dylanastrup/erh2/TeamsFiles_5_1_2023/Test Readiness/image-20230420-182038-73f4511a.jpeg

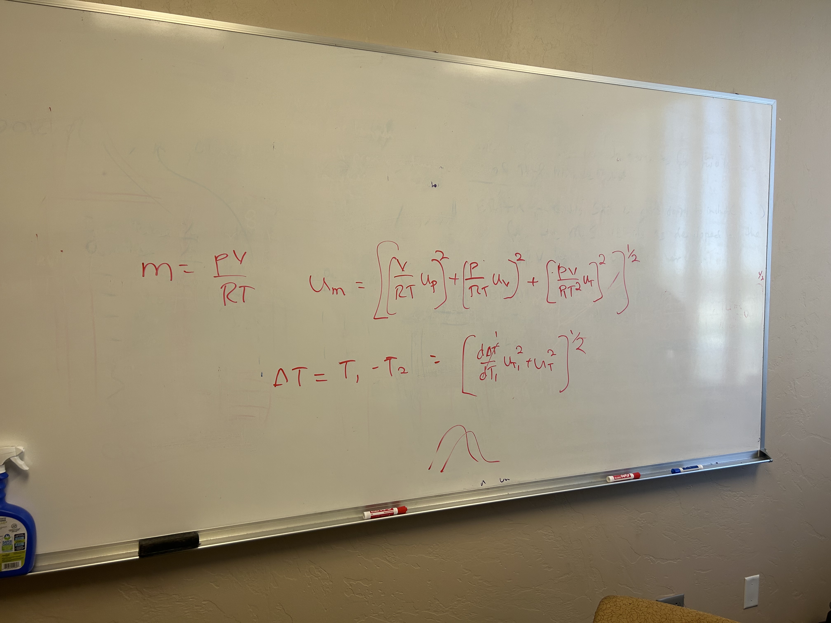
TeamsFiles_5_1_2023/Test Readiness/image-20230420-182038-73f4511a.jpeg
