dylanastrup/erh2/assets/images/grant.png

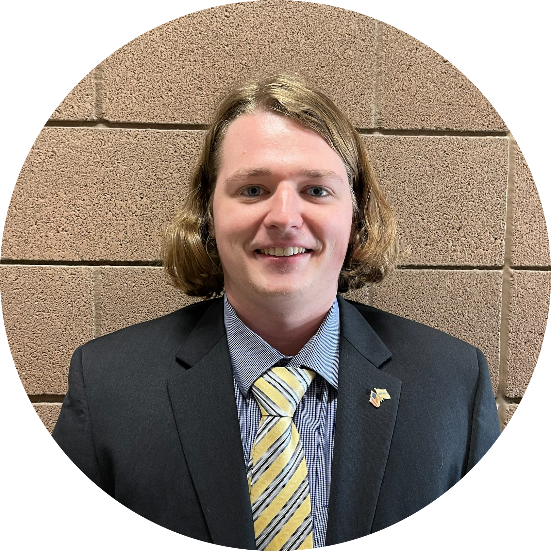
assets/images/grant.png
