dylanastrup/erh2/assets/files/PDR.pdf

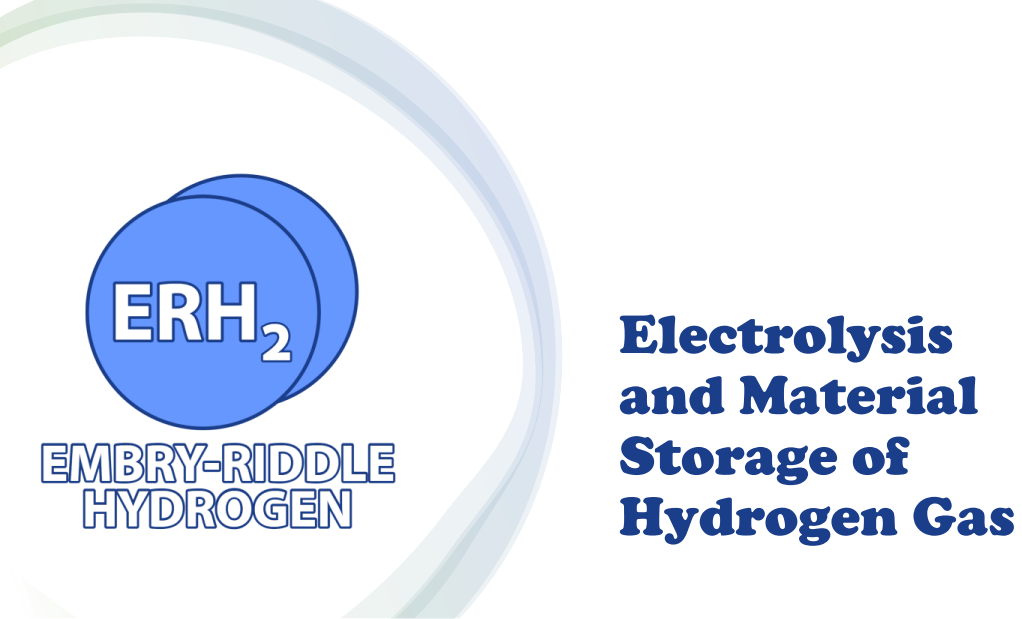
[picture p23: page 1]
Electrolysis and Material Storage of Hydrogen Gas

# Team Members

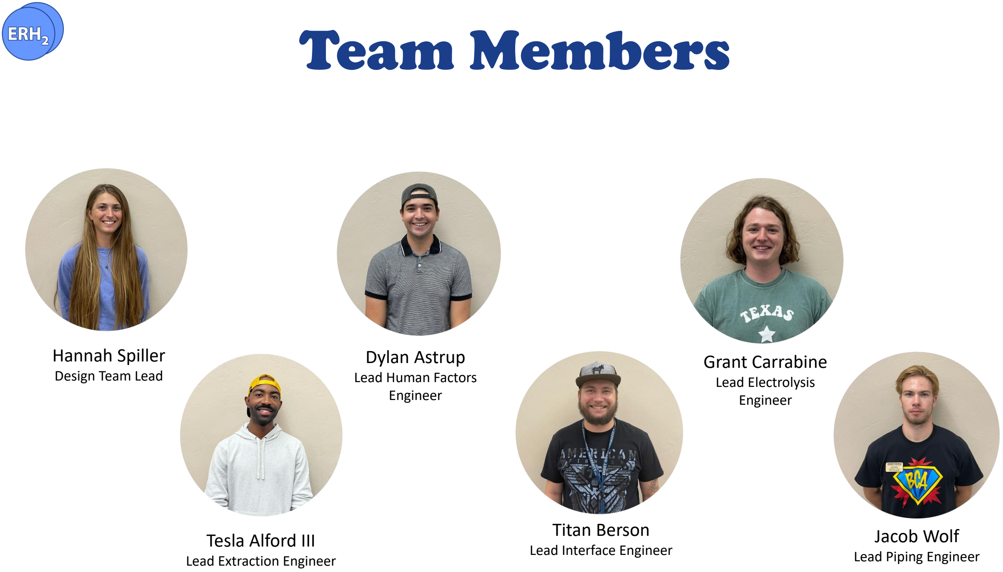
[picture p24: page 2]

Hannah Spiller
Design Team Lead

Tesla Alford III
Lead Extraction Engineer

Dylan Astrup
Lead Human Factors
Engineer

Grant Carrabine
Lead Electrolysis
Engineer

Jacob Wolf
Lead Piping Engineer

Titan Berson
Lead Interface Engineer

# Agenda

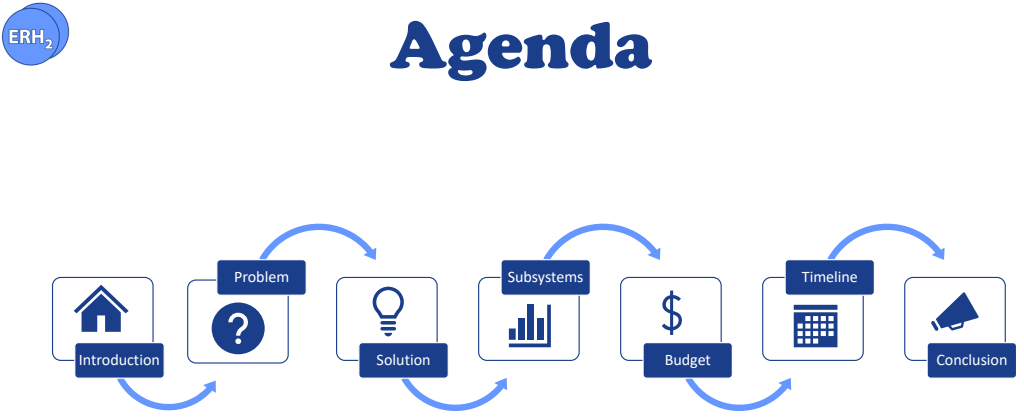
[picture p25: page 3]
Introduction; Problem; Solution; Subsystems; Budget; Timeline; Conclusion

# What Embry-Riddle Has

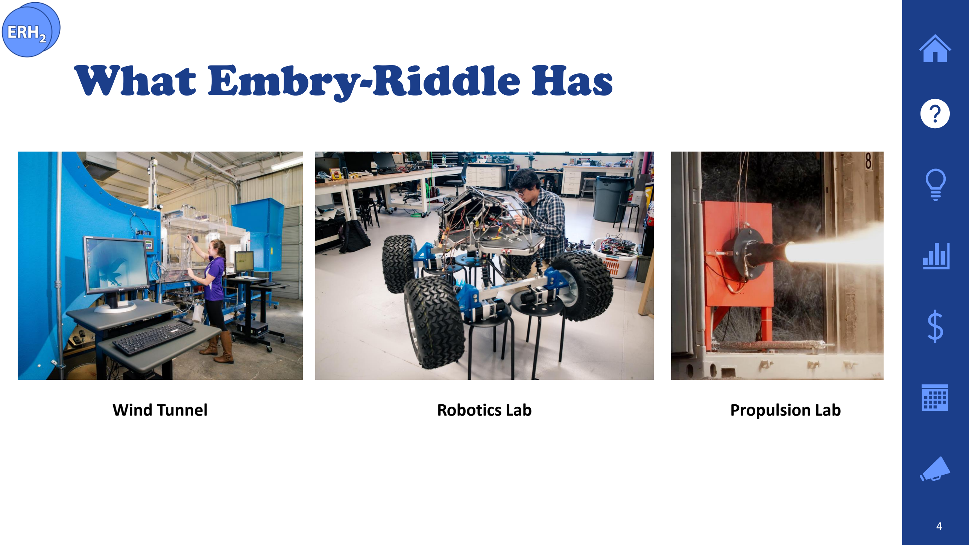
[picture p26: page 4]

Wind Tunnel | Robotics Lab | Propulsion Lab

# Embry-Riddle does not have

# Energy Labs

# Energy Classrooms

# Viewable Demonstrations

# DOE Research into Hydrogen

The DOE is researching multiple uses for hydrogen gas,

## producing the need for more hydrogen. This creates interest within Embry-Riddle to create an alternative energy demonstrator that teaches the general public

about hydrogen fuel and storage.

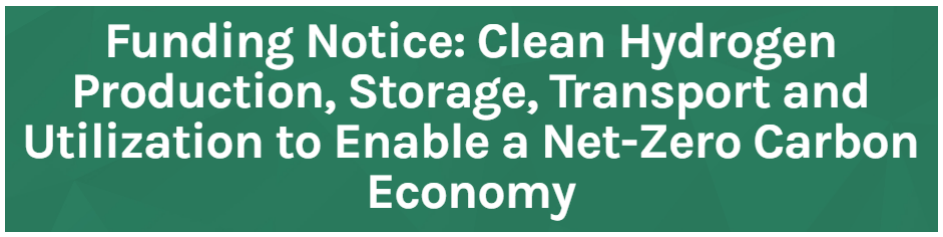
[picture p27: figure]

# Amount: $32 million

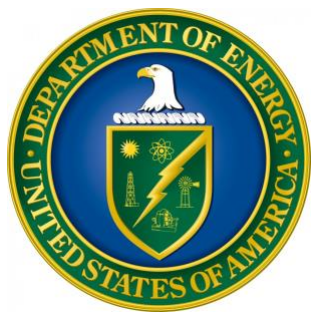
[picture p28: figure]

# Generate and Store Hydrogen

# ERH2’s purpose is to create a demonstrator to generate and

store hydrogen.

# Benefits of ERH2 System

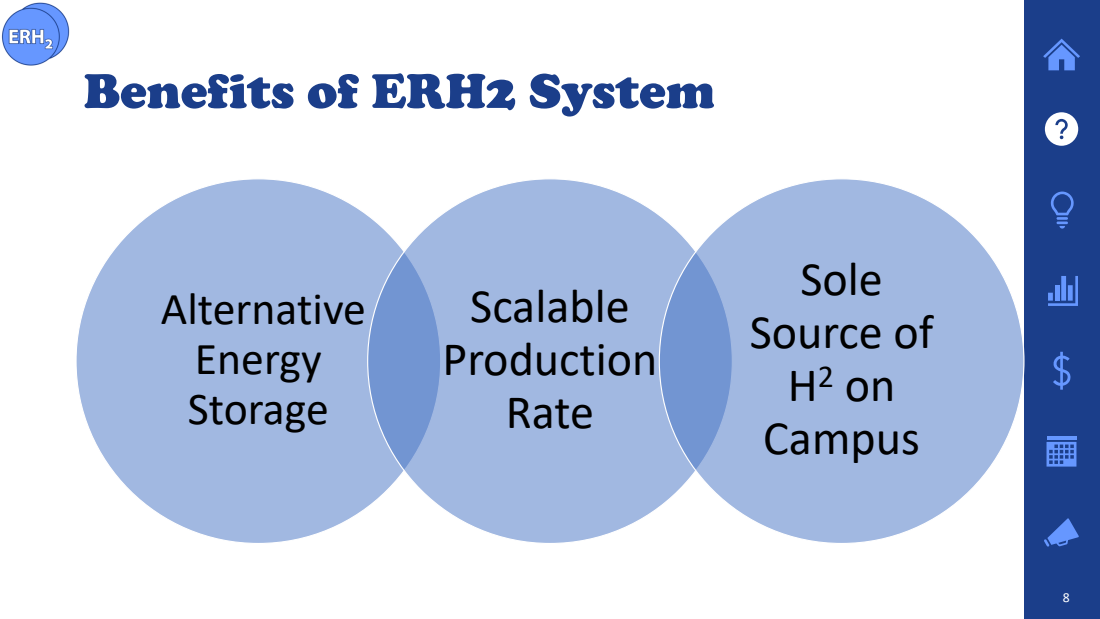
[picture p29: page 8]
Alternative Energy Storage; Scalable Production Rate; Sole Source of H² on Campus

# The ERH2 System

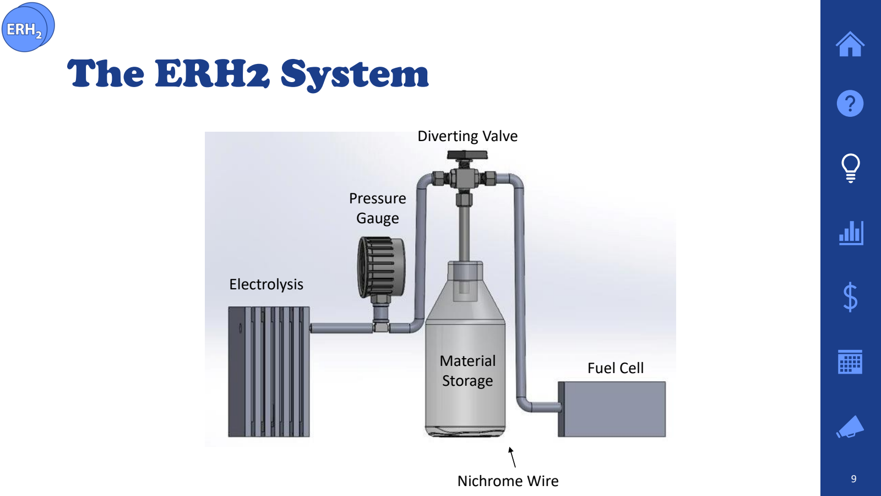
[picture p30: page 9]

Electrolysis

Pressure
Gauge

Nichrome Wire

Material
Storage

Fuel Cell

Diverting Valve

# Process Flow Diagram

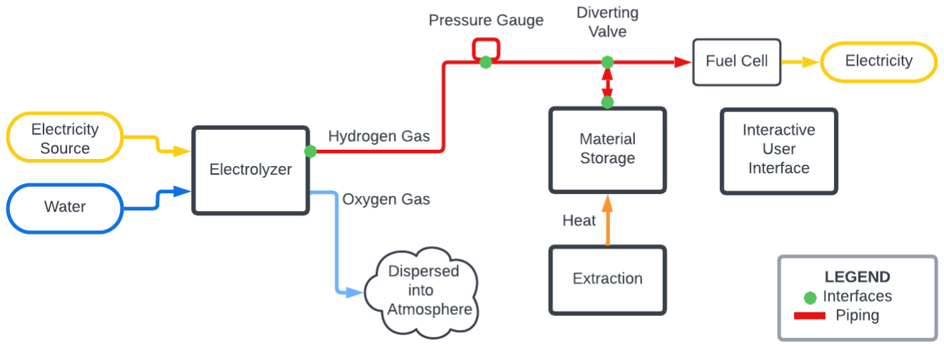
[picture p31: figure]

Simplified PFD

# Critical System Requirements

## Produce 0.02 grams of hydrogen over 10 minutes

## Store 0.04 grams of hydrogen

## Safely extract hydrogen from system

## Internal components visible

# Electrolysis Equation

# 2H2O 2H2 + O2

# Hydrogen Production Requirement

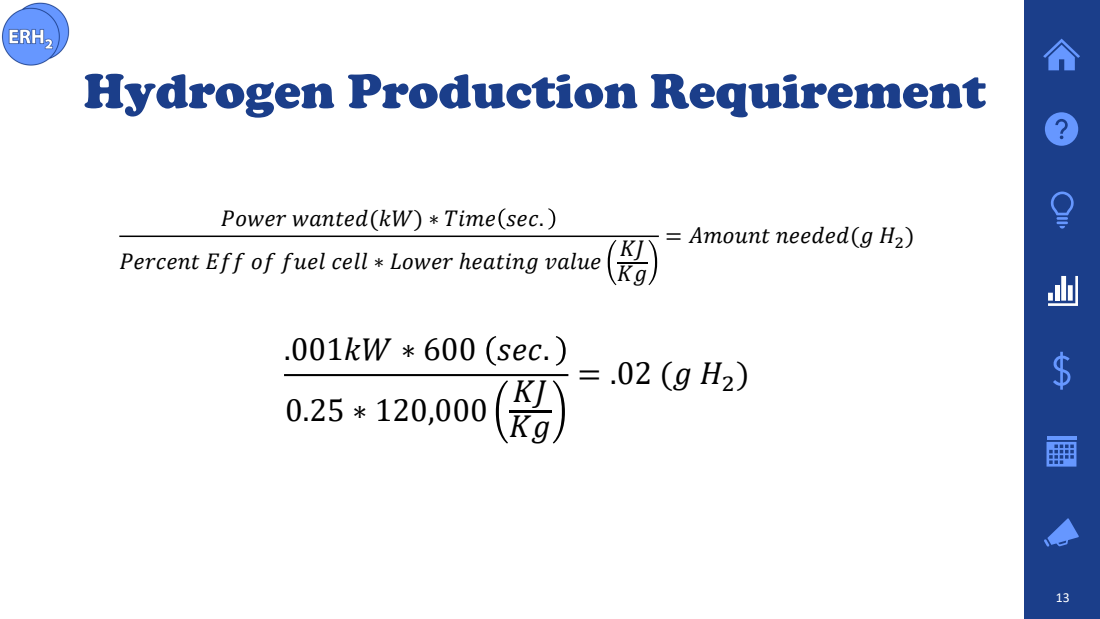
[picture p32: page 13]
= Amount needed(g H2); .001kW ∗ 600 sec. 0.25 ∗ 120,000 KJ Kg

Power wanted(kW) ∗ Time sec.

Percent Eff of fuel cell ∗ Lower ℎeating value KJ

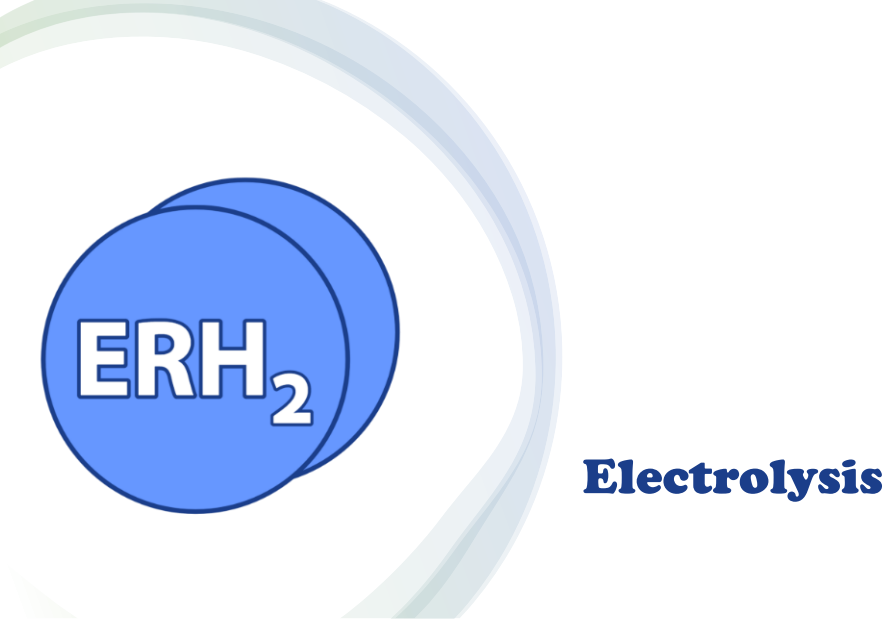
[picture p33: page 14]
Electrolysis

# Electrolysis Breakdown

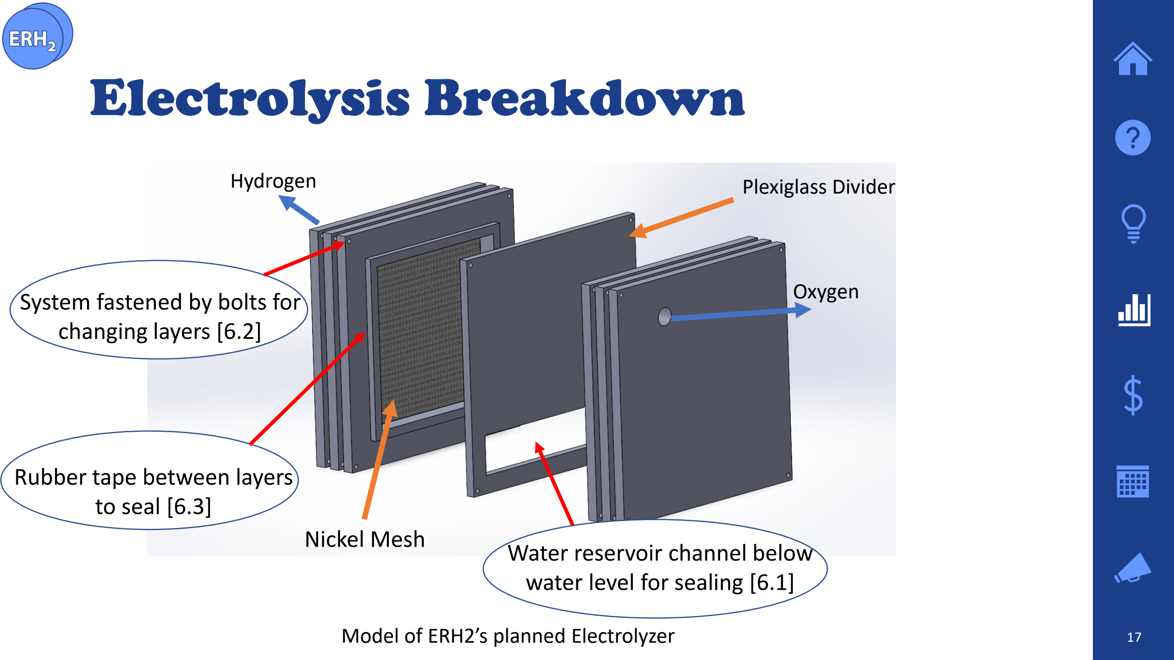
[picture p34: page 15]

Hydrogen | Plexiglass Divider

Nickel Mesh

Model of ERH2’s planned Electrolyzer

Oxygen

Water reservoir channel below water level for sealing [6.1]

System fastened by bolts for changing layers [6.2]

Rubber tape between layers to seal [6.3]

# Mesh Section-View

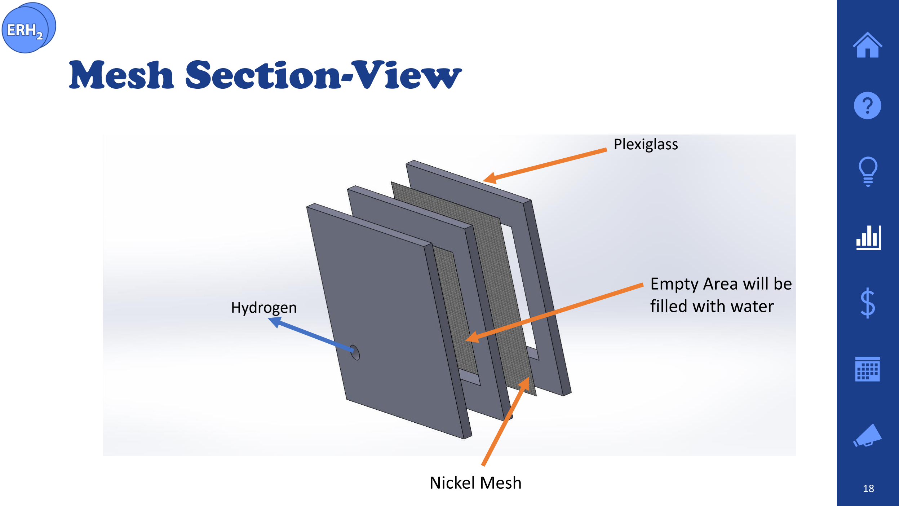
[picture p35: page 16]

Plexiglass

Hydrogen

Nickel Mesh

Empty Area will be
filled with water

# Power Supply

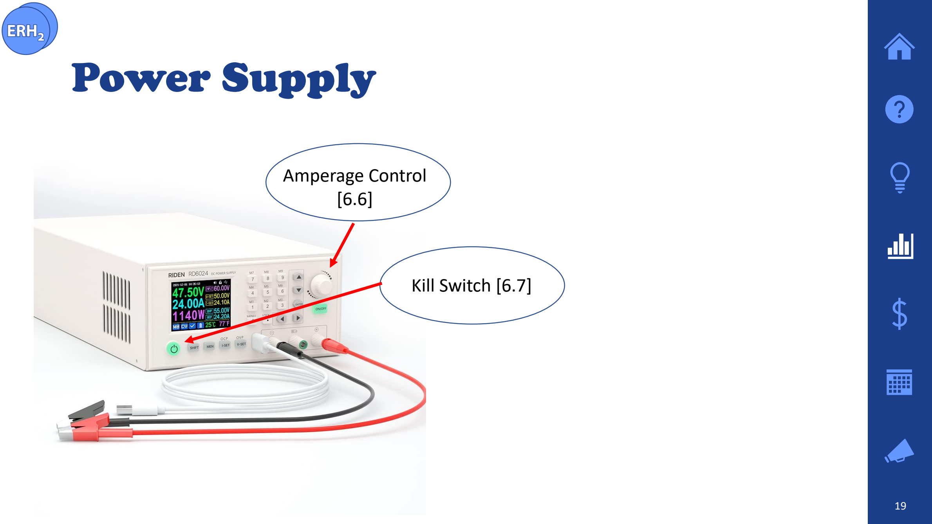
[picture p36: page 17]

## 20-24 Amps 60 Volts

Kill Switch [6.7]

Amperage Control
[6.6]

# Faraday’s Law of Electrolysis

## Rate of H2 Production

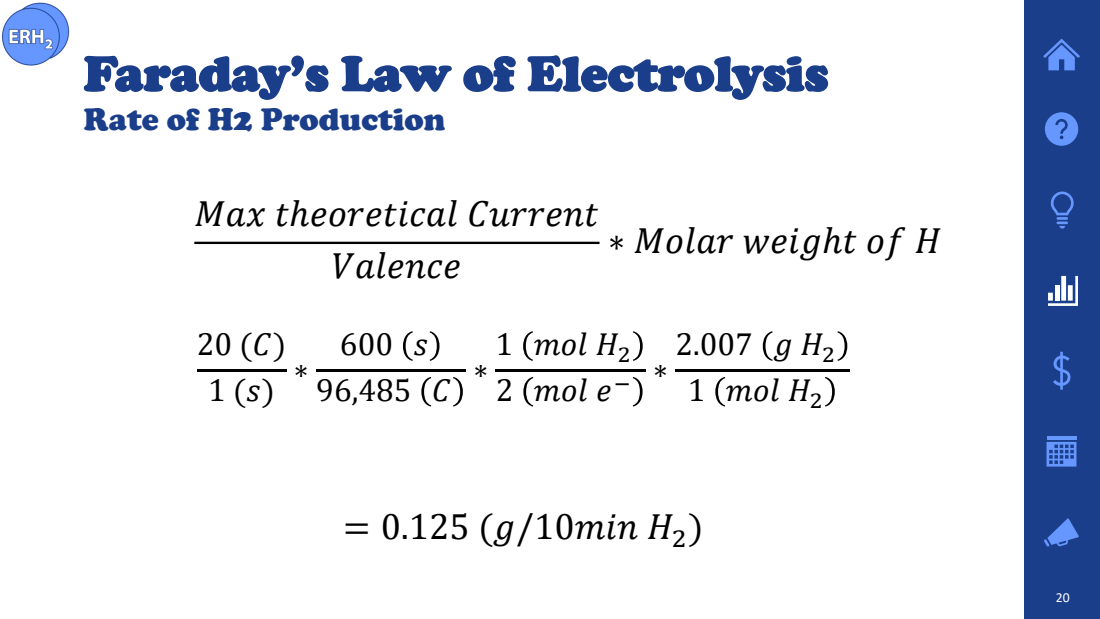
[picture p37: page 18]
1 mol H2 2 mol e; 2.007 g H2 1 mol H2; = 0.125 (g/10min H2); Valence

Max tℎeoretical Current

∗ Molar weigℎt of H

# Electrolysis Power Circuit

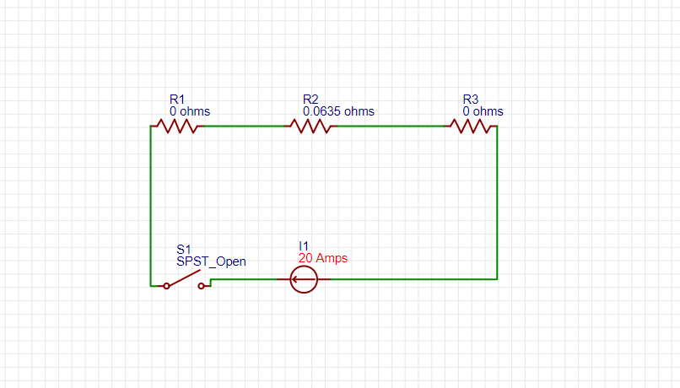
[picture p38: figure]

R1 = R3

# - Nickel Mesh

R2

# - Salt Water

# Electrolysis Summary

Requirement | Design | Expected Performance | Verification
6.1 | The hydrogen and oxygen will be separated at creation | 100% | Fuel Cell Runs
6.2 | The system was designed to be sandwiched together into different layers making it replaceable | Life of bolts used | It will come apart
6.3 Ability to bolt together | | The life span of seals | It will come apart

# Electrolysis Summary

Requirement | Design | Expected Performance | Verification
6.4 | Will be made of plastic | Nonconductive | Voltmeter
6.5 | Will use 12-gauge wire | Rated for 20 amp | National Electrical code
6.6 | Will set power supply to max 20 amps | Max 20 amps | Power supply read out
6.7 | Have and on off switch | 100% | System turns off

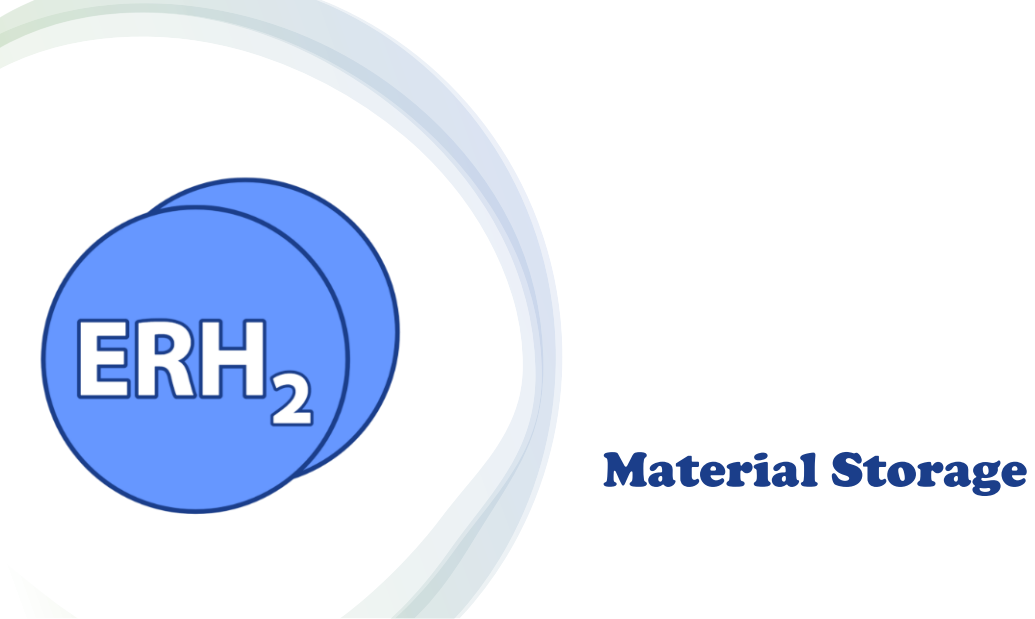
[picture p39: page 22]
Material Storage

# System Requirements

1.2

## “The system must store 0.04 grams of hydrogen gas.”

4.1

### “The material storage efficiency (hydrogen in vs. hydrogen out) must be at least 50%.”

# Lithium-Doped Graphitic Carbon

# Nitride [Li2C4N3/ Li2C4N4]

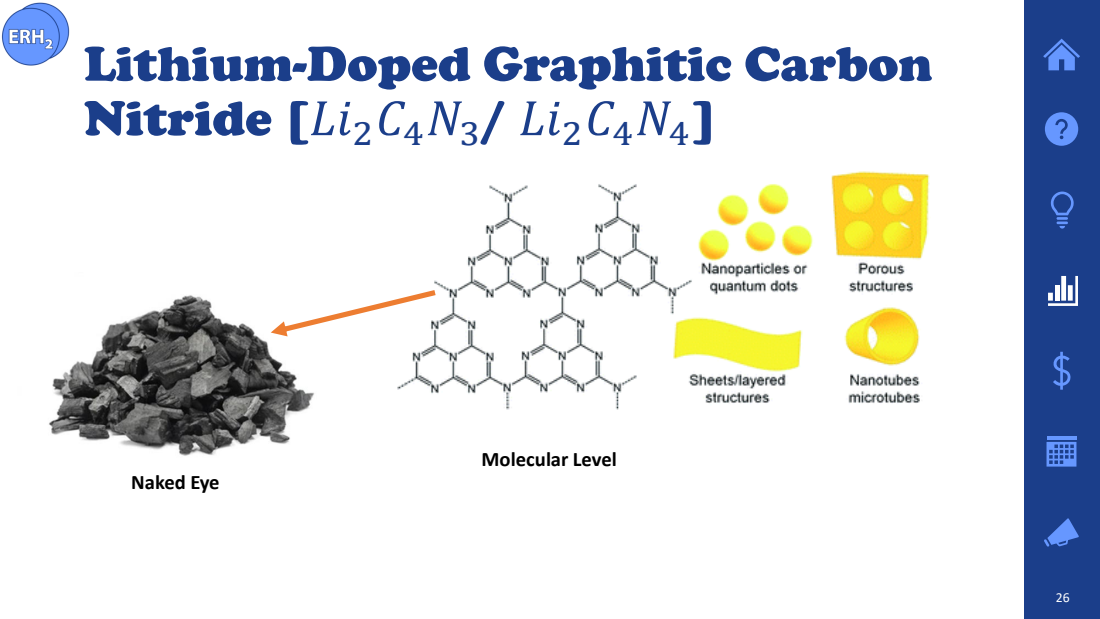
[picture p40: page 24]
Molecular Level; Naked Eye

# Subsystem Definition

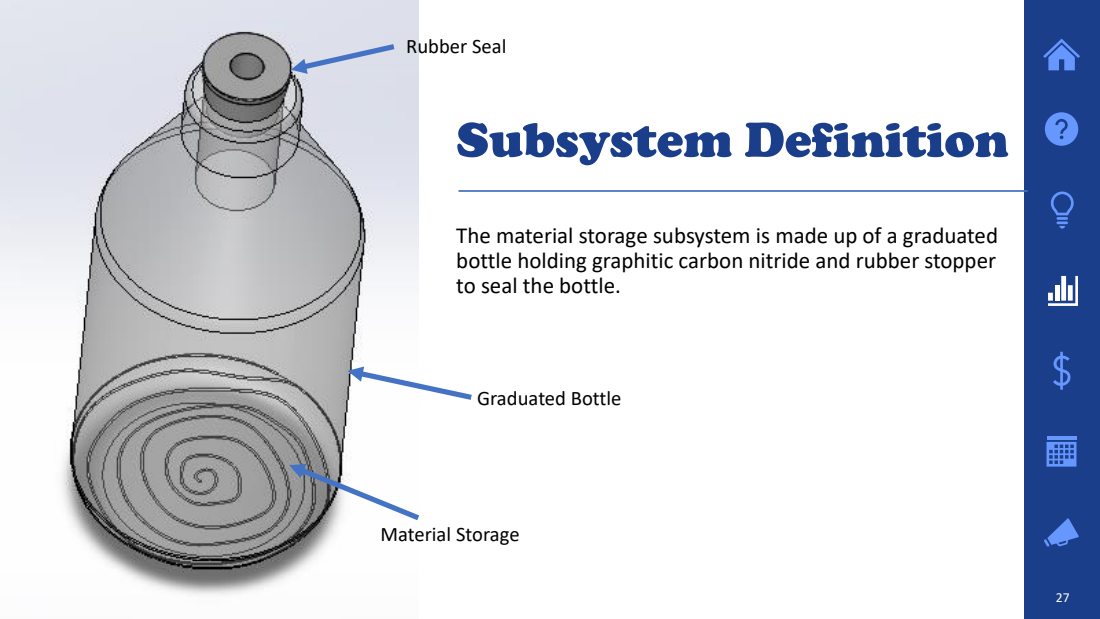
[picture p41: page 25]
Material Storage; Graduated Bottle; Rubber Seal

The material storage subsystem is made up of a graduated
bottle holding graphitic carbon nitride and rubber stopper
to seal the bottle.

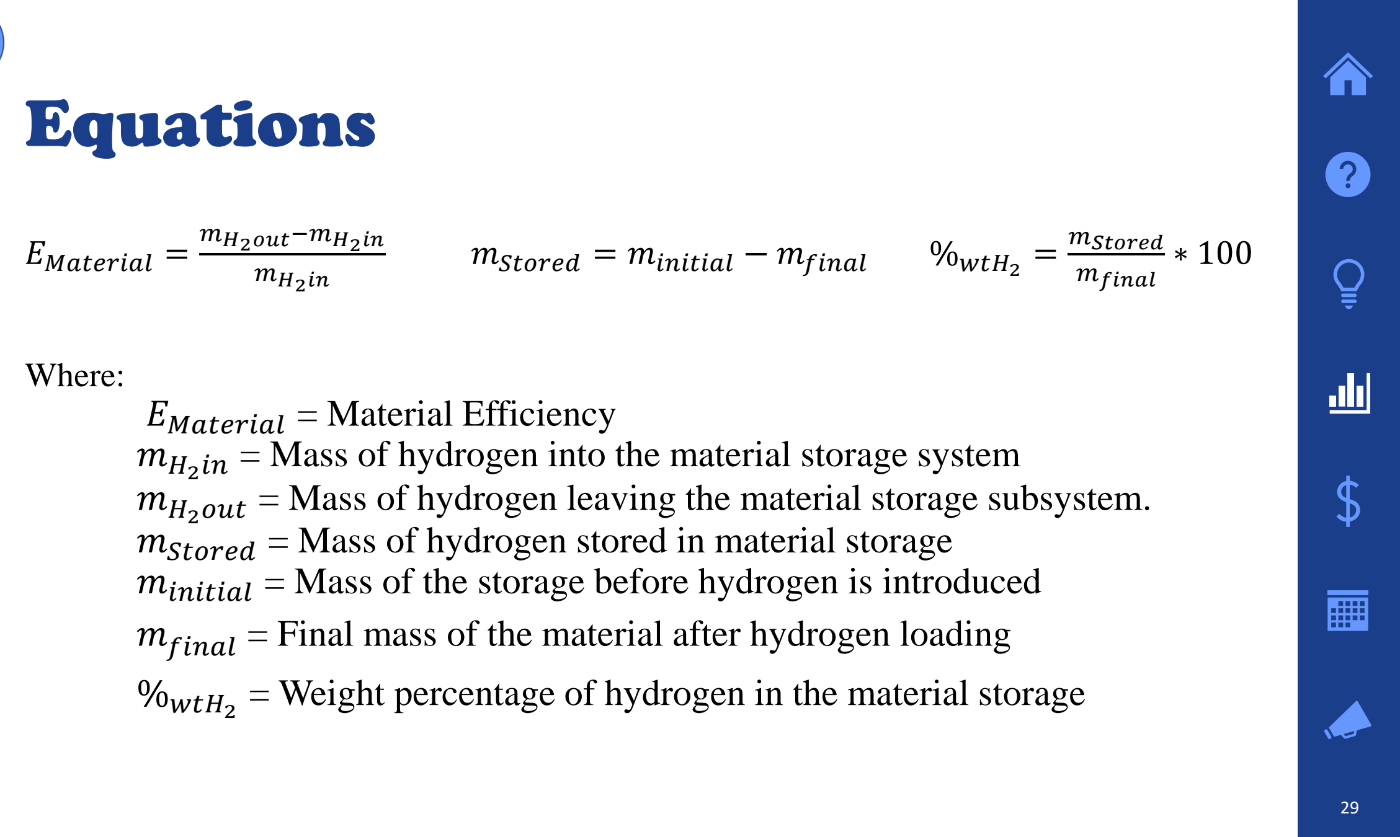
[picture p42: figure]
Equations; EMaterial =; mH2out−mH2in; mStored = minitial − mfinal; %wtH2; mStored; mfinal; Where:; EMaterial = Material Efficiency

### mH2in = Mass of hydrogen into the material storage system

mH2out = Mass of hydrogen leaving the material storage subsystem.

### mStored = Mass of hydrogen stored in material storage minitial = Mass of the storage before hydrogen is introduced mfinal = Final mass of the material after hydrogen loading

### = Weight percentage of hydrogen in the material storage

# 7.1 Release

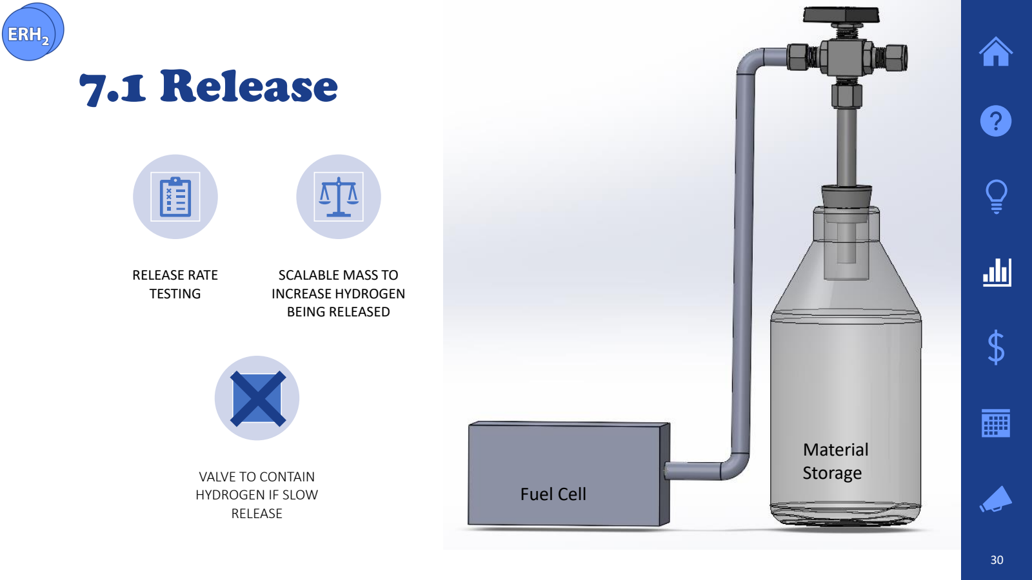
[picture p43: page 27]

RELEASE RATE
TESTING

SCALABLE MASS TO
INCREASE HYDROGEN
BEING RELEASED

VALVE TO CONTAIN
HYDROGEN IF SLOW
RELEASE

Material
Storage
Fuel Cell

# 7.2 Material Capacity

## “…it was found that the gravimetric and volumetric densities of hydrogen in both Li2C4N3 and Li2C4N4 were greater than 10 wt% and 100 g/L respectively” [Wu et al.]

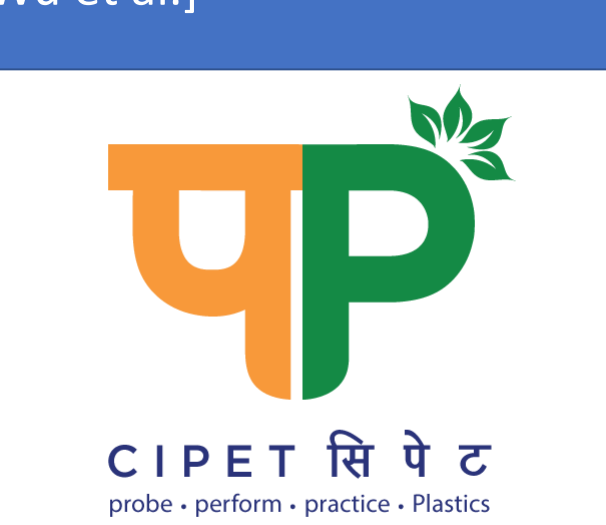
[picture p44: figure]

# 7.3 Material Needed

## 4% yield Urea to Graphitic Carbon Nitride

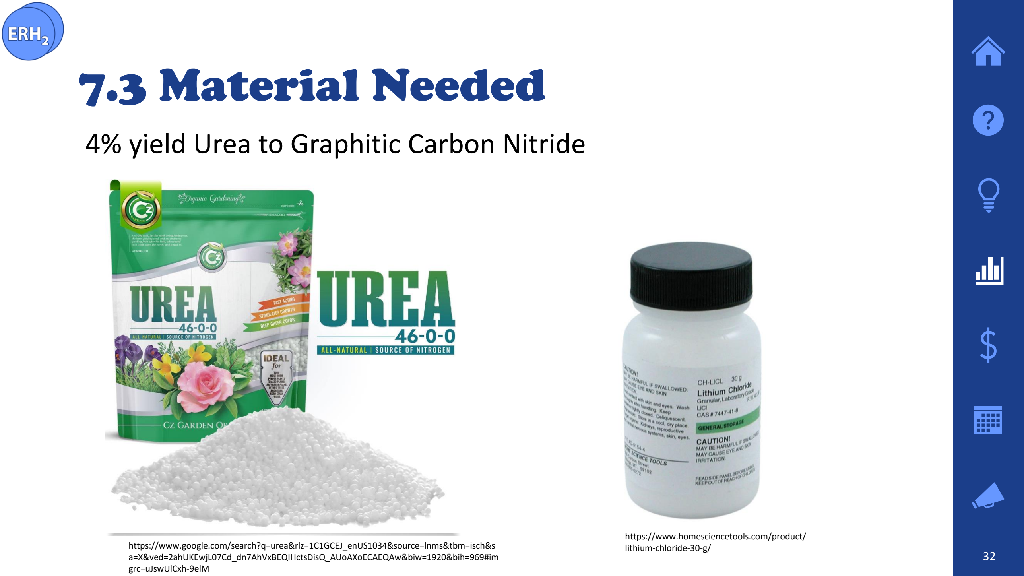
[picture p45: page 29]

https://www.homesciencetools.com/product/
https://www.google.com/search?q=urea&rlz=1C1GCEJ_enUS1034&source=lnms&tbm=isch&s | lithium-chloride-30-g/
a=X&ved=2ahUKEwjL07Cd_dn7AhVxBEQIHctsDisQ_AUoAXoECAEQAw&biw=1920&bih=969#im
grc=uJswUlCxh-9elM

# Storage Summary

Requirement | Design | Expected Performance | Verification
7.1 | Extraction heats material to release temperature | Releases at least 0.02 grams per 10 minutes | Runs the fuel cell
7.2 Doped graphitic carbon nitride | | Capacity of 10% wt hydrogen | Numerically, Greater than 2% Testing
7.3 2 grams of Graphitic Carbon Nitride | | Synthesize 50 grams for 4% yield | Greater than 2 grams

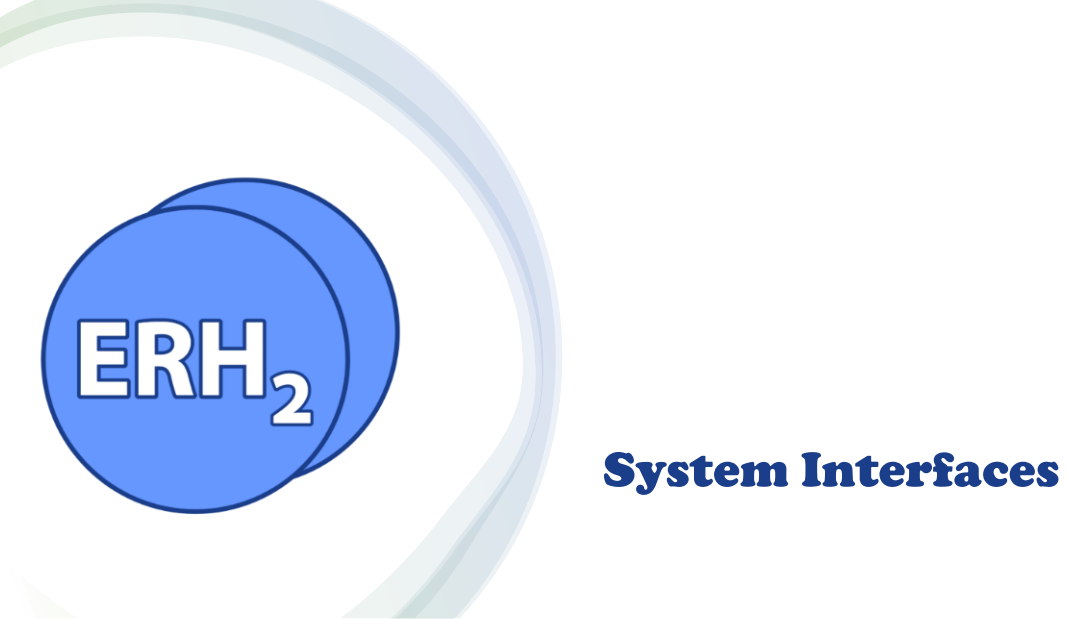
[picture p46: page 31]
System Interfaces

# System Requirements

4.4

## “all subsystem interfaces must be sealed.”

# Interface Map

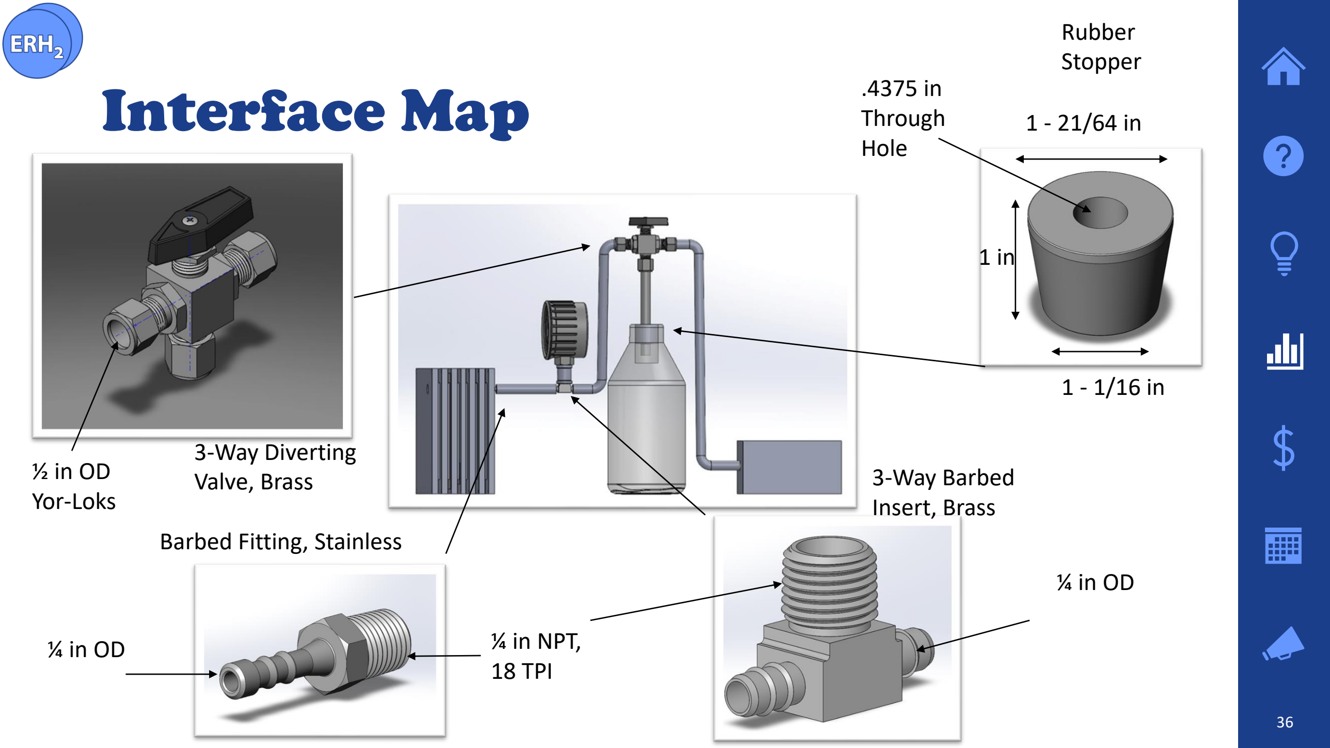
[picture p47: page 33]

3-Way Diverting
Valve, Brass

Barbed Fitting, Stainless

Rubber
Stopper

3-Way Barbed
Insert, Brass

1 in

1 - 1/16 in

1 - 21/64 in

.4375 in
Through
Hole

½ in OD
Yor-Loks
¼ in OD | ¼ in NPT, 18 TPI

¼ in OD

# Detecting Leaks

ERH2 will follow ASHRAE
Bubble Method under
Chapter 29.9 Leak
Detection in the 2017
edition ASHRAE
Handbook.

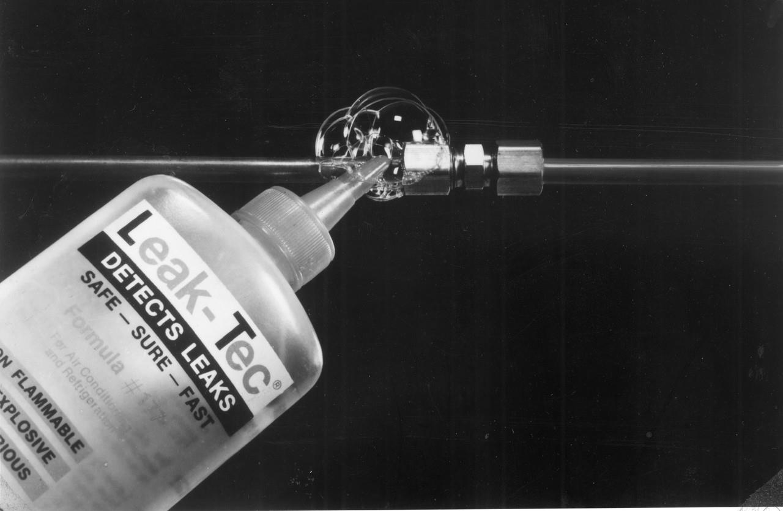
[picture p48: figure]

Fast leakage test – Unitem Wrocław (unitemmachines.com) (https://unitemmachines.com/our-offer/fast-leakage-test/)

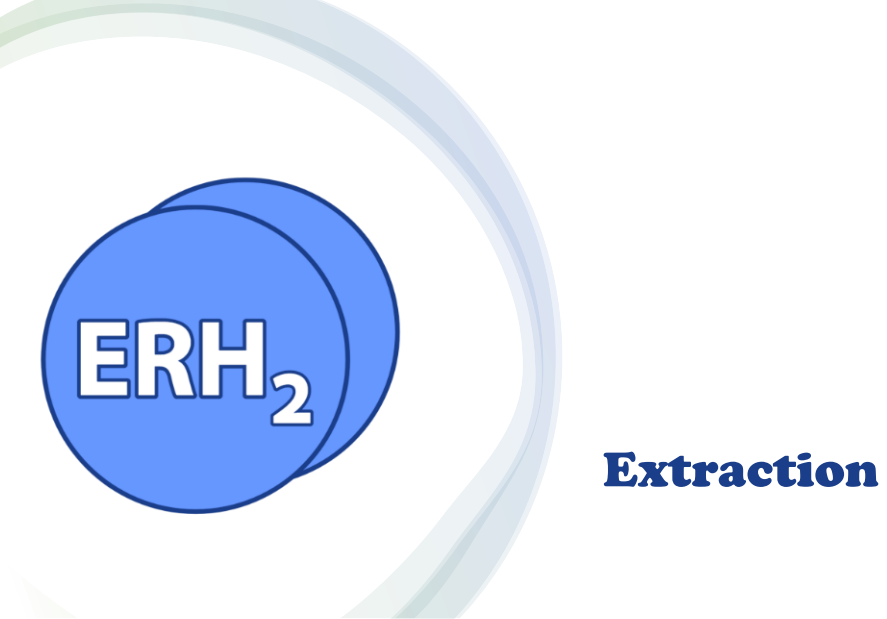
[picture p49: page 35]
Extraction

# System Requirements

2.1

## “The system must allow for safe extraction of hydrogen gas without risk of major leaks.”

4.3

## “The material storage to fuel cell system must be able to run for 10 minutes.”

# Heating Element – Nichrome Wire

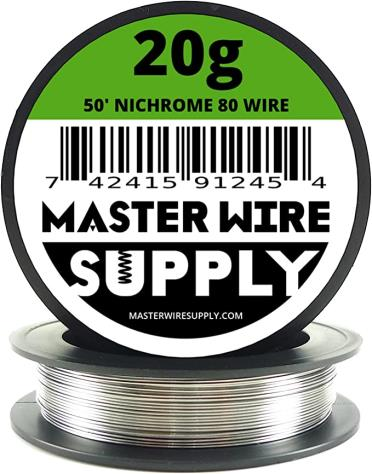
[picture p50: figure]

-Remington Industries

## Target Temperature: 300°C Maximum Temperature: 350°C

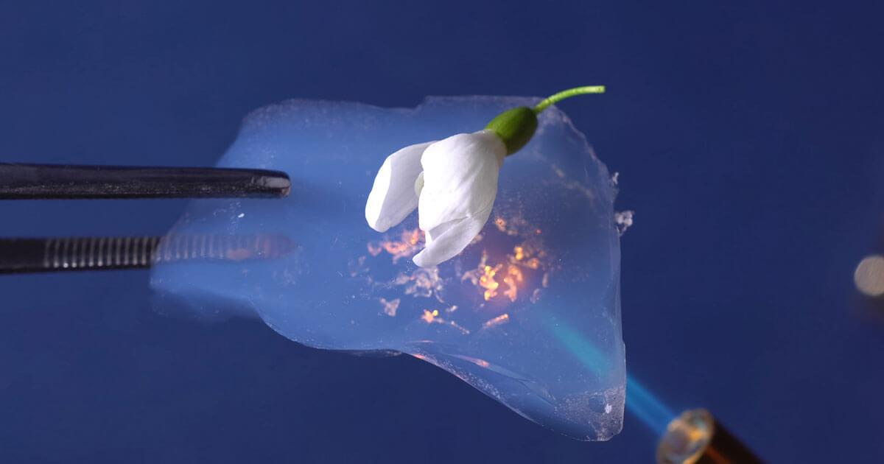
[picture p51: figure]

Thermal Insulation:

Aerogel - 650 °C

# Heat Loss Calculations

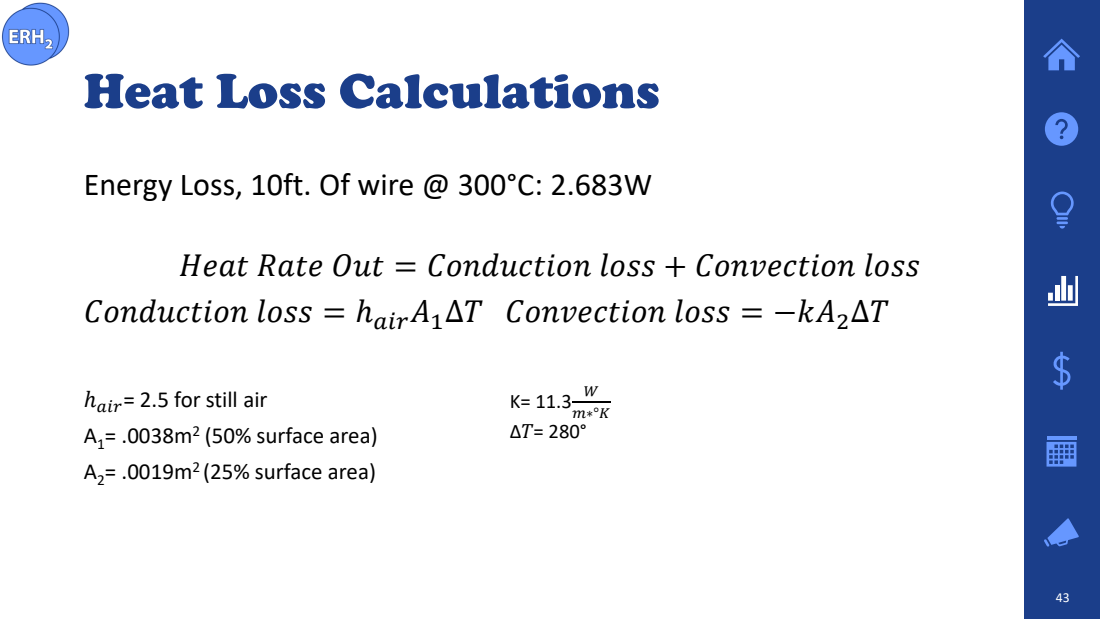
[picture p52: page 38]
(50% surface area)

Energy Loss, 10ft. Of wire @ 300°C: 2.683W

Heat Rate Out = Conduction loss + Convection loss
Conduction loss = ℎairA1∆T Convection loss = −kA2∆T

ℎair= 2.5 for still air
A2= .0019m² (25% surface area)

# Power Input Calculations

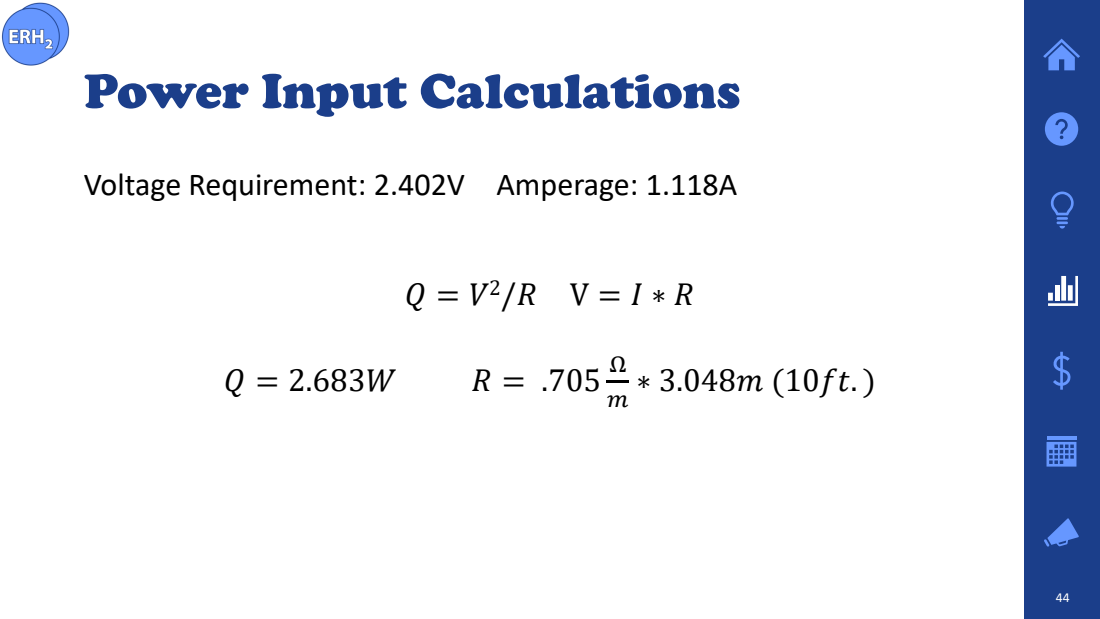
[picture p53: page 39]

Voltage Requirement: 2.402V Amperage: 1.118A

# Vessel Pressure

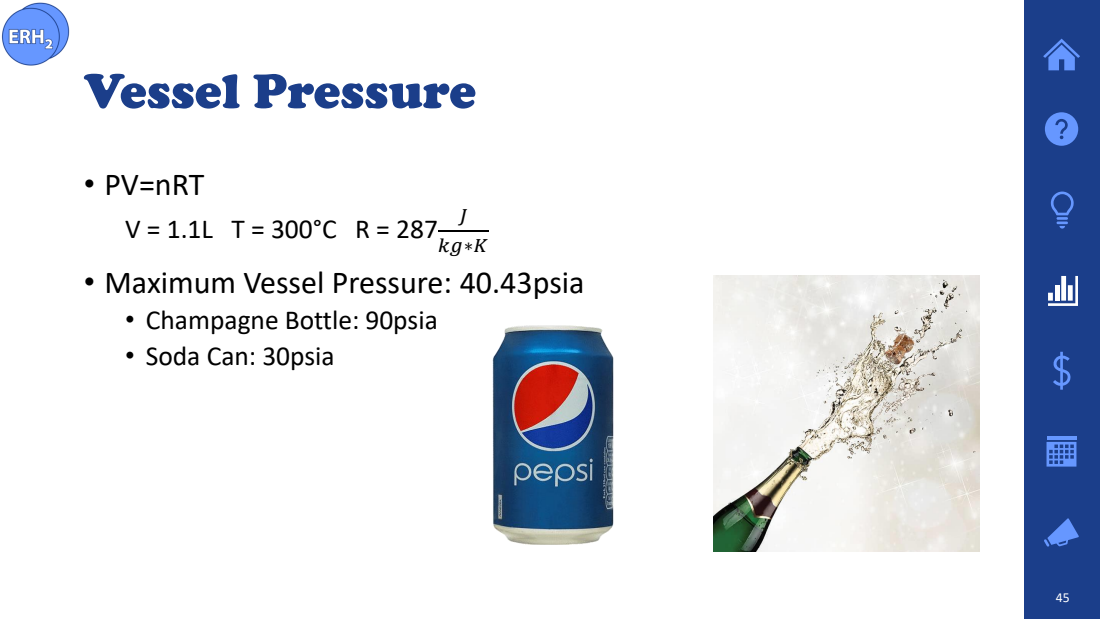
[picture p54: page 40]
• PV=nRT V = 1.1L T = 300°C R = 287 J kg∗K

• Maximum Vessel Pressure: 40.43psia
• Champagne Bottle: 90psia
• Soda Can: 30psia

# Extraction Summary

Requirement | Design | Expected Performance | Verification
9.1 | Nichrome wire achieves steady state temperature of 300°C | Hydrogen release from storage medium | Fuel cell produces electricity
9.2 | Voltage supplied to Nichrome wire ≈ 2.4V | Steady state temp. < 350°C | Thermal Camera (Propulsion Lab)

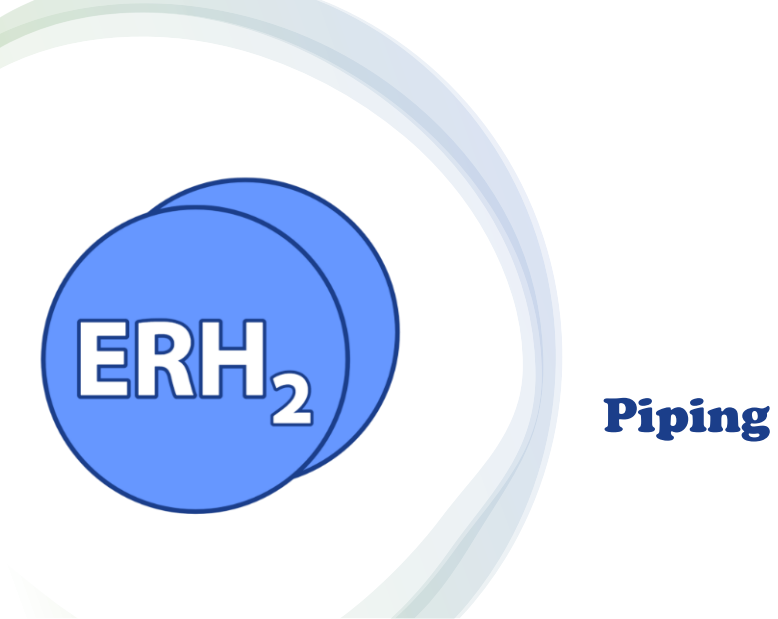
[picture p55: page 42]
Piping

# Piping Layout PTFE Tubing

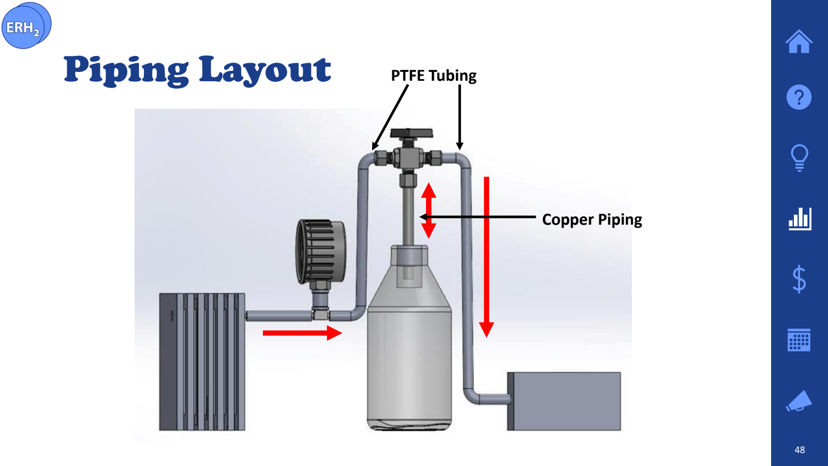
[picture p56: page 43]

Copper Piping

# Heat Transfer Analysis

## 1. Use a 6in long pipe at constant 100°C that reduces internal gas

temperature from 300°C to 150°C to determine flow regime.

## 2. Analyze 0.0001in long sections where pipe is average temperature

of internal and external air.

# Piping Requirement Summary

Requirement | Design | Expected Performance | Verification
10.1 | PTFE tubing and copper pipe. | Transportation of hydrogen gas | Pressure gauge, mass of material storage, operation of fuel cell
10.2 | Material chosen to withstand pressures. | No leaks | Bubble method
10.3 Copper piping sufficiently transfers heat. | | Temperature reduced to 50°C at diverting valve | Thermal imaging

Hard Copper Pipe 0.5”OD x 0.05”Wall Thickness x 2.63” Long PTFE Tubing 0.31”OD x 0.03” Wall Thickness x 2’ Long

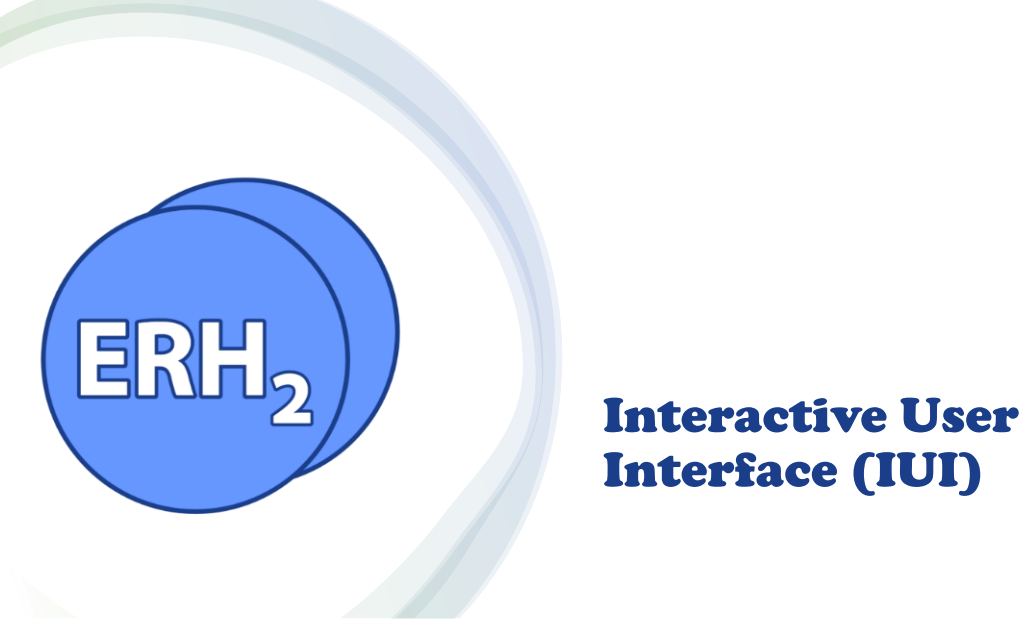
[picture p57: page 46]
Interactive User Interface (IUI)

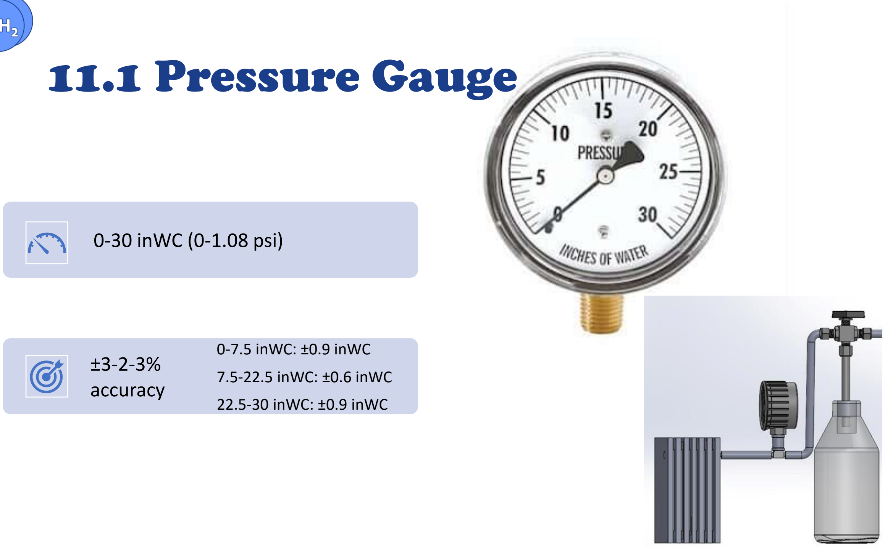
[picture p58: figure]
11.1 Pressure Gauge; 0-30 inWC (0-1.08 psi); ±3-2-3% accuracy; 0-7.5 inWC: ±0.9 inWC; 7.5-22.5 inWC: ±0.6 inWC; 22.5-30 inWC: ±0.9 inWC

Governing Equations | In. wc | PSI | Grams of Hydrogen
0 | 0 | 0
1 | 0.0360912 | 0.000247124
2 | 0.0721824 | 0.000494249
3 | 0.1082736 | 0.000741373
4 | 0.1443648 | 0.000988497
5 | 0.180456 | 0.001235621
6 | 0.2165472 | 0.001482746
7 | 0.2526384 | 0.00172987
8 | 0.2887296 | 0.001976994
9 | 0.3248208 | 0.002224119
10 | 0.360912 | 0.002471243
11 | 0.3970032 | 0.002718367
12 | 0.4330944 | 0.002965492
13 | 0.4691856 | 0.003212616
14 | 0.5052768 | 0.00345974
15 | 0.541368 | 0.003706864
16 | 0.5774592 | 0.003953989
17 | 0.6135504 | 0.004201113
18 | 0.6496416 | 0.004448237
19 | 0.6857328 | 0.004695362
20 | 0.721824 | 0.004942486
21 | 0.7579152 | 0.00518961
22 | 0.7940064 | 0.005436735
23 | 0.8300976 | 0.005683859
24 | 0.8661888 | 0.005930983
25 | 0.90228 | 0.006178107
26 | 0.9383712 | 0.006425232
27 | 0.9744624 | 0.006672356
28 | 1.0105536 | 0.00691948
29 | 1.0466448 | 0.007166605
30 | 1.082736 | 0.007413729

## PV = nRT

### Where: P = Absolute pressure of the gas (KPa) V = Volume of the gas (L) n = Amount of the gas (g) R = Ideal gas constant (KJ/Kg*K) T = Absolute temperature of the gas (K)

# 11.2 Mass Measurement

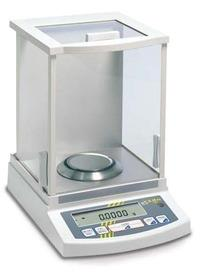
[picture p59: figure]
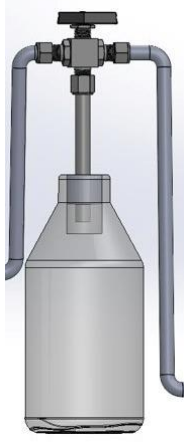
[picture p60: figure]

# 11.3 Infographic

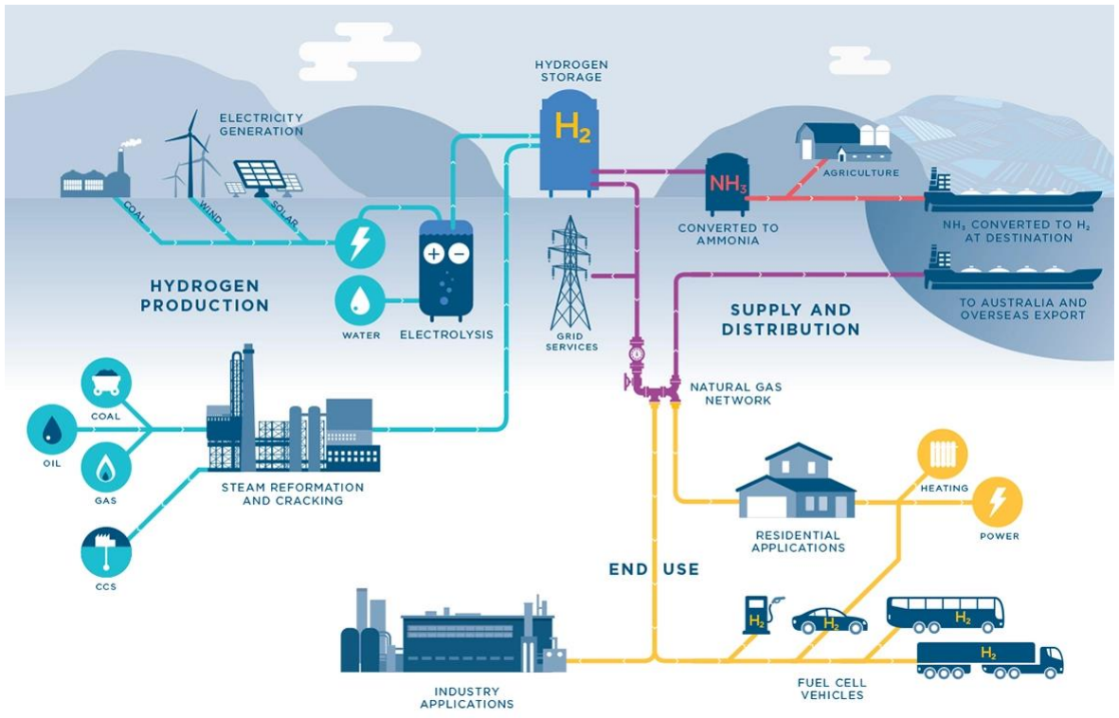
[picture p61: figure]

Hydrogen Economy Infographic – Herbert Smith Freehills (https://www.herbertsmithfreehills.com/latest-thinking/hydrogen)

# IUI Summary

Requirement | Design | Expected Performance | Verification
11.1 0-30 inWC Pressure Gauge | | Display accurate pressure of system | Visual Inspection
11.2 Chemistry lab digital scale | | Display mass of hydrogen in storage system | Visual Inspection
11.3 Hydrogen Economy Infographic | | Inform about hydrogen economy | Visual Inspection
11.4 | Pressure gauge and scale have measurement displays | Display measurements | Visual Inspection
11.5 | Pressure gauge and scale have English unit on the displays | English Units | Visual Inspection

# Risk Matrix – Before Mitigation

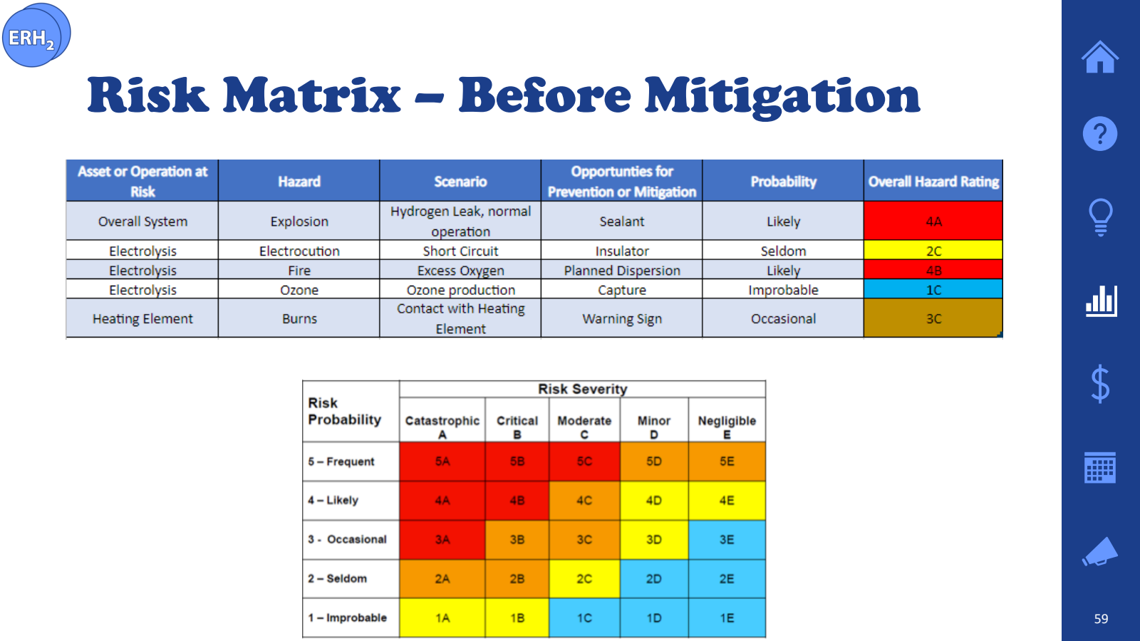
[picture p62: page 52]

# Risk Matrix – After Mitigation

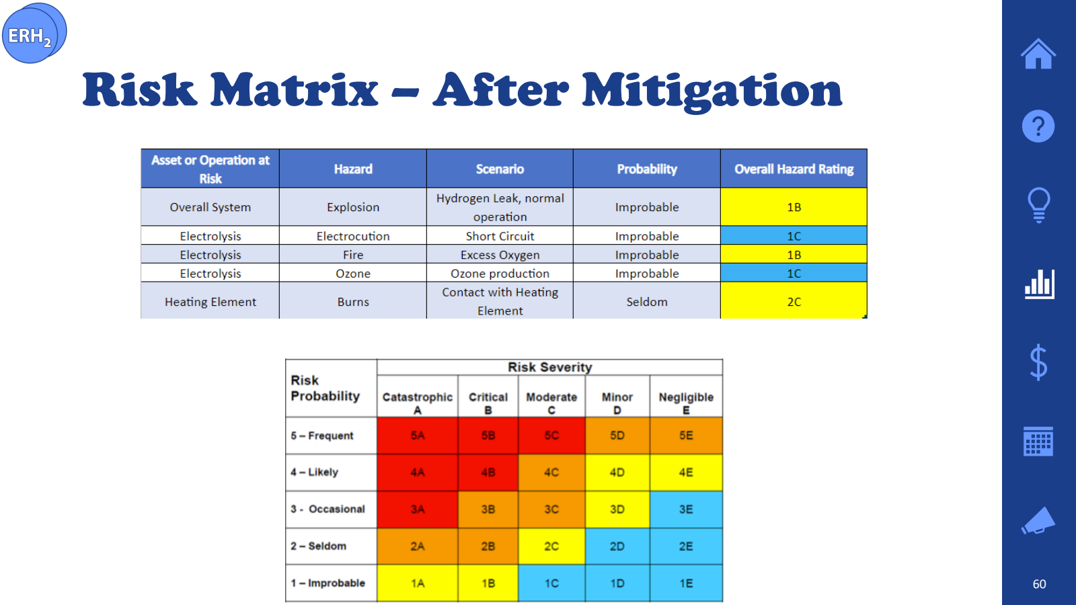
[picture p63: page 53]

# Budget

Item | Cost
Shirts | $150.00
Urea | $20.00
lithium Chloride 30grams | $17.90
Plexiglass | $84.56
Pressure gauge | $35.65
Mesh X 2 | $22.00
PTFE Tubing x 25ft | $62.25 F-F Thread Adapter x2 $19.12
Bolts | $7.60
Copper Pipe (2ft) | $5.49
Barbed T fitting x 2 | $24.28
Barbed Fitting x3 | 9.02
Graduated Bottle | 91.64
Nichrome Wire 20gauge x 50ft | $12.00
Solder | $30
Rubber Plug | $10.42
Rubber Tape (25ft) | 18.37
Diverting Valve | 123.84
Epoxy's | $30
nuts | $2.20
Other Plastic | $88.04
Power Supply | $289.99
Total
$1,154.37

# Schedule

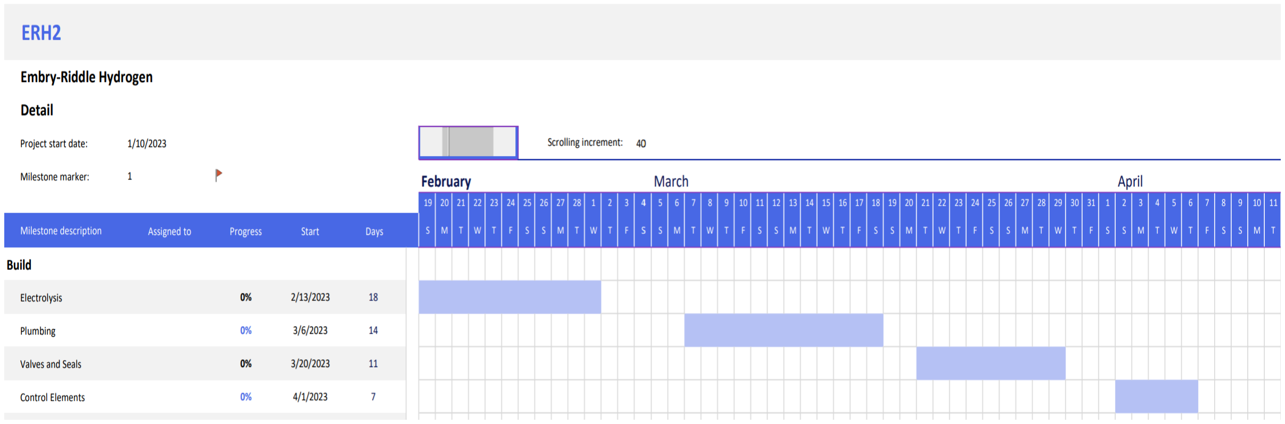
[picture p64: figure]

# Acknowledgements

- Dr. Karl Heine
- Dr. Johnathan Adams
- Dr. Richard DiPietro
- Dr. Istemi Ozsoy
- Dr. David Lanning
- AXFAB Staff
- Taylor Spiller

# Questions?

Additional Slides • Requirements • Generation • Natural Gas • Photobiological • Microbial Biomass conversion • Storage • Physical • Material • Equations • Graphic Design • Schedule

# Requirements Matrix

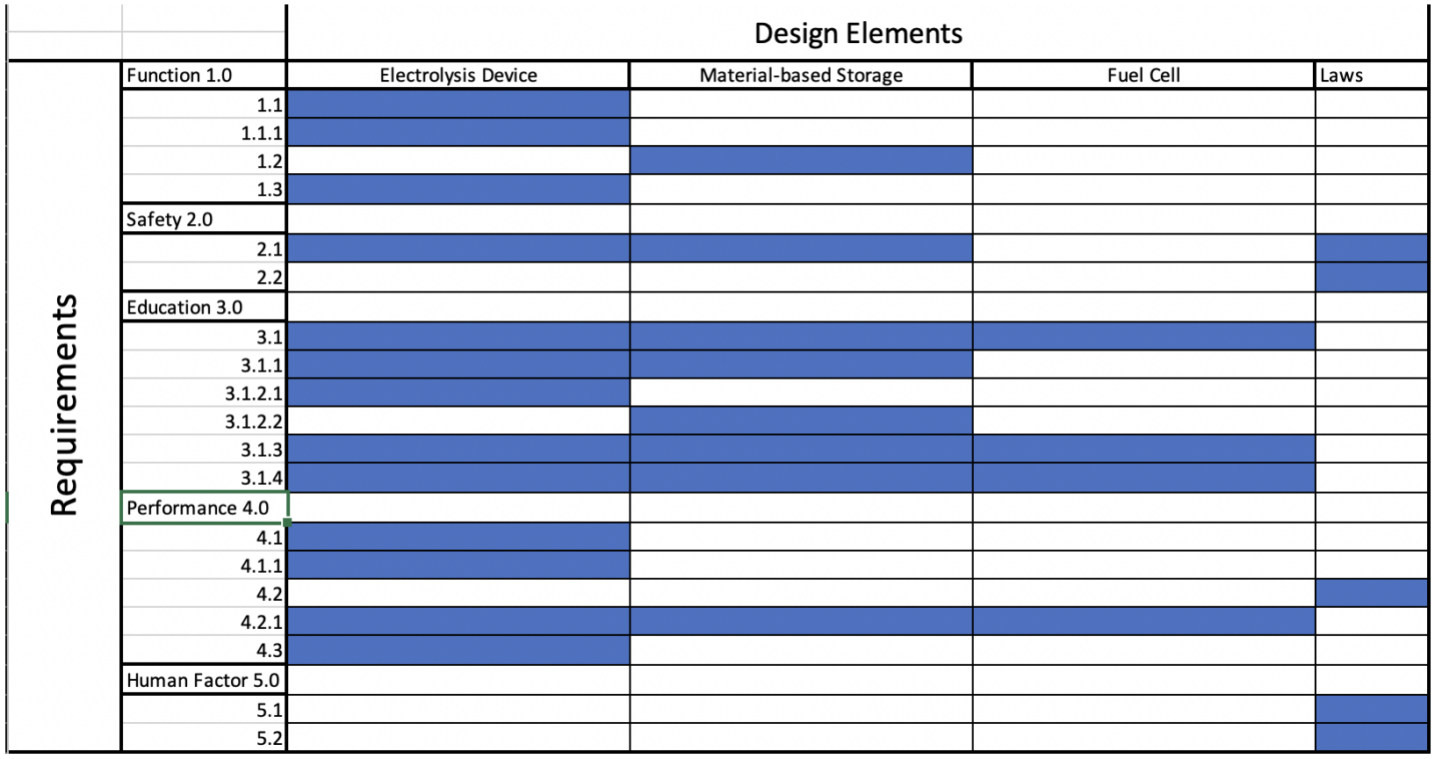
[picture p65: figure]

# Generation - Natural Gas

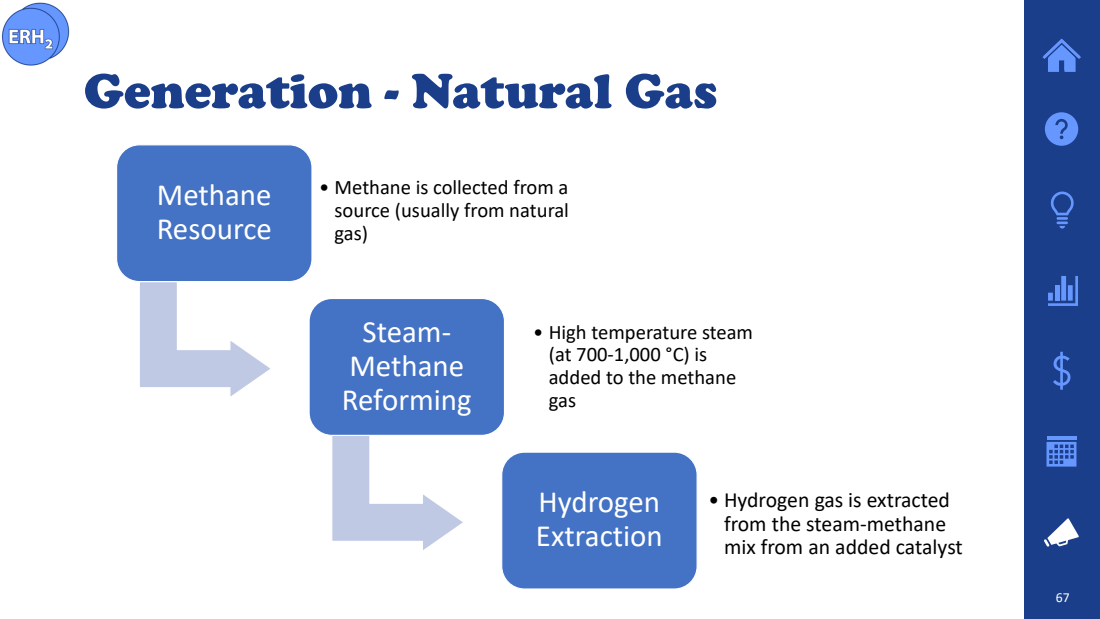
[picture p66: page 60]
Methane Resource; Steam- Methane Reforming; Hydrogen Extraction

• Methane is collected from a
source (usually from natural
gas)

• High temperature steam
added to the methane
gas

• Hydrogen gas is extracted
from the steam-methane
mix from an added catalyst

# Generation - Photobiological

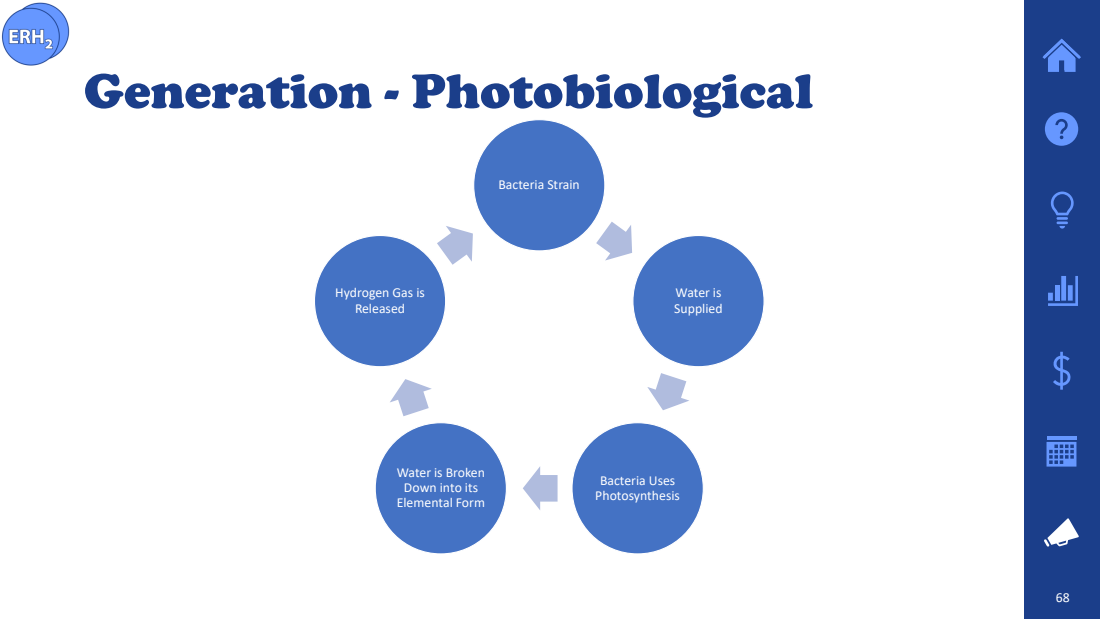
[picture p67: page 61]
Bacteria Strain; Water is Supplied; Bacteria Uses Photosynthesis

Hydrogen Gas is
Released

Water is Broken
Down into its
Elemental Form

# Generation - Microbial Biomass Conversion

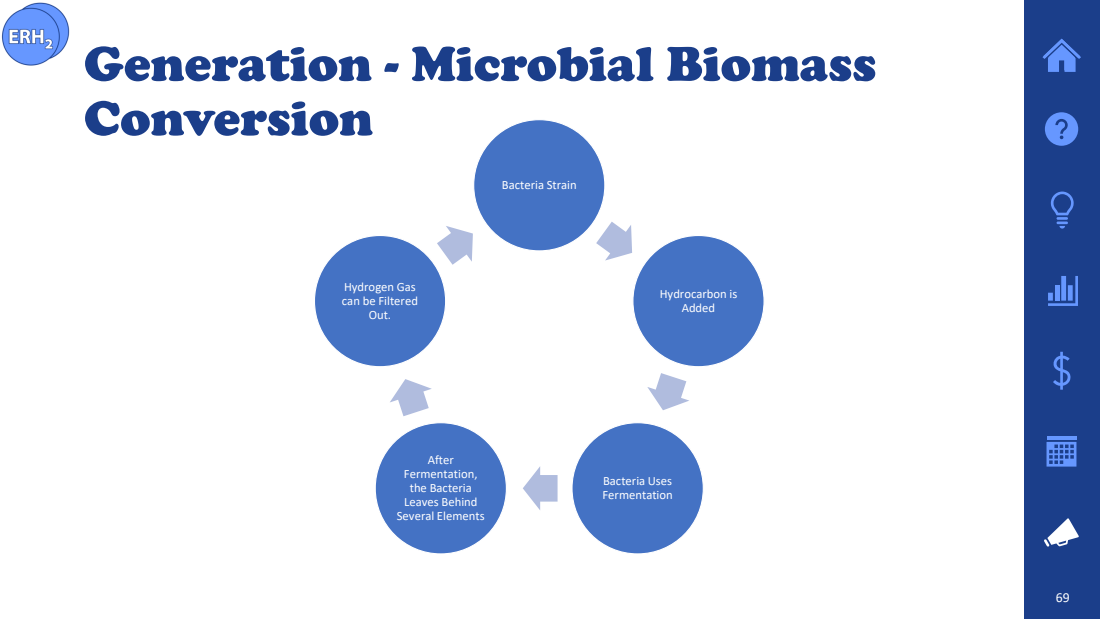
[picture p68: page 62]
Bacteria Strain; Hydrocarbon is Added; Bacteria Uses Fermentation; After Fermentation, the Bacteria Leaves Behind Several Elements

Hydrogen Gas
can be Filtered
Out.

# Storage – Physical Storage

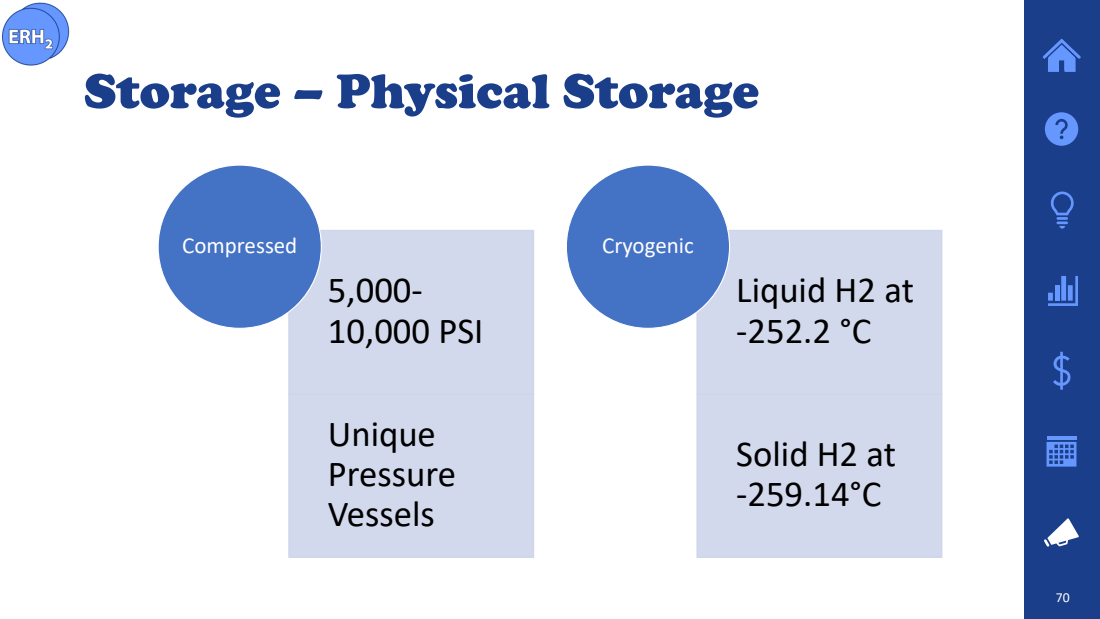
[picture p69: page 63]
5,000- 10,000 PSI; Unique Pressure Vessels; Compressed; Liquid H2 at -252.2 °C; Solid H2 at -259.14°C; Cryogenic

# Storage – Material Storage

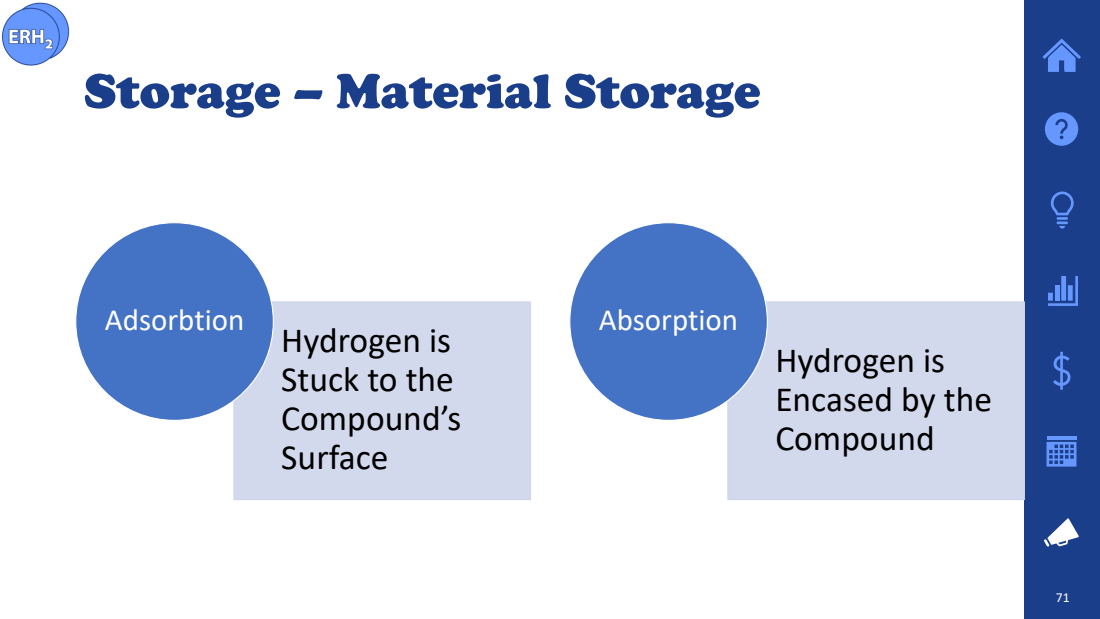
[picture p70: page 64]
Adsorbtion; Absorption

Hydrogen is
Stuck to the
Compound’s
Surface

Encased by the
Compound

# Equations – Area of Mesh

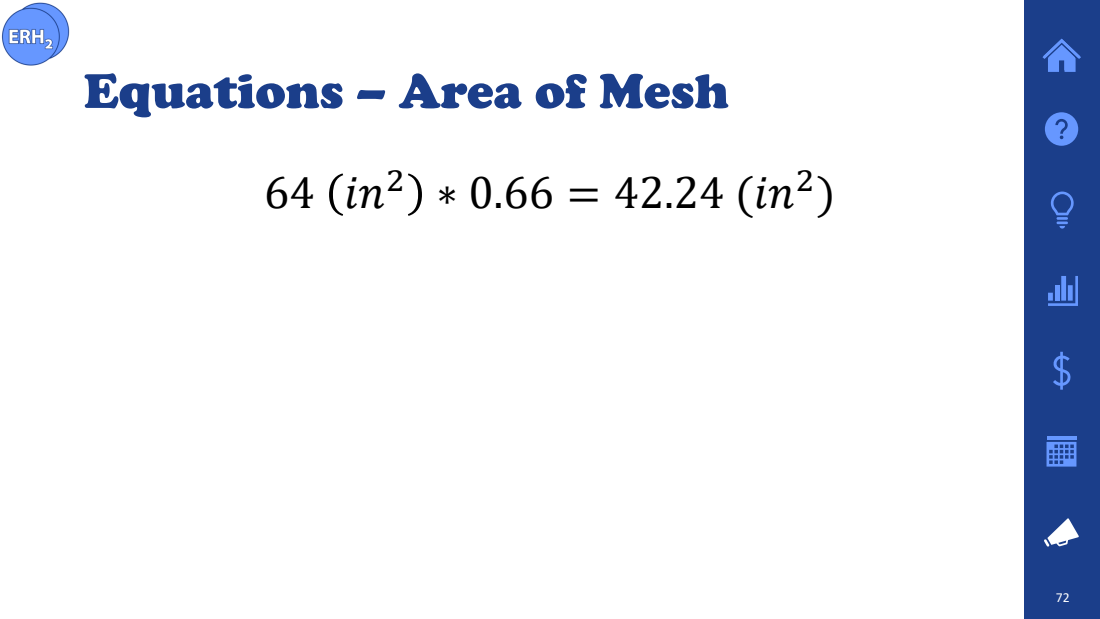
[picture p71: page 65]
64 in²; ∗ 0.66 = 42.24 (in²

# Equations – Max Current

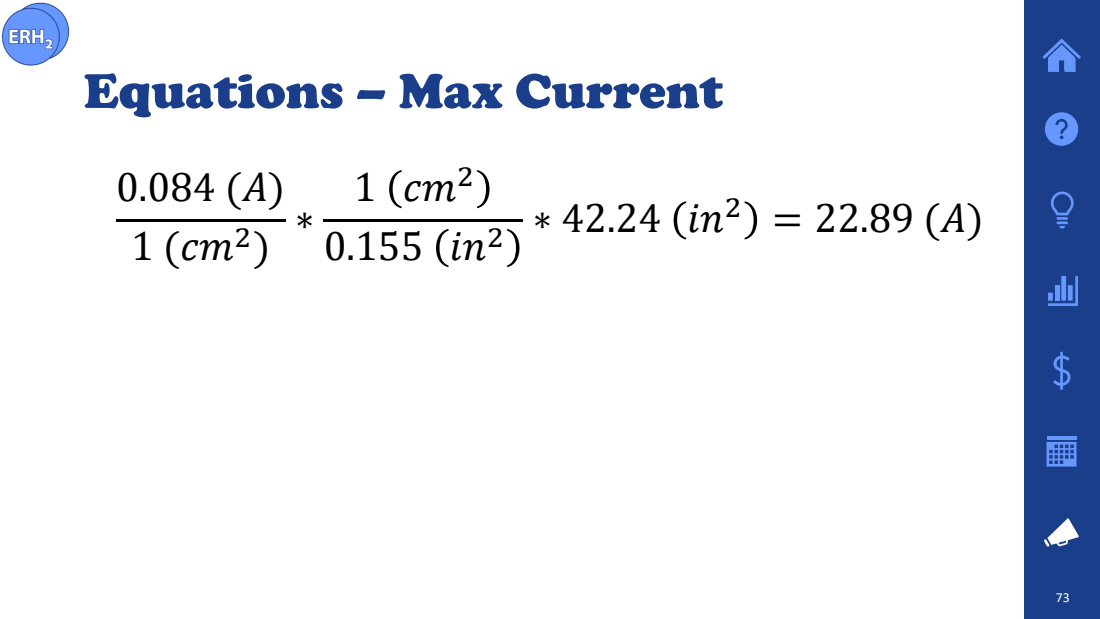
[picture p72: page 66]
0.084 (A) 1 (cm²); 1 cm² 0.155 in²; ∗ 42.24 in² = 22.89 (A)

# Equations – Rate of O2 Production

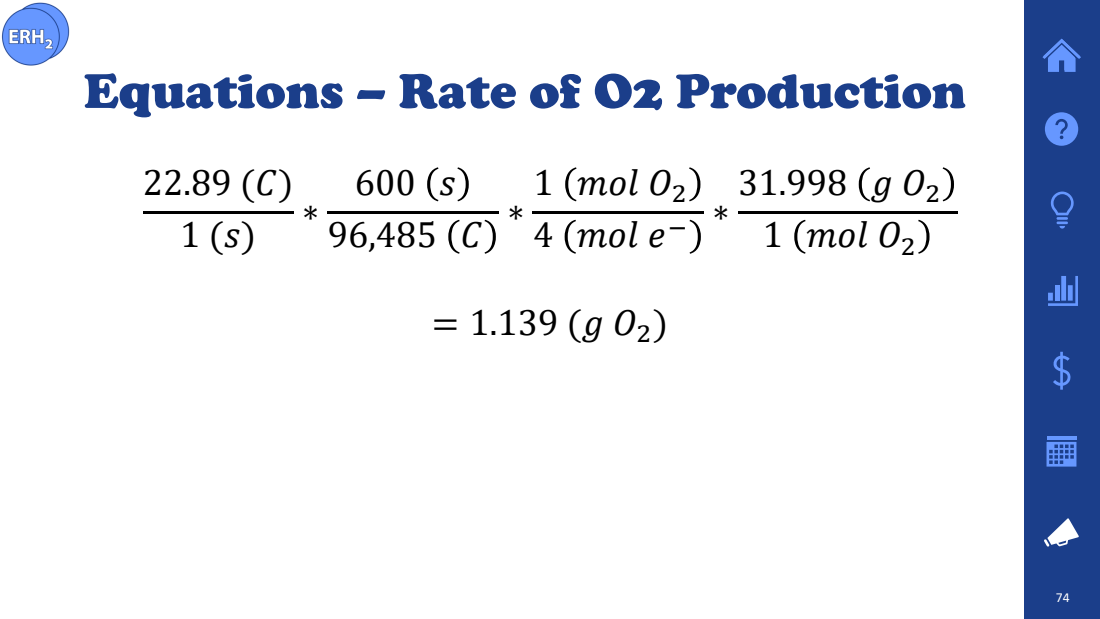
[picture p73: page 67]
1 mol O2 4 mol e; 31.998 g O2 1 mol O2

# Misc. Interfacing Table

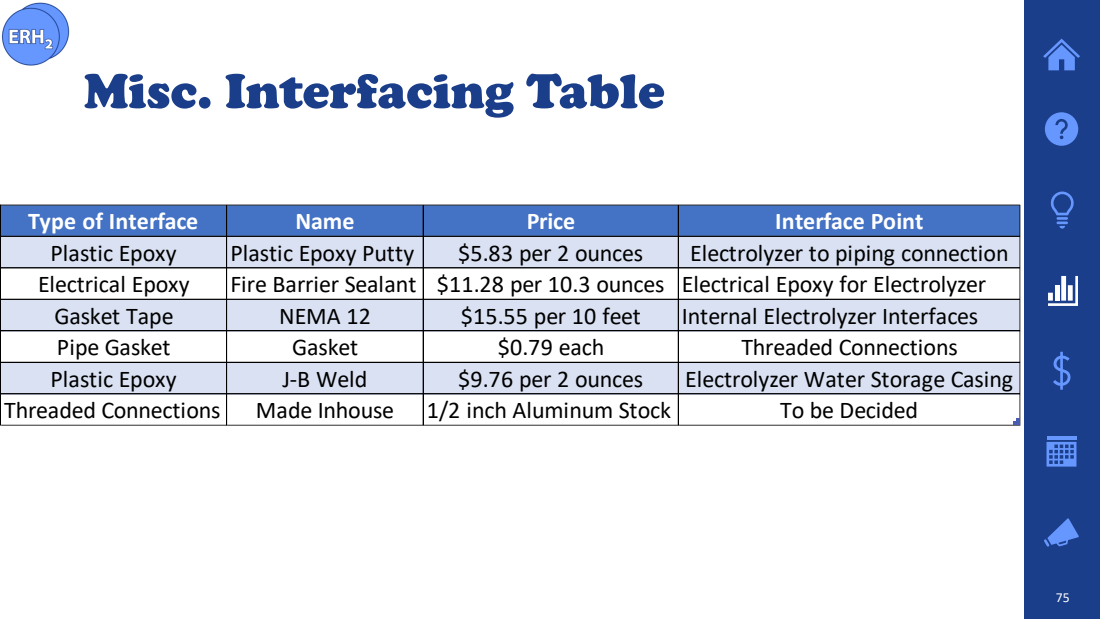
[picture p74: page 68]

Type of Interface | Name | Price | Interface Point
Plastic Epoxy | Plastic Epoxy Putty | $5.83 per 2 ounces | Electrolyzer to piping connection
Electrical Epoxy | Fire Barrier Sealant | $11.28 per 10.3 ounces | Electrical Epoxy for Electrolyzer
Gasket Tape | NEMA 12 | $15.55 per 10 feet | Internal Electrolyzer Interfaces
Pipe Gasket | Gasket | $0.79 each | Threaded Connections
Plastic Epoxy | J-B Weld | $9.76 per 2 ounces | Electrolyzer Water Storage Casing
Threaded Connections | Made Inhouse | 1/2 inch Aluminum Stock | To be Decided

# Schedule of Project

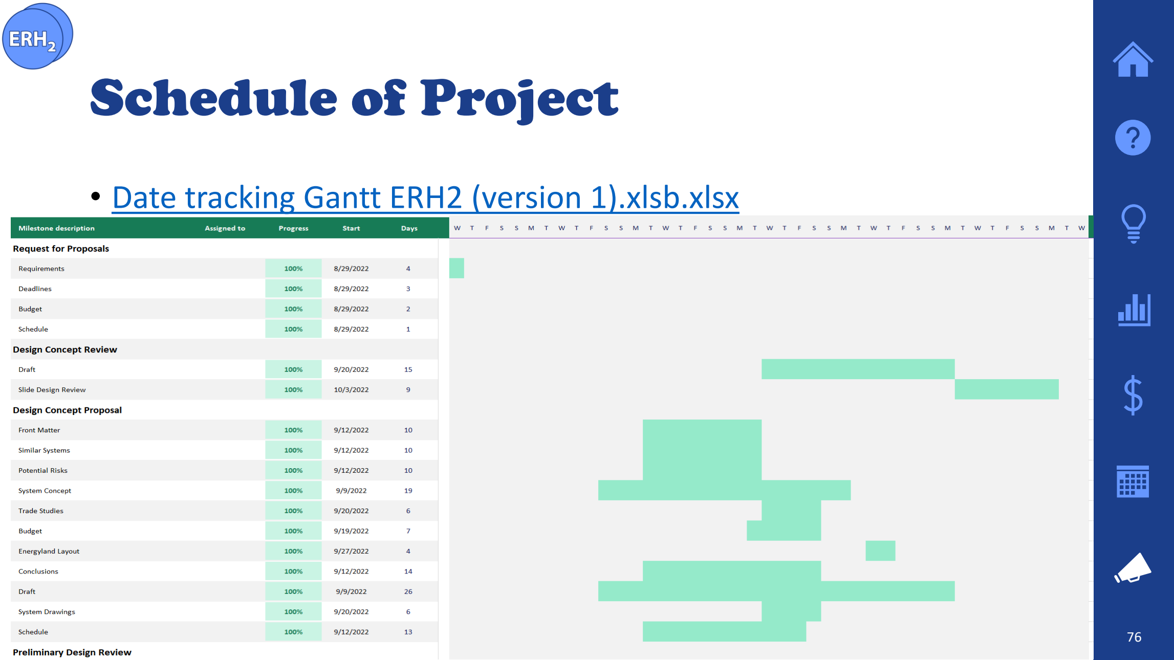
[picture p75: page 69]

- Date tracking Gantt ERH2 (version 1).xlsb.xlsx (https://myerauedu-my.sharepoint.com/:x:/g/personal/spillerh_my_erau_edu/Ef0DbHX812ZEpwhR6JwEFS0BcjY0EP1JyzZN7UaDBy9eVA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)
