dylanastrup/erh2/TeamsFiles_5_1_2023/Design/DCP documents/decison matrix.xlsx

Generation |  |  |  |  |  |  | Storage
type | scalability | temperature | production rates | system effiecincy |  |  | type | cost | temperature | needs compression
PBS |  |  |  |  |  |  | Physical Storage
MBC |  |  |  |  |  |  | Material Storage
Electrolysis
SMR
GENERATION | Electrolysis | PBS | MBC | SMR |  | STORAGE | Physcial | Metal Hydride | Intermetallic Hydride | Chemical Hydride | Carbon Nitride
Cost | - | -1 | -1 | -1 |  | Cost | - | 1 | 1 | 1 | 1
Size | - | 0 | 0 | -1 |  | Size | - | 1 | 1 | 1 | 1
Temperature | - | 1 | 1 | -1 |  | Capacity | - | -1 | -1 | -1 | -1
Production rate | - | -1 | -1 | 1 |  | Temperature | - | -1 | -1 | -1 | 1
System efficiency | - | -1 | -1 | 1 |  | Pressure | - | -1 | 1 | -1 | 1
Total | - | -2 | -2 | -1 |  | Discharge rate | - | -1 | 1 | 1 | 1
 |  |  |  |  |  | Total | - | 2 | 4 | 3 | 5
GENERATION | Weighting | SMR (Datum) | Biological | Electrolysis
Cost | 1 | - | -1 | 1
Production rate | 2 | - | -1 | -1
System efficiency | 3 | - | -1 | 1
Total |  | - | -5 | 2
STORAGE | Weighting | Physical (Datum) | Metal Hydride | Intermetallic Hydride | Chemical Hydride | Carbon Nitride
Cost | 2 | - | 1 | 1 | 1 | 1
Capacity | 3 | - | -1 | -1 | -1 | 1
Discharge rate | 1 | - | -1 | 1 | 1 | -1
Total |  | - | -2 | 0 | 0 | 4
