dylanastrup/erh2/TeamsFiles_5_1_2023/Design/Logos.docx

Team Name – Embry-Riddle Hydrogen

ERH2

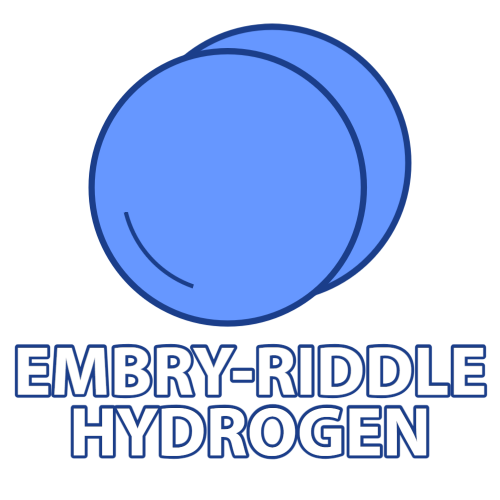
[picture p98: figure]
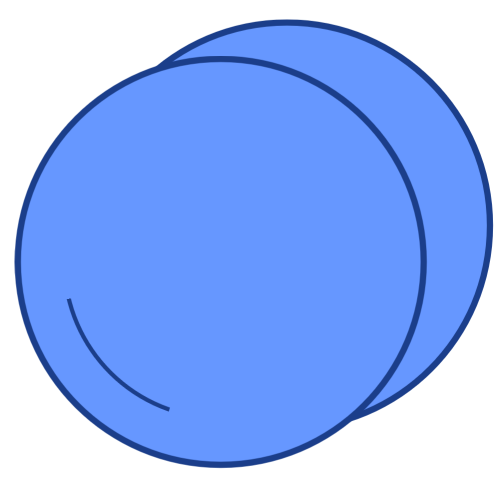
[picture p99: figure]
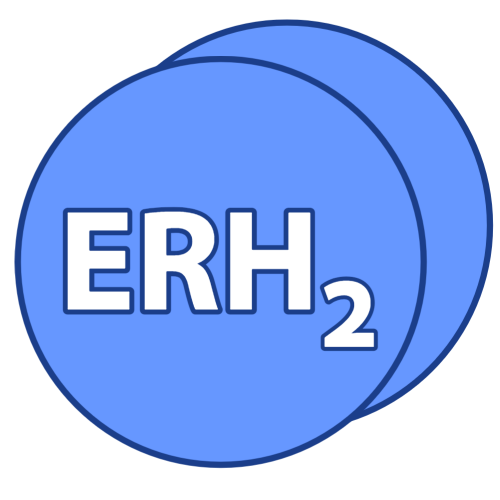
[picture p100: figure]
