dylanastrup/erh2/TeamsFiles_5_1_2023/Design/DCP documents/DCR Invitees.docx

Jeff @ AXFAB – Invited by Titan

Dr. DiPietro – Invited by Jacob

Professor Gerrick
