dylanastrup/erh2/TeamsFiles_5_1_2023/Design/Lab 4.xlsx

Aplied Load | Ch1 | Ch2 | Ch3 | Ch4 |  |  | M | 21686.7075 |  | D | 3.5
0 | 1 | 1 | 0 | 0 |  |  | T | 14707.0775 |  | d | 3.1
201.67 | 224 | -268 | 181 | 265 |  |  | V | 997.09 |  | x | 21.75
403.19 | 441 | -531 | 360 | 528 |  |  | C_t | 1.75
598.49 | 653 | -786 | 535 | 785 |  |  | C_b | 1.75 |  | E | 9900 | ksi
797.07 | 865 | -1042 | 711 | 1045 |  |  | I | 2.832852636 |  | G | 3800 | ksi
997.09 | 1079 | -1301 | 888 | 1308 |  |  | J | 5.665705271
 |  |  |  |  |  |  | A | 2.073451151
 | Calculated |  |  |  |  |  | T_t | 4542.66228 |  | 5183.841279
Aplied Load | Bending | Torsion | Trans Shear |  |  |  | T_s | 641.1789988
0 | 0 | 0 | 0 |  |  |  | M_b | 13397.00401
201.67 | 2709.658907 | 918.7923879 | -194.5259235
403.19 | 5417.302398 | 1836.901388 | -388.9071606
598.49 | 8041.373328 | 2726.672565 | -577.2887387
797.07 | 10709.51468 | 3631.38716 | -768.8341242
997.09 | 13397.00401 | 4542.66228 | -961.7684982
 | Measured
Aplied Load | Bending | Torsion | Trans Shear
0 | 0 | 0 | 0
201.67 | 2623.5 | 851.2 | -163.4
403.19 | 5227.2 | 1675.8 | -307.8
598.49 | 7771.5 | 2481.4 | -448.4
797.07 | 10345.5 | 3287 | -585.2
997.09 | 12949.2 | 4100.2 | -725.8
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
