dylanastrup/erh2/TeamsFiles_5_1_2023/Design/Lower Explosive Limit Math.xlsx

Air Density | 1.29 | g/L
Hydrogen Density | 0.09 | g/L
Volume | 1.5 | L
Rate | 0.0125 | g/min
Mass of Air | 1.935 | g
Mass of Hydrogen (10 min) | 0.125 | g
Hydrogen:Air, mass | 0.0645994832
Volume of Hydrogen | 1.388888889 | L
Hydrogen:Total Volume, volume | 0.4807692308
The Lower Explosive Limit of hydrogen gas is 4% by volume.
If our system had constant pressure and increasing volume, and no hydrogen gas was stored, after 10 minutes we'd have a concentration of 48% hydrogen by volume.
