dylanastrup/erh2/assets/images/allofit-1680x890.png

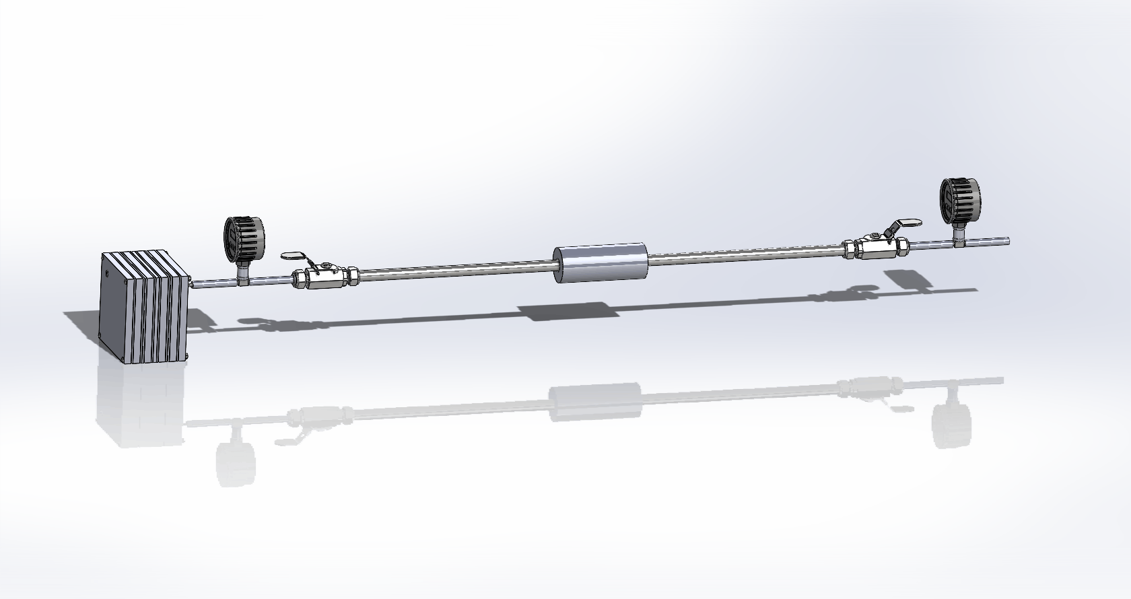
assets/images/allofit-1680x890.png
