dylanastrup/erh2/assets/images/dylan.png

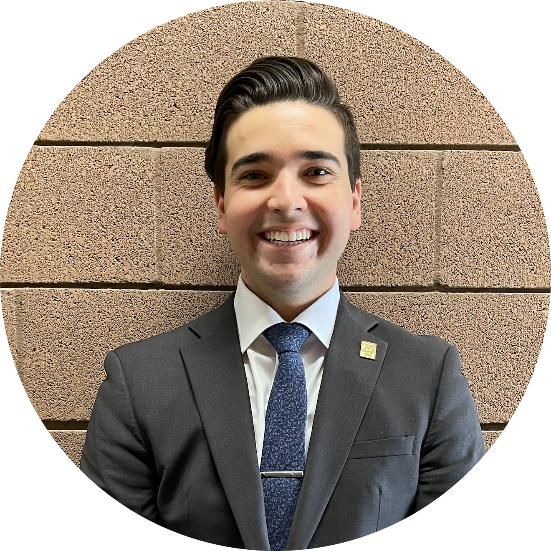
assets/images/dylan.png
