dylanastrup/erh2/assets/images/hannah.png

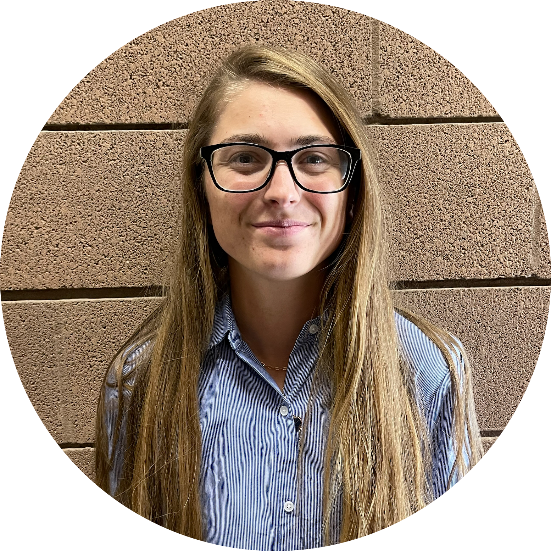
assets/images/hannah.png
