dylanastrup/erh2/assets/images/jacob.png

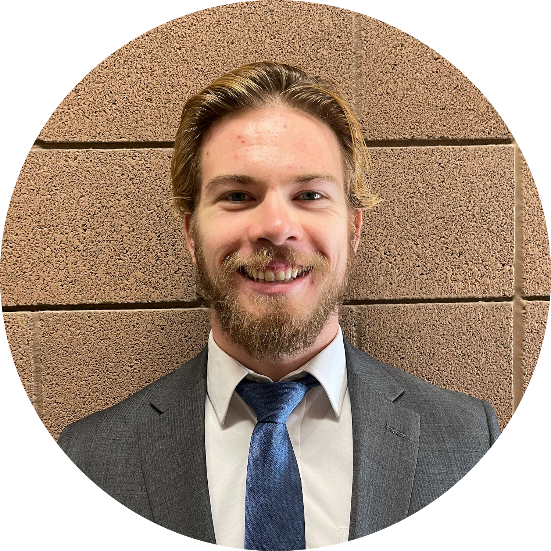
assets/images/jacob.png
