dylanastrup/erh2/assets/images/tesla.png

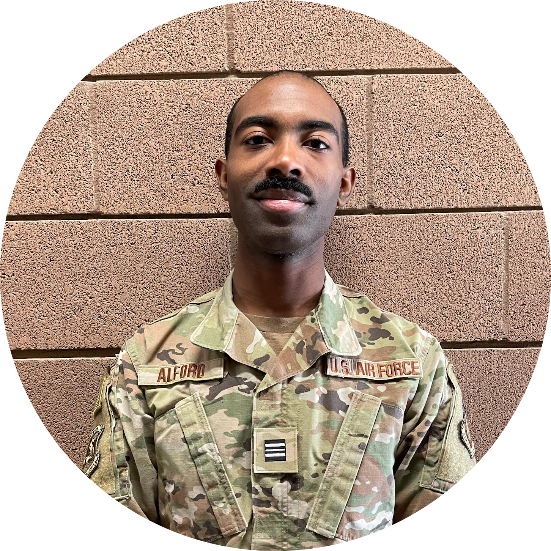
assets/images/tesla.png
