dylanastrup/erh2/assets/images/titan.png

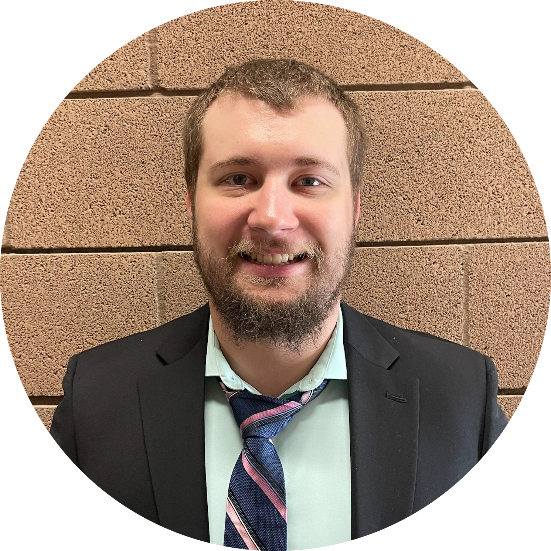
assets/images/titan.png
