dylanastrup/erh2/TeamsFiles_5_1_2023/Design/AInCom.png

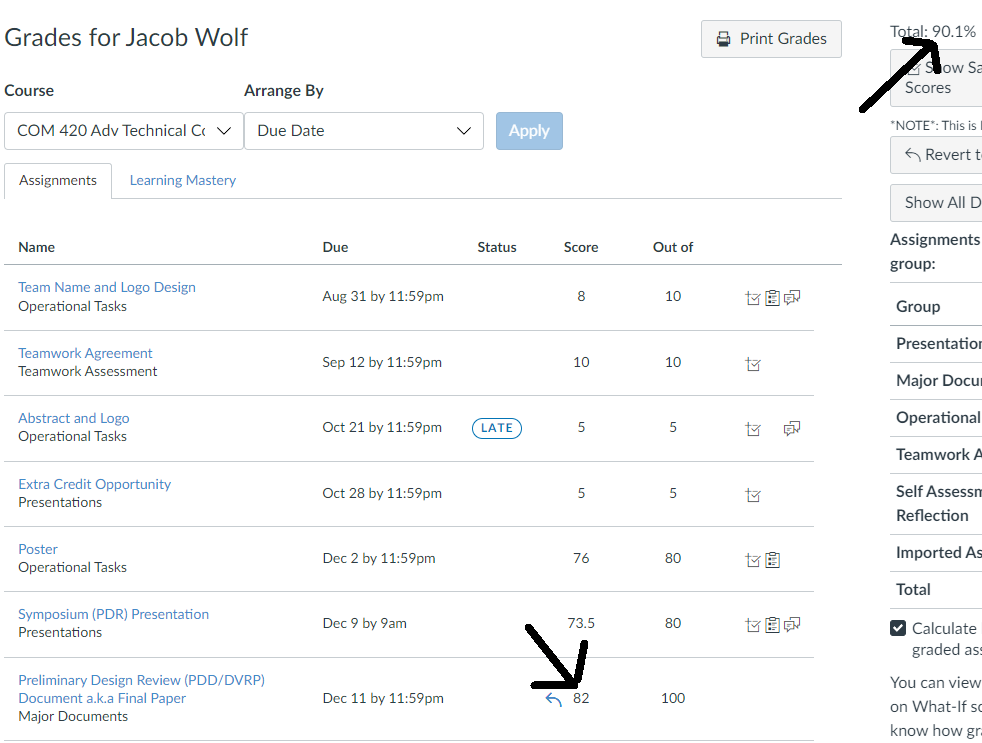
TeamsFiles_5_1_2023/Design/AInCom.png
