dylanastrup/erh2/TeamsFiles_5_1_2023/Design/ERH2 name next to shape-1.png

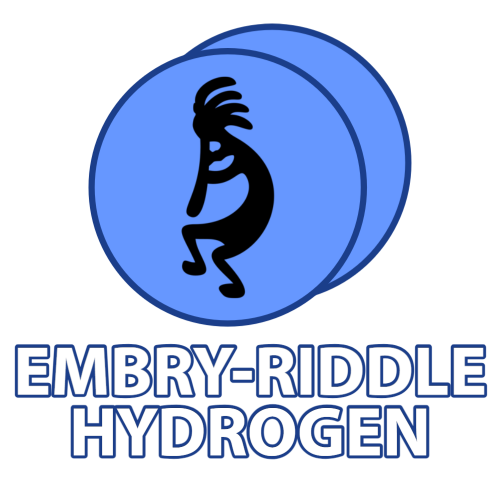
TeamsFiles_5_1_2023/Design/ERH2 name next to shape-1.png
