dylanastrup/erh2/TeamsFiles_5_1_2023/Design/PDR Documents/pdr Rubric.png

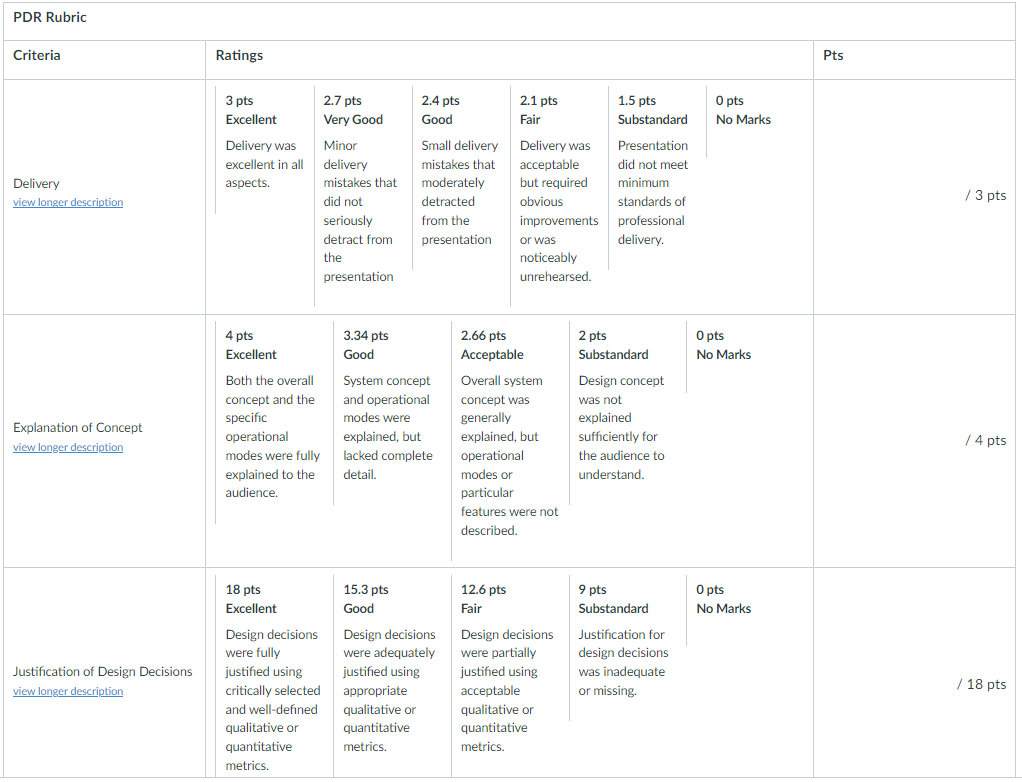
TeamsFiles_5_1_2023/Design/PDR Documents/pdr Rubric.png
