dylanastrup/erh2/TeamsFiles_5_1_2023/download (13).jpeg

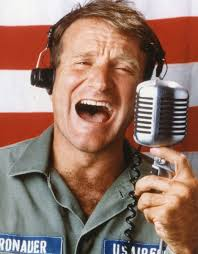
TeamsFiles_5_1_2023/download (13).jpeg
