dylanastrup/erh2/TeamsFiles_5_1_2023/electrolyzer.PNG

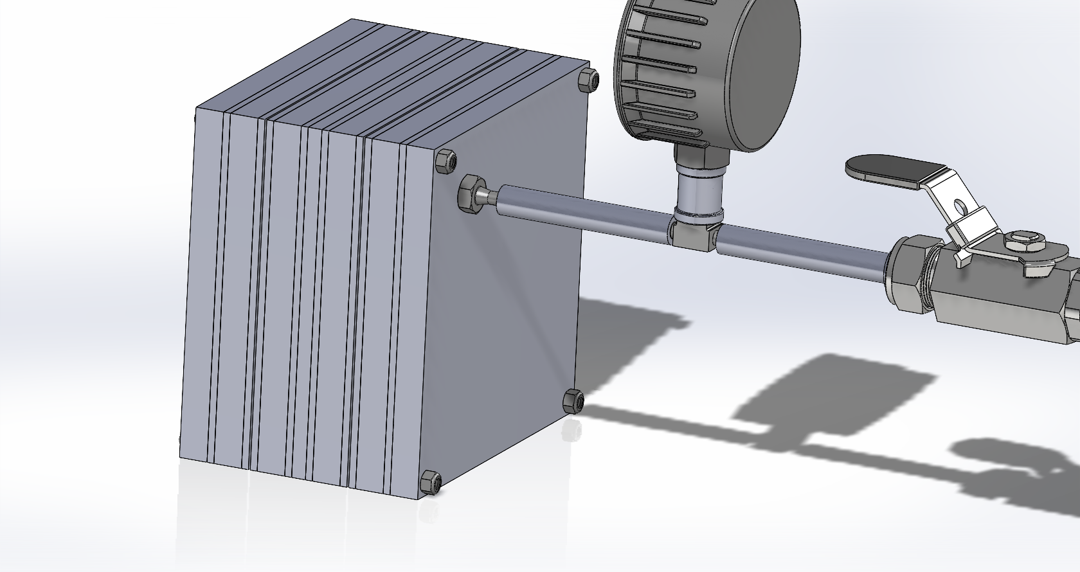
TeamsFiles_5_1_2023/electrolyzer.PNG
