dylanastrup/erh2/TeamsFiles_5_1_2023/ERH2 PFD 2-1-23.png

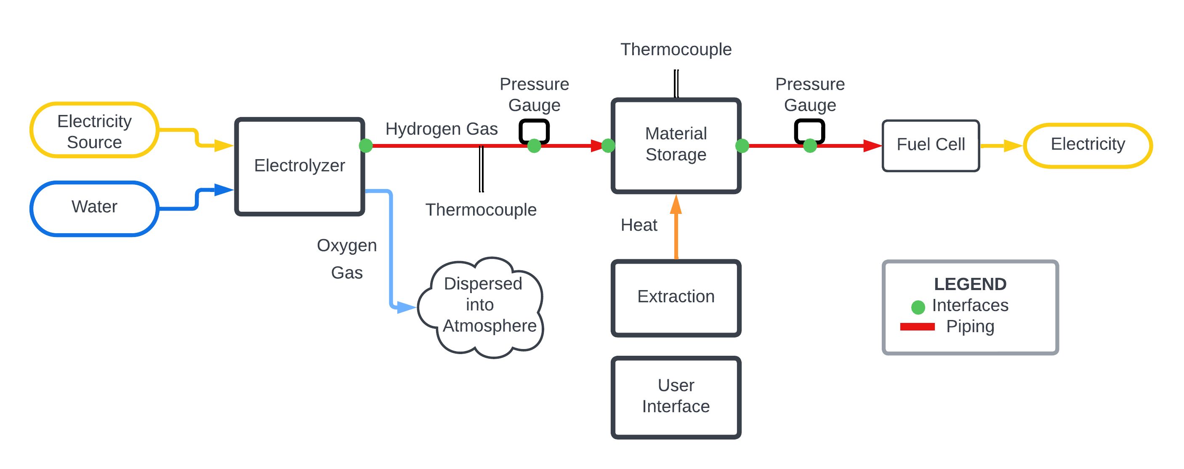
TeamsFiles_5_1_2023/ERH2 PFD 2-1-23.png
