dylanastrup/erh2/TeamsFiles_5_1_2023/photos/20221102_134810.jpg

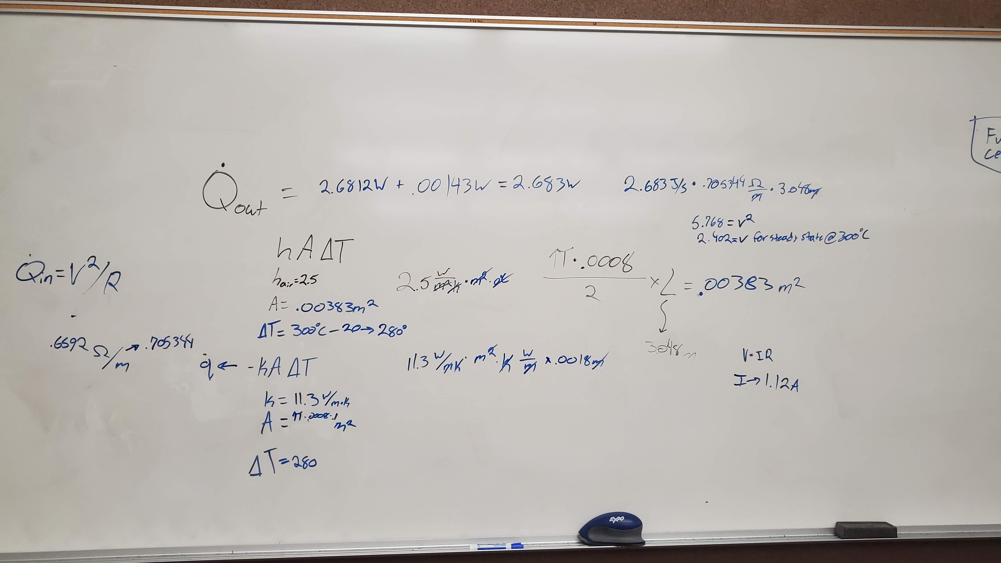
TeamsFiles_5_1_2023/photos/20221102_134810.jpg
