dylanastrup/erh2/TeamsFiles_5_1_2023/photos/ERH2 initialism next to shape.png

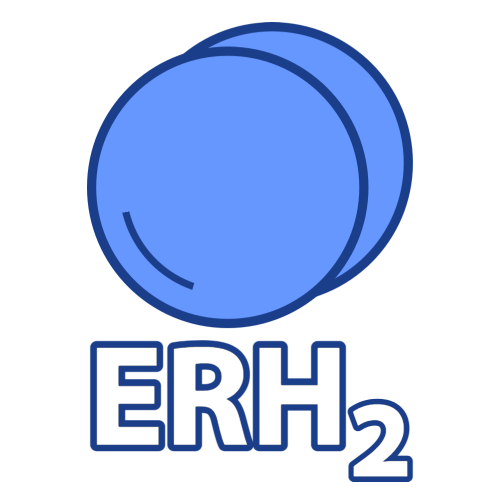
TeamsFiles_5_1_2023/photos/ERH2 initialism next to shape.png
