dylanastrup/erh2/TeamsFiles_5_1_2023/photos/ERH2 just shape.png

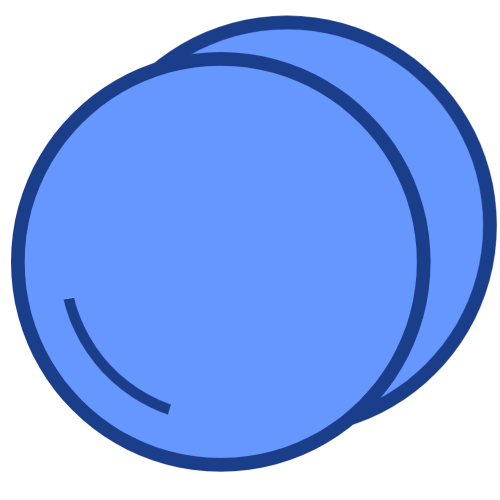
TeamsFiles_5_1_2023/photos/ERH2 just shape.png
