dylanastrup/erh2/TeamsFiles_5_1_2023/photos/massFlowCalculations.jpg

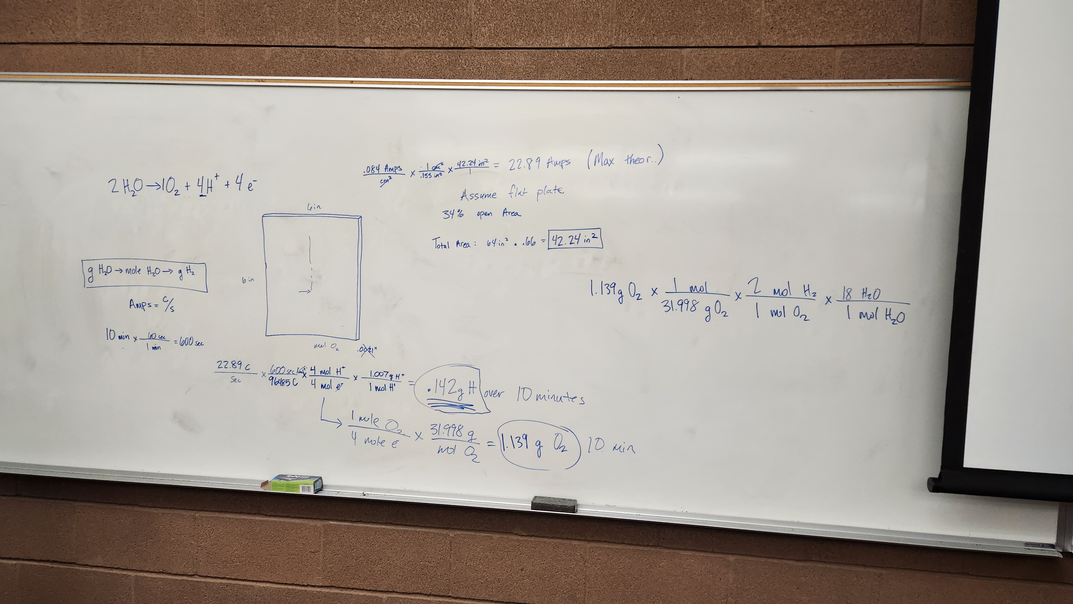
TeamsFiles_5_1_2023/photos/massFlowCalculations.jpg
