dylanastrup/erh2/TeamsFiles_5_1_2023/Solidworks/PTFEOutlet.PNG

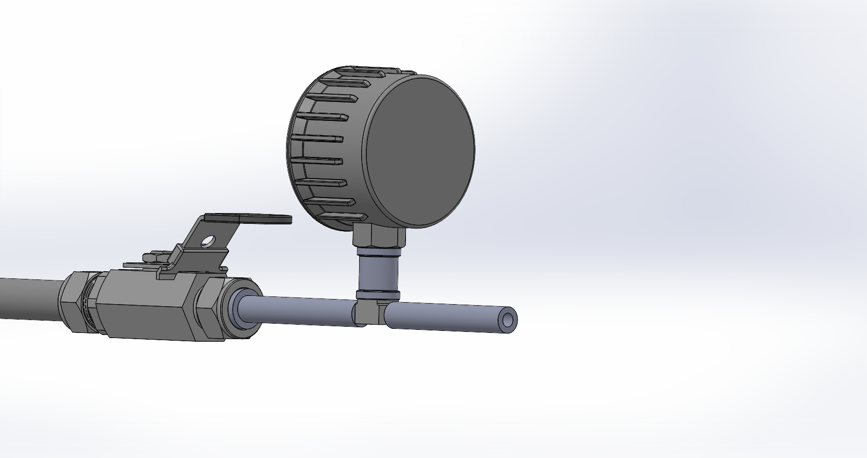
TeamsFiles_5_1_2023/Solidworks/PTFEOutlet.PNG
