dylanastrup/erh2/TeamsFiles_5_1_2023/Solidworks/Storage/StorageAssem.PNG

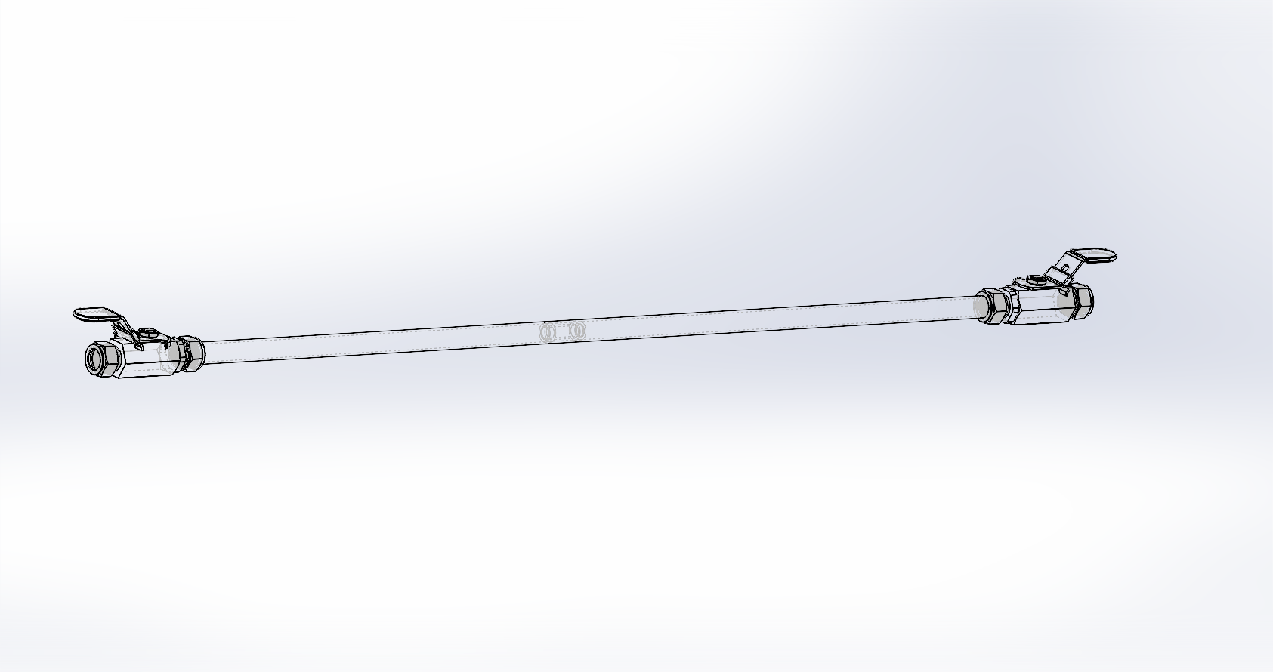
TeamsFiles_5_1_2023/Solidworks/Storage/StorageAssem.PNG
