dylanastrup/erh2/TeamsFiles_5_1_2023/Solidworks/Storage/StorageCapsule.PNG

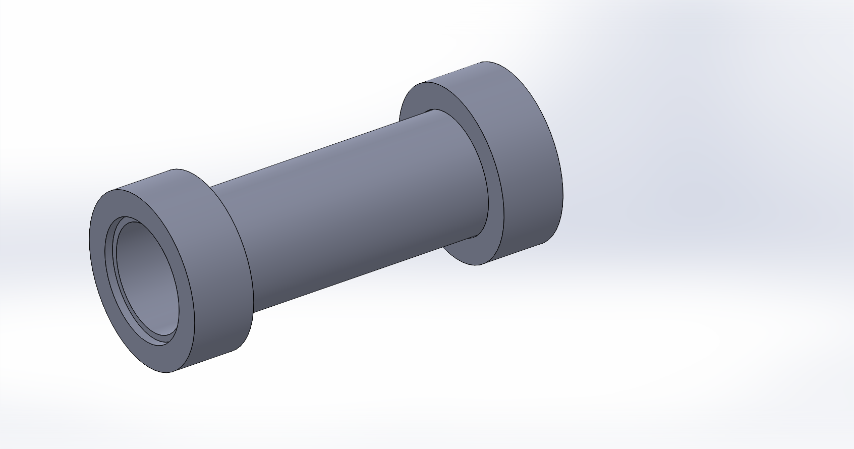
TeamsFiles_5_1_2023/Solidworks/Storage/StorageCapsule.PNG
