dylanastrup/erh2/TeamsFiles_5_1_2023/Thermal Images/capsule_176.jpg

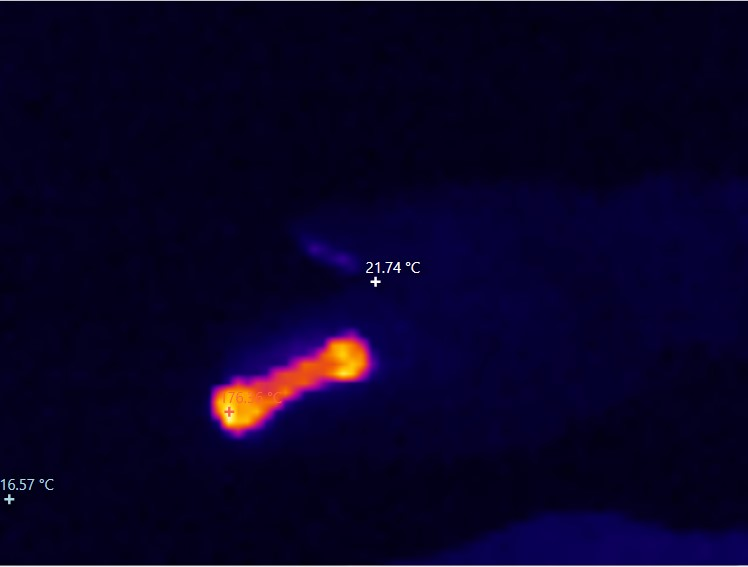
TeamsFiles_5_1_2023/Thermal Images/capsule_176.jpg
