dylanastrup/erh2/TeamsFiles_5_1_2023/Thermal Images/capsule_184.jpg

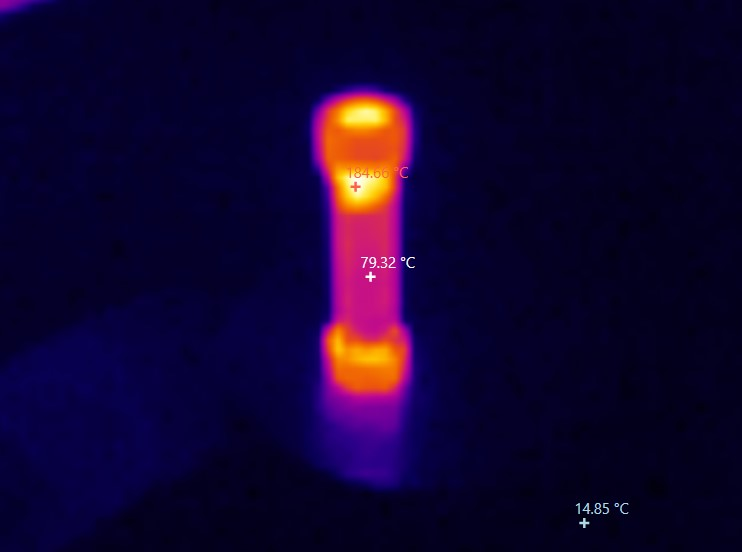
TeamsFiles_5_1_2023/Thermal Images/capsule_184.jpg
