dylanastrup/erh2/TeamsFiles_5_1_2023/Thermal Images/capsule_192.jpg

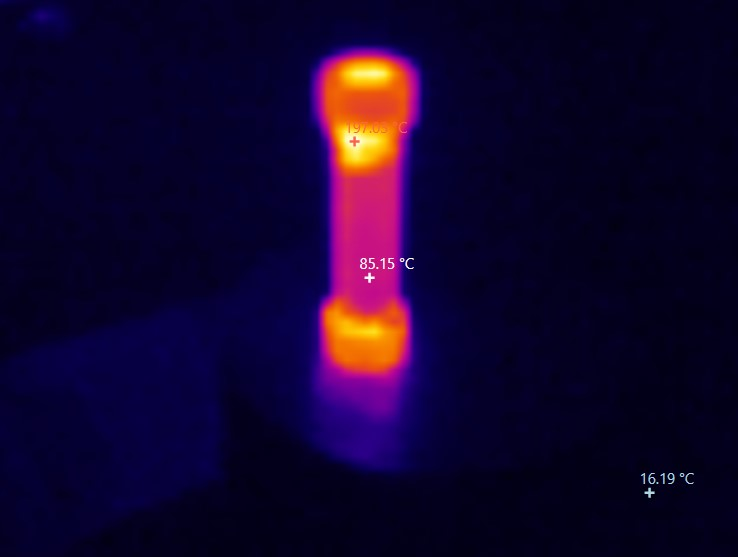
TeamsFiles_5_1_2023/Thermal Images/capsule_192.jpg
