dylanastrup/erh2/TeamsFiles_5_1_2023/Thermal Images/dylan_thermal.jpg

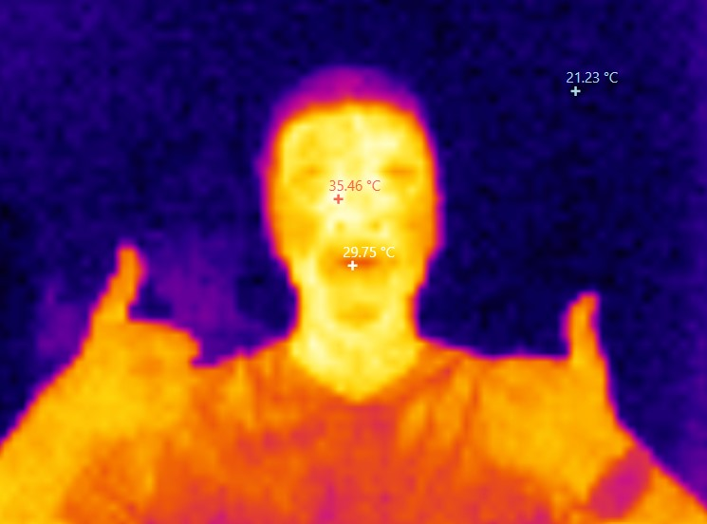
TeamsFiles_5_1_2023/Thermal Images/dylan_thermal.jpg
