dylanastrup/erh2/TeamsFiles_5_1_2023/Thermal Images/electrolyzer.jpg

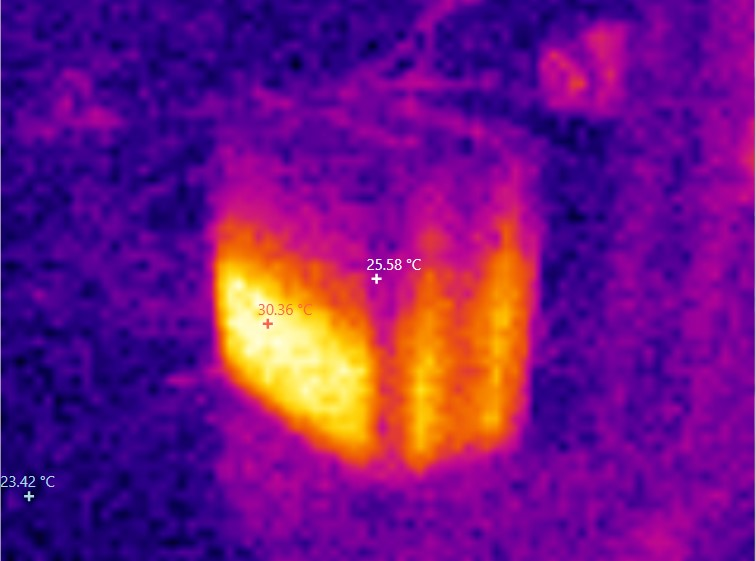
TeamsFiles_5_1_2023/Thermal Images/electrolyzer.jpg
