dylanastrup/erh2/TeamsFiles_5_1_2023/Thermal Images/electrolyzer_2.jpg

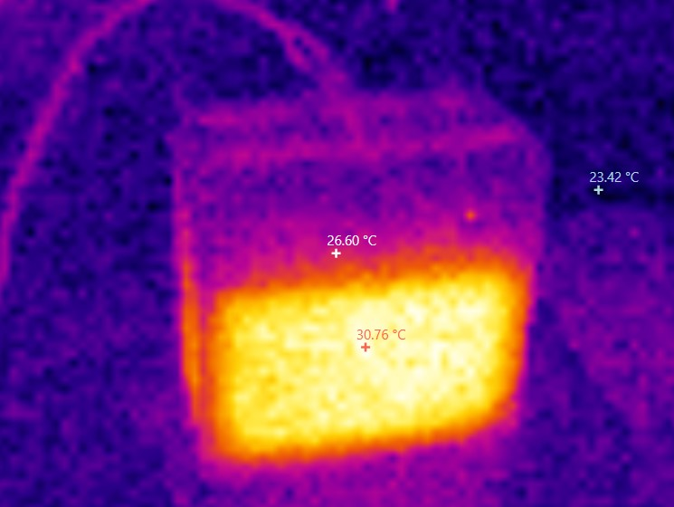
TeamsFiles_5_1_2023/Thermal Images/electrolyzer_2.jpg
