dylanastrup/erh2/TeamsFiles_5_1_2023/Thermal Images/Grant.jpg

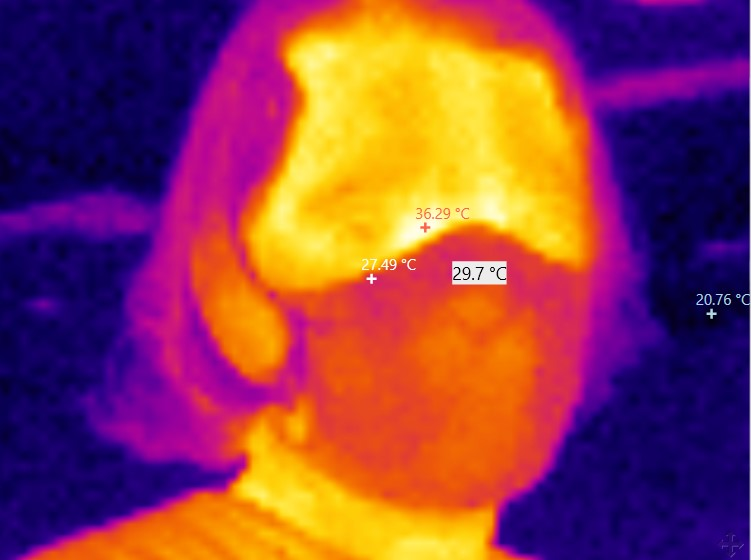
TeamsFiles_5_1_2023/Thermal Images/Grant.jpg
