dylanastrup/erh2/TeamsFiles_5_1_2023/Thermal Images/pipe_50.jpg

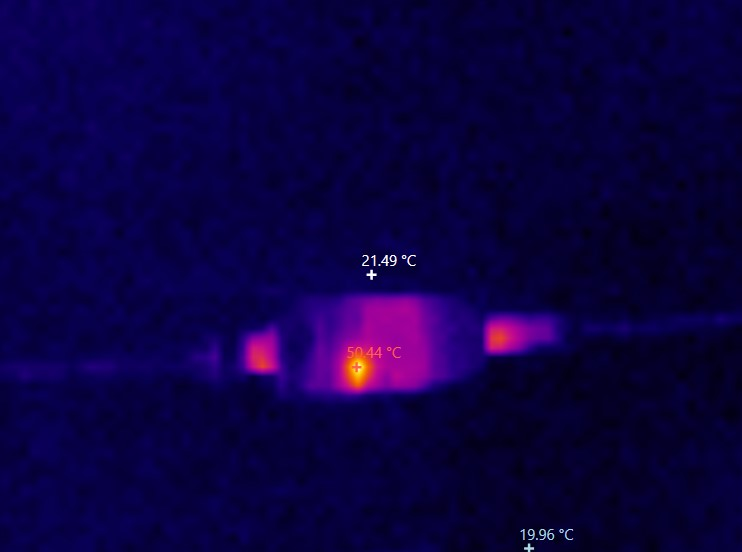
TeamsFiles_5_1_2023/Thermal Images/pipe_50.jpg
