dylanastrup/erh2/TeamsFiles_5_1_2023/Thermal Images/pipe_60.jpg

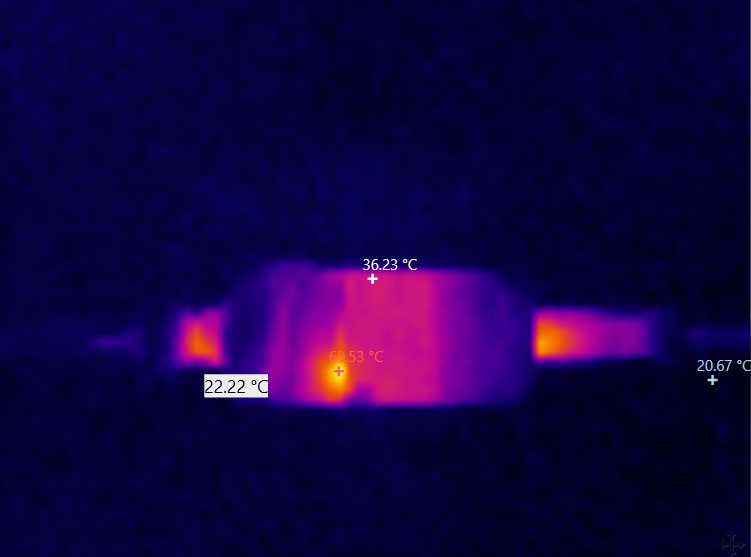
TeamsFiles_5_1_2023/Thermal Images/pipe_60.jpg
