dylanastrup/erh2/TeamsFiles_5_1_2023/Thermal Images/pipe_72.jpg

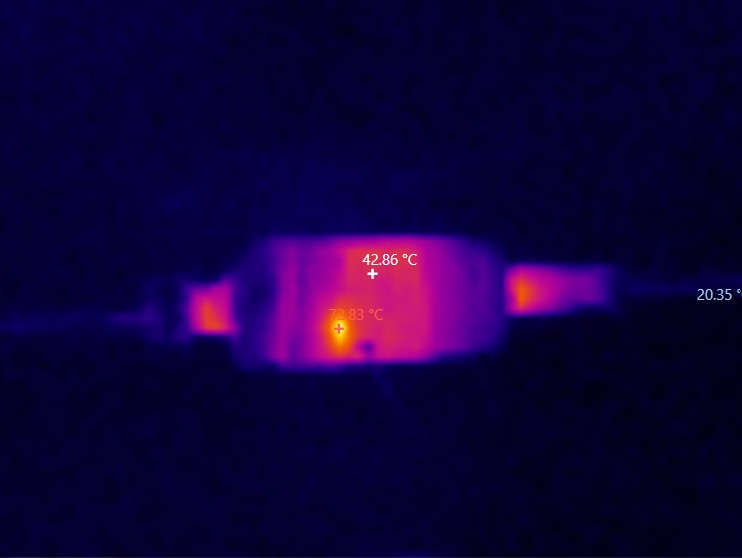
TeamsFiles_5_1_2023/Thermal Images/pipe_72.jpg
