dylanastrup/erh2/TeamsFiles_5_1_2023/Thermal Images/pipe_108.jpg

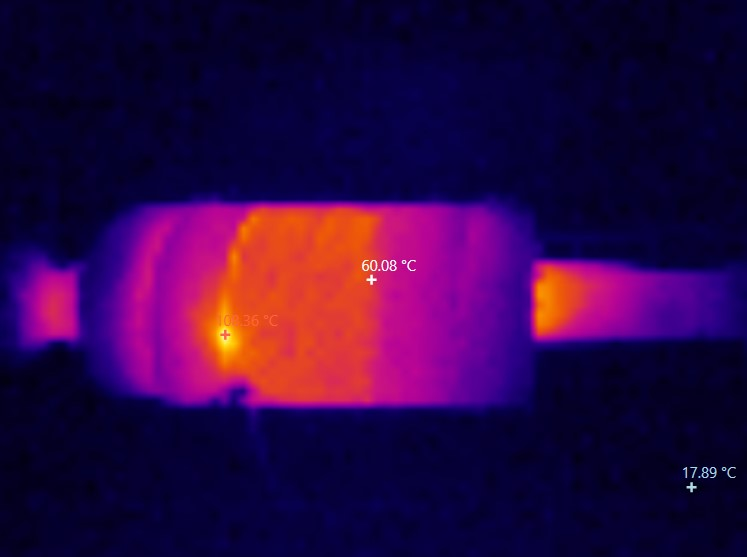
TeamsFiles_5_1_2023/Thermal Images/pipe_108.jpg
