dylanastrup/erh2/TeamsFiles_5_1_2023/Thermal Images/Tesla.jpg

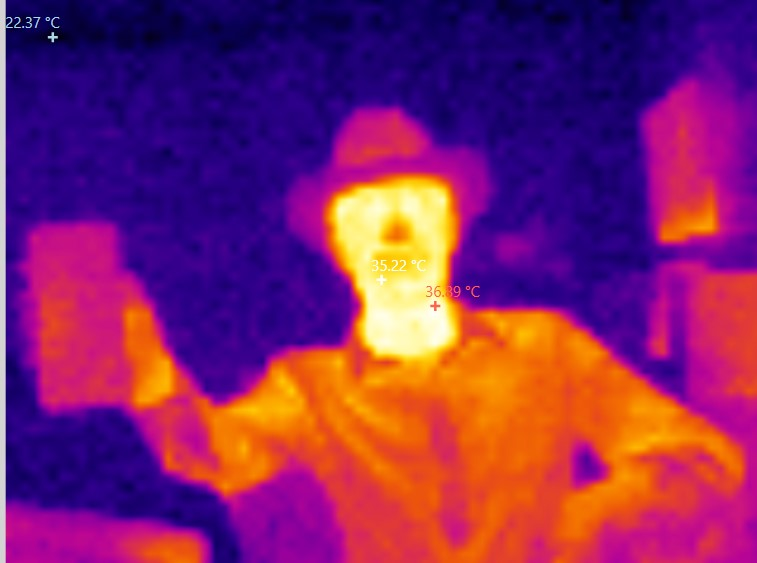
TeamsFiles_5_1_2023/Thermal Images/Tesla.jpg
