dylanastrup/erh2/TeamsFiles_5_1_2023/Thermal Images/valve_nonthermal.jpg

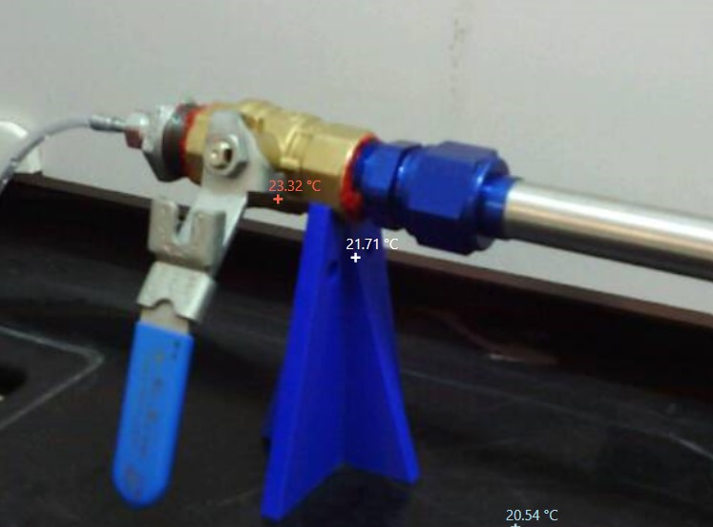
TeamsFiles_5_1_2023/Thermal Images/valve_nonthermal.jpg
