dylanastrup/erh2/TeamsFiles_5_1_2023/Design/Possible Valve Substitutes.xlsx

Connection Type | Material | Temp | Price | Link
Threaded 3/4-1/4 | Brass | -40 to 350 F | 31.2 | Brass On/Off Valve with Gauge Port, and Lockable Lever Handle, 3/4 NPT Female | McMaster-Carr (https://www.mcmaster.com/4085T361/) | Will also need: | Universal-Thread Push-to-Connect Tube Fitting, Nickel-Plated Brass, Straight, 1/4" OD x 1/4 Pipe Size | McMaster-Carr (https://www.mcmaster.com/7397n19/)
No Push to connect valve or fittings for 3/4 in. Would need a reducer added to the stainless steel.
If we use threaded connections it can be made either in plastic or various metals for cost savings.
