dylanastrup/erh2/TeamsFiles_5_1_2023/Interface Specific Data/Interface Data.xlsx

Type of Interface | Name | Price | Interface Point
Plastic Epoxy | Plastic Epoxy Putty | $5.83 per 2 ounces | Electrolyzer to piping connection | METACAULK Fire Barrier Sealant: Red, Tube, 10.3 oz Size, Up to 4 hr, Electrical Box, Caulk Gun - 49ZY42|66408 - Grainger (https://www.grainger.com/product/METACAULK-Fire-Barrier-Sealant-Red-49ZY42)
Electrical Epoxy | Fire Barrier Sealant | $11.28 per 10.3 ounces | Electrical Epoxy for Electrolyzer | gaskets | McMaster-Carr (https://www.mcmaster.com/gaskets/gasket-tape-for-enclosures/)
Gasket Tape | NEMA 12 | $15.55 per 10 feet | Internal Electrolyzer Interfaces | GARLOCK Gasket: 1/2 in Pipe Size, 1 7/8 in Outside Dia., 1/2 in Inside Dia., 1/16 in Thick - 40PP41|3760RG-0150-062-0050 - Grainger (https://www.grainger.com/product/GARLOCK-Gasket-1-2-in-Pipe-Size-40PP41)
Pipe Gasket | Gasket | $0.79 each | Threaded Connections | J-B WELD Epoxy Putty: Underwater, Petro, Chemical, and Acid Resistant, 2 oz, with Temp. Range of Up to 250°F - 2UV86|8277 - Grainger (https://www.grainger.com/product/J-B-WELD-Epoxy-Putty-Underwater-2UV86)
Plastic Epoxy | J-B Weld | $9.76 per 2 ounces | Electrolyzer Water Storage Casing
Threaded Connections | Made Inhouse | 1/2 inch Aluminum Stock | To be Decided
T-fitting link | fittings | McMaster-Carr (https://www.mcmaster.com/fittings/shape~tee/material~steel/for-use-with~air/connection-style~socket-connect/pipe-size~1-4/)
barbs | barbs | McMaster-Carr (https://www.mcmaster.com/barbs/metal-barbed-hose-fittings-for-air-and-water/)
Other T-fitting | diverting valves | McMaster-Carr (https://www.mcmaster.com/diverting-valves/diverting-valves-with-yor-lok-fittings/)
