dylanastrup/erh2/TeamsFiles_5_1_2023/Finances/Budgeting.xlsx

Sheet: Budget 3.5
 | Item | Quantity | Cost per unit | Total Cost | Supplier | Link | On PO? | Delivered?
Electrolysis
 | Polycarbonate (6"x6")(1/2" thick) | 7 | $12.20 | $85.40 | McMaster | https://www.mcmaster.com/8574K321/ | X | X
 | Copper plates (pack of 2) | 1 | $10.99 | $10.99 | Amazon | https://www.amazon.com/dp/B089VTMBCC?s=industrial&sp_csd=d2lkZ2V0TmFtZT1zcF9kZXRhaWw | X | X
 | Rubber Tape (1/2") (25ft) | 1 | $18.37 | $18.37 | McMaster | https://www.mcmaster.com/tape/rubber-sealing-tape/ | X | X
 | Nickel Mesh | 2 | $11.00 | $22.00 | McMaster | https://www.mcmaster.com/9225T361-9225T321/ | X | X
 | Bolts | 1 | $11.32 | $11.32 | McMaster | https://www.mcmaster.com/90272A363/ | X | X
 | Nuts | 1 | $4.60 | $4.60 | McMaster | https://www.mcmaster.com/90631A009/ | X | X
 | Liquid Gasket | 1 | $6.49 | $6.49 | Amazon | https://www.amazon.com/Permatex-81160-High-Temp-Silicone-Gasket/dp/B0002UEN1A | X
 | Power Supply | 1 | $141.99 | $141.99 | Amazon | https://www.amazon.com/Regulated-Variable-Adjustable-Accessories-Inverter/dp/B0924K3VQ5?hvadid=507777183588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 | X | X
 | Potassium Hydroxide | 1 | $15.99 | $15.99 | Amazon | https://www.amazon.com/Potassium-Hydroxide-Food-Grade-Pound/dp/B085NG5TRJ | X
 | DI Water | 1 | N/A Chem Lab | $0.00 | Chem lab
 |  |  | Electrolysis | $317.15
Material Storage
 | Lithium Doped Graphitic Carbon Nitride | 1 | $450.00 | $450.00 | Nanochem | https://www.nanochemazone.com/product/doped-graphitic-carbon-nitrides/ | X
 | 1 Micron SS Mesh | 4 | $10.00 | $40.00 | TWP | https://www.twpinc.com/1-micron-1-layer-sintered-stainless-mesh | X | X
 | 1 ft 3/4" 304 Stainless Steel | 1 | $17.16 | $17.16 | McMaster | https://www.mcmaster.com/89535K12-89535K121/ | X | X
 | Stainless Steel Zipties | 1 | $4.99 | $4.99 | HarborFreight | https://www.harborfreight.com/12-in-stainless-steel-cable-ties-25-pack-60330.html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
 |  |  | Material Storage | $512.15
Extraction
 | Nichrome Wire | 1 | $7.39 | $30.00 | Amazon | https://www.amazon.com/Nichrome-80-Gauge-Resistance-Wire/dp/B07CHTT73J | X
 | High Temp Sleeve | 1 | $8.02 | $8.02 | McMaster | https://www.mcmaster.com/88155K64/ | X
 | High Temp Insulating Fabric Roll (25ft) | 1 | $43.31 | $43.31 | McMaster | https://www.mcmaster.com/4057K3/ | X | X
 |  |  | Extraction | $81.33
Interfaces
 | Valves | 2 | $21.61 | $43.22 | McMaster | https://www.mcmaster.com/4629K14/ | X
 | Barbed Hose Fitting | 2 | $10.50 | $21.00 | McMaster | https://www.mcmaster.com/5350K52/ | X
 | Flared Fitting Adapter | 2 | $15.54 | $31.08 | McMaster | https://www.mcmaster.com/2227K14/ | X
 | Nut for Flared Fitting | 2 | $5.70 | $11.40 | McMaster | https://www.mcmaster.com/2227K64/ | X
 | Sleeve for Flared Fitting | 2 | $5.76 | $11.52 | McMaster | https://www.mcmaster.com/2227K74/ | X
 | 3/4 to 1/4 fitting | 2 | $4.32 | $8.64 | Home Depot | https://www.homedepot.com/p/Southland-3-4-in-x-1-4-in-Galvanized-Malleable-Iron-MPT-x-FPT-Hex-Bushing-Fitting-511-941HN/100200963 | X
 | Threaded Barbed fitting | 2 | $21.31 | $42.62 | McMaster | https://www.mcmaster.com/53505K64/ | X | X
 | Barbed T fitting | 3 | $7.49 | $22.47 | McMaster | https://www.mcmaster.com/5779K175/ | X | X | Electrolysis | $367.15
 | 1/4 NPT female to female (pack of 2) | 2 | $4.99 | $9.98 | Amazon | https://www.amazon.com/Pack-Coupler-Brass-Female-Fitting/dp/B082V8FJQJ?th=1 | X | X | Material Storage | $545.11
 | Thermocouple Compression Fitting | 1 | $7.50 | $7.50 | hgsind | https://www.hgsind.com/product/thermocouple-compression-fittings-npt-thread?v=74 | X | X | Extraction | $99.72
 | Epoxys | 1 | $20.00 | $20.00 |  |  |  |  | Interfaces | $269.43
 |  |  | Interfaces | $229.43 |  |  |  |  | Piping | $54.23
Piping |  |  |  |  |  |  |  |  | Instrumentation | $159.43
 | PTFE Tubing (1/4") (10ft) | 1 | $3.48 | $3.48 | Amazon | EZ-FLO 0.17 Inch ID (1/4 Inch OD) PVC Clear Vinyl Tubing, 10 Foot Length, 98615: Amazon.com: Industrial & Scientific (https://www.amazon.com/Ez-Flo-98615-Clear-Vinyl-Tubing/dp/B07Q1D14HF) | X | X
 | Stainless Steel Pipe (0.75" OD 0.68" ID) (3ft) | 1 | $35.75 | $35.75 | McMaster | https://www.mcmaster.com/89895K757/ | X | X
 |  |  | Piping | $39.23
Instrumentation
 | Pressure Gauge 0-15 in wc | 2 | $51.70 | $103.40 | Grainger | https://www.grainger.com/product/WINTERS-Low-Pressure-Gauge-For-Natural-491C64 | X | X
 | Thermocouple wire | 1 | N/A Prop Lab | $0.00 | Prop lab
 | Thermocouple probes | 1 | N/A Prop Lab | $0.00 | Prop Lab | https://www.omega.com/en-us/temperature-measurement/temperature-probes/probes-with-lead-wires/blmi/p/BLMI-304-J-18E-6 |  | X
 | Thermocouple readers | 2 | N/A Prop Lab | $0.00 | Prop Lab
 |  |  | Instrumentation | $103.40
 |  |  | TOTAL: | $1282.69
 |  |  |  | $217.30
 |  |  |  | $956.89
 |  |  |  | $46.85
 | 45.01
 | 1146.73
 | 227.79

Sheet: Budget 3.0
 | Item | Quantity | Cost per unit | Total Cost | Supplier | Link | On PO? | Delivered?
Electrolysis
 | Polycarbonate (6"x6")(1/2" thick) | 7 | $12.20 | $85.40 | McMaster | https://www.mcmaster.com/8574K321/ | X | X
 | Copper plates (pack of 2) | 1 | $10.99 | $10.99 | Amazon | https://www.amazon.com/dp/B089VTMBCC?s=industrial&sp_csd=d2lkZ2V0TmFtZT1zcF9kZXRhaWw | X | X
 | Rubber Tape (1/2") (25ft) | 1 | $18.37 | $18.37 | McMaster | https://www.mcmaster.com/tape/rubber-sealing-tape/ | X | X
 | Nickel Mesh | 2 | $11.00 | $22.00 | McMaster | https://www.mcmaster.com/9225T361-9225T321/ | X | X
 | Bolts | 1 | $11.32 | $11.32 | McMaster | https://www.mcmaster.com/90272A363/ | X | X
 | Nuts | 1 | $4.60 | $4.60 | McMaster | https://www.mcmaster.com/90631A009/ | X | X
 | Liquid Gasket | 1 | $6.49 | $6.49 | Amazon | https://www.amazon.com/Permatex-81160-High-Temp-Silicone-Gasket/dp/B0002UEN1A | X
 | Power Supply | 1 | $141.99 | $141.99 | Amazon | https://www.amazon.com/Regulated-Variable-Adjustable-Accessories-Inverter/dp/B0924K3VQ5?hvadid=507777183588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 | X | X
 | Potassium Hydroxide | 1 | $15.99 | $15.99 | Amazon | https://www.amazon.com/Potassium-Hydroxide-Food-Grade-Pound/dp/B085NG5TRJ | X
 | DI Water | 1 | N/A Chem Lab | $30.00 | Chem lab
 |  |  | Electrolysis | $347.15
Material Storage
 | Lithium Doped Graphitic Carbon Nitride | 1 | $450.00 | $430.00 | Nanochem | https://www.nanochemazone.com/product/doped-graphitic-carbon-nitrides/ | X
 | 1 Micron SS Mesh | 4 | $10.00 | $40.00 | TWP | https://www.twpinc.com/1-micron-1-layer-sintered-stainless-mesh | X | X
 | 1 ft 3/4" 304 Stainless Steel | 1 | $17.16 | $17.16 | McMaster | https://www.mcmaster.com/89535K12-89535K121/ | X | X
 | Stainless Steel Zipties | 1 | $4.99 | $30.00 | HarborFreight | https://www.harborfreight.com/12-in-stainless-steel-cable-ties-25-pack-60330.html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
 |  |  | Material Storage | $517.16
Extraction
 | Nichrome Wire | 1 | $7.39 | $30.00 | Amazon | https://www.amazon.com/Nichrome-80-Gauge-Resistance-Wire/dp/B07CHTT73J | X
 | High Temp Sleeve | 1 | $8.02 | $8.02 | McMaster | https://www.mcmaster.com/88155K64/ | X
 | High Temp Insulating Fabric Roll (25ft) | 1 | $43.31 | $43.31 | McMaster | https://www.mcmaster.com/4057K3/ | X | X
 |  |  | Extraction | $81.33
Interfaces
 | Valves | 2 | $21.61 | $43.22 | McMaster | https://www.mcmaster.com/4629K14/ | X
 | Barbed Hose Fitting | 2 | $10.50 | $21.00 | McMaster | https://www.mcmaster.com/5350K52/ | X
 | Flared Fitting Adapter | 2 | $15.54 | $31.08 | McMaster | https://www.mcmaster.com/2227K14/ | X
 | Nut for Flared Fitting | 2 | $5.70 | $11.40 | McMaster | https://www.mcmaster.com/2227K64/ | X
 | Sleeve for Flared Fitting | 2 | $5.76 | $11.52 | McMaster | https://www.mcmaster.com/2227K74/ | X
 | 3/4 to 1/4 fitting | 2 | $4.32 | $8.64 | Home Depot | https://www.homedepot.com/p/Southland-3-4-in-x-1-4-in-Galvanized-Malleable-Iron-MPT-x-FPT-Hex-Bushing-Fitting-511-941HN/100200963 | X
 | Threaded Barbed fitting | 2 | $21.31 | $42.62 | McMaster | https://www.mcmaster.com/53505K64/ | X | X
 | Barbed T fitting | 3 | $7.49 | $22.47 | McMaster | https://www.mcmaster.com/5779K175/ | X | X | Electrolysis | $367.15
 | 1/4 NPT female to female (pack of 2) | 2 | $4.99 | $9.98 | Amazon | https://www.amazon.com/Pack-Coupler-Brass-Female-Fitting/dp/B082V8FJQJ?th=1 | X | X | Material Storage | $545.11
 | Thermocouple Compression Fitting | 1 | $7.50 | $7.50 | hgsind | https://www.hgsind.com/product/thermocouple-compression-fittings-npt-thread?v=74 | X | X | Extraction | $99.72
 | Epoxys | 1 | $20.00 | $65.00 |  |  |  |  | Interfaces | $269.43
 |  |  | Interfaces | $274.43 |  |  |  |  | Piping | $54.23
Piping |  |  |  |  |  |  |  |  | Instrumentation | $159.43
 | PTFE Tubing (1/4") (10ft) | 1 | $3.48 | $30.00 | Amazon | EZ-FLO 0.17 Inch ID (1/4 Inch OD) PVC Clear Vinyl Tubing, 10 Foot Length, 98615: Amazon.com: Industrial & Scientific (https://www.amazon.com/Ez-Flo-98615-Clear-Vinyl-Tubing/dp/B07Q1D14HF) | X | X
 | Stainless Steel Pipe (0.75" OD 0.68" ID) (3ft) | 1 | $35.75 | $35.75 | McMaster | https://www.mcmaster.com/89895K757/ | X | X
 |  |  | Piping | $65.75
Instrumentation
 | Pressure Gauge 0-15 in wc | 2 | $51.70 | $103.40 | Grainger | https://www.grainger.com/product/WINTERS-Low-Pressure-Gauge-For-Natural-491C64 | X | X
 | Thermocouple wire | 1 | N/A Prop Lab | $0.00 | Prop lab
 | Thermocouple probes | 1 | N/A Prop Lab | $0.00 | Prop Lab | https://www.omega.com/en-us/temperature-measurement/temperature-probes/probes-with-lead-wires/blmi/p/BLMI-304-J-18E-6 |  | X
 | Thermocouple readers | 2 | N/A Prop Lab | $30.31 | Prop Lab
 |  |  | Instrumentation | $133.71
 |  |  | TOTAL: | $1419.53
 |  |  |  | $217.30
 |  |  |  | $956.89
 |  |  |  | $46.85
 | 45.01
 | 1146.73
 | 227.79

Sheet: Sheet1
 |  |  |  |  |  | System | Cost |  |  |  |  |  |  |  |  |  | Income | Source | Expenses | Item
 |  |  |  |  |  | Electrolysis | $542.76 |  |  |  |  |  |  |  |  |  | $1300.00 | Base | $675.00 | Electrolysis |  |  | INCOME
Item | Cost | Supplier | Link |  | Weight | Material Storage | $57.90 |  |  |  |  |  |  |  |  |  | $0.00 |  | $129.54 | Material Storage |  |  |  | Base | $1300.00
Shirts | $0.00 | N/A | https://www.amazon.com/dp/B010C7MBXE/ref=twister_B010C7LC0M?th=1&psc=1 |  | 0 | Extraction | $201.43 |  |  |  |  |  |  |  |  |  | $0.00 |  | $87.00 | Charge/Discharge |  |  |  | TOTAL INCOME | $1300.00
Urea | $20.00 |  |  |  | 0 | Interfaces | $71.22 |  |  |  |  |  |  |  |  |  | $0.00 |  | $400.00 | Fuel Cell |  |  | EXPENSES
lithium Chloride 30grams | $17.90 | HomeScienceTools | https://www.homesciencetools.com/product/lithium-chloride-30-g/ |  | 0 | Piping | $86.86 |  |  |  |  |  |  |  |  |  | $0.00 |  | $24.00 | Plumbing |  |  |  | Electrolysis | $675.00
Plexiglass | $84.56 | McMaster | https://www.mcmaster.com/8560K267/ |  | 9.3 lbs | IUI | $35.65 |  |  |  |  |  |  |  |  |  | $0.00 |  | $0.00 | Sensors/Alarms |  |  |  | Material Storage | $129.54
Pressure gauge | $35.65 | Cole-Parmer | https://www.mcmaster.com/2798K211/ | https://www.coleparmer.com/i/cole-parmer-pressure-gauge-1-4-npt-m-process-connection-0-to-30-water-column/6835704 | 0.5 | Miscillaneous | $304.18 |  |  |  |  |  |  |  |  |  | $0.00 |  | $0.00 | Control System |  |  |  | Charge/Discharge | $12.00
Mesh X 2 | $22.00 | McMaster | https://www.mcmaster.com/9225T361-9225T321/ |  | 0 |  |  |  |  |  |  |  |  |  |  |  | $0.00 |  | $0.00 | Instrumentation |  |  |  | Plumbing | $24.00
PTFE Tubing x 25ft | $62.25 | McMaster | https://www.mcmaster.com/5239K13/ |  |  |  |  |  |  |  |  |  |  |  |  |  | $0.00 |  | $0.00 | Valves |  |  |  | Interfaces | $0.00
F-F Thread Adapter x2 | $19.12 | McMaster | https://www.mcmaster.com/4429K111/ |  |  |  |  |  |  |  |  |  |  |  |  |  | $0.00 |  | $0.00 | Sealant |  |  |  | User Interfaces | $0.00
Bolts | $7.60 | McMaster | https://www.mcmaster.com/92949A831/ |  |  |  |  |  |  |  |  |  |  |  |  |  | $0.00 |  | $0.00 | Electrical |  |  |  | Team Shirts | $125.00
Stainless Tube | $16.12 | McMaster | https://www.mcmaster.com/89895K757-89895K259/ |  |  | 2.54 |  |  |  |  |  |  |  |  |  |  | $0.00 |  | $125.00 | Team Shirts |  |  |  | TOTAL EXPENSES | $965.54
Barbed T fitting x 2 | $24.28 | McMaster | https://www.mcmaster.com/44555K162/ |  |  |  |  |  |  |  |  |  |  |  |  |  | $0.00 |  | $0.00 | TBD |  |  | TOTAL |  | $334.46
Barbed Fitting x3 | 9.02 | McMaster | https://www.mcmaster.com/catalog/128/344 |  |  |  |  |  |  |  |  |  |  |  |  |  | $0.00 |  | $0.00 | Misc.
Insulating Strips | 43.43 | McMaster | https://www.mcmaster.com/4057K3/ |  | 1 |  |  |  |  |  |  |  |  |  |  |  | TOTAL: | $1300.00 | TOTAL: | $1440.54
Nichrome Wire | $158.00 | Thomas Scientific | https://www.thomassci.com/Equipment/Heaters/_/Heater-Element-Wire-Electrically-Insulated
Solder | $30 | Amazon | AUSTOR 60-40 Tin Lead Rosin Core Solder Wire for Electrical Soldering (100g, 1.0mm): Amazon.com: Tools & Home Improvement (https://www.amazon.com/AUSTOR-60-40-Solder-Electrical-Soldering/dp/B073LT2PKB?hvadid=80195681205767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)
Rubber Plug | $10.42
Rubber Tape (25ft) | 18.37 | McMaster | https://www.mcmaster.com/tape/rubber-sealing-tape/ |  |  |  |  |  |  |  |  |  |  |  |  |  |  | Pro
Valves x2 | 321.02 | McMaster | https://www.mcmaster.com/4537k24/
Epoxy's | $20
Nuts | $2.20 | McMaster | https://www.mcmaster.com/90480A195/ |  |  | Electrolysis | Column1 | Material Storage | Column2 | Extraction | Column3 | Interfaces | Column4 | Piping | Column5 | IUI | Column6 | Column7
Other Plastic | $88.04 | McMaster | https://www.mcmaster.com/4296A57/ |  | 9.79 | Item | Cost | Item | Cost | Item | Cost | Item | Cost | Item | Cost | Item | Cost
Power Supply | $289.99 | Amazon | https://www.amazon.com/Adjustable-Converter-Switching-Regulated-4-Digital/dp/B09QZ1R84M?s=industrial |  | 4 | Plexiglass | $84.56 | Urea | $20.00 | Nichrome Wire | $158.00 | Barbed Fitting x3 | 9.02 | PTFE Tubing x 25ft | $62.25 | Pressure gauge | $35.65
Total | $1299.97 |  |  |  |  | Mesh X 2 | $22.00 | lithium Chloride 30grams | $17.90 | Insulating Strips | $43.43 | Valves x2 | 42.2 | F-F Thread Adapter x2 | $19.12
 |  |  |  |  |  | Bolts | $7.60 | 12" Stainless Steel Pipe | $20.00 |  |  | Epoxy's | $20 | Copper Pipe (2ft) | $5.49
 |  |  |  |  |  | Solder | $30 |  |  |  |  |  |  |  |  |  |  |  |  | ALLOCATIONS
 |  |  |  |  |  | Nuts | $2.20 |  |  |  |  |  |  |  |  |  |  |  |  |  | Base | $1300.00
 |  |  |  |  |  | Other Plastic | $88.04 |  |  |  |  |  |  |  |  |  |  |  |  |  | TOTAL ALLOCATIONS | $1300.00
 |  |  |  |  |  | Power Supply | $289.99 |  |  |  |  |  |  |  |  |  |  | System Total |  | EXPENSES
 |  |  |  |  |  | Rubber Tape | $18.37 |  |  |  |  |  |  |  |  |  |  |  |  |  | Electrolysis | $675.00
stainless steel | https://www.mcmaster.com/6622K12-6622K122/ |  |  |  |  | Total | $542.76 |  | $57.90 |  | $201.43 |  | $71.22 |  | $86.86 |  | $35.65 | $995.82 |  |  | Material Storage | $230.00
3/4 od 0.71 id |  |  |  |  |  |  |  |  |  |  |  |  |  |  |  |  |  |  |  |  | Charge/Discharge | $87.00
 |  |  |  |  |  | 1 micron mesh | 20 | https://www.twpinc.com/1-micron-1-layer-sintered-stainless-mesh |  |  |  |  |  |  |  |  |  |  |  |  | Plumbing | $24.00
 |  |  |  |  |  | copper plates | 31 | https://www.amazon.com/CCTVMTST-Copper-Industry-Projects-Experiments/dp/B09NPWTT8M |  |  |  |  |  |  |  |  |  |  |  |  | Instrumentation | $400.00
 |  |  |  |  |  |  |  |  |  |  |  |  |  |  |  |  |  |  |  |  | Valves | $80.00
 |  |  |  |  |  |  |  |  |  |  |  |  |  |  |  |  |  |  |  |  | Sealant | $30.00
 |  |  |  |  |  |  |  |  |  |  |  |  |  |  |  |  |  |  |  |  | Electrical | $30.00
 |  |  |  |  |  |  |  |  |  |  |  |  |  |  |  |  |  |  |  |  | Team Shirts | $80.00
 |  |  |  |  |  |  |  |  |  |  |  |  |  |  |  |  |  |  |  |  | TOTAL EXPENSES | $1636.00
 |  |  |  |  |  |  |  |  |  |  |  |  |  |  |  |  |  |  |  | TOTAL |  | -$336.00

Sheet: Budget 2.0
 | Item | Quantity | Cost per unit | Total Cost | Supplier | Link | On PO? | Delivered?
Electrolysis
 | Polycarbonate (6"x6")(1/2" thick) | 7 | $12.20 | $85.40 | McMaster | https://www.mcmaster.com/8574K321/ | X | X
 | Copper plates (pack of 2) | 1 | $10.99 | $10.99 | Amazon | https://www.amazon.com/dp/B089VTMBCC?s=industrial&sp_csd=d2lkZ2V0TmFtZT1zcF9kZXRhaWw | X | X
 | Rubber Tape (1/2") (25ft) | 1 | $18.37 | $18.37 | McMaster | https://www.mcmaster.com/tape/rubber-sealing-tape/ | X | X
 | Nickel Mesh | 2 | $11.00 | $22.00 | McMaster | https://www.mcmaster.com/9225T361-9225T321/ | X | X
 | Bolts | 1 | $11.32 | $11.32 | McMaster | https://www.mcmaster.com/90272A363/ | X | X
 | Nuts | 1 | $4.60 | $4.60 | McMaster | https://www.mcmaster.com/90631A009/ | X | X
 | Liquid Gasket | 1 | $6.49 | $6.49 | Amazon | https://www.amazon.com/Permatex-81160-High-Temp-Silicone-Gasket/dp/B0002UEN1A | X
 | Power Supply | 1 | $141.99 | $141.99 | Amazon | https://www.amazon.com/Regulated-Variable-Adjustable-Accessories-Inverter/dp/B0924K3VQ5?hvadid=507777183588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 | X | X
 | Potassium Hydroxide | 1 | $15.99 | $15.99 | Amazon | https://www.amazon.com/Potassium-Hydroxide-Food-Grade-Pound/dp/B085NG5TRJ | X
 | DI Water | 1 | $0.00 | $0.00 | Chem lab
 |  |  | Electrolysis | $317.15
Material Storage
 | Lithium Doped Graphitic Carbon Nitride | 1 | $450.00 | $450.00 | Nanochem | https://www.nanochemazone.com/product/doped-graphitic-carbon-nitrides/ | X
 | 1 Micron SS Mesh | 4 | $10.00 | $40.00 | TWP | https://www.twpinc.com/1-micron-1-layer-sintered-stainless-mesh | X | X
 | 1 ft 3/4" 304 Stainless Steel | 1 | $17.16 | $17.16 | McMaster | https://www.mcmaster.com/89535K12-89535K121/ | X | X
 | Stainless Steel Zipties | 1 | $4.99 | $4.99 | HarborFreight | https://www.harborfreight.com/12-in-stainless-steel-cable-ties-25-pack-60330.html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
 |  |  | Material Storage | $512.15
Extraction
 | Nichrome Wire, Electrically Insulted (50ft) | 1 | $157.98 | $157.98 | Thomas Scientific | https://www.thomassci.com/Equipment/Heaters/_/Heater-Element-Wire-Electrically-Insulated | X
 | High Temp Insulating Fabric Roll (25ft) | 1 | $43.31 | $43.31 | McMaster | https://www.mcmaster.com/4057K3/ | X | X
 |  |  | Extraction | $201.29
Interfaces
 | Valves | 2 | $160.51 | $321.02 | McMaster | https://www.mcmaster.com/4537K24/ | X
 | Threaded Barbed fitting | 2 | $21.31 | $42.62 | McMaster | https://www.mcmaster.com/53505K64/ | X | X
 | Barbed T fitting | 3 | $7.49 | $22.47 | McMaster | https://www.mcmaster.com/5779K175/ | X | X
 | 1/4 NPT female to female (pack of 2) | 2 | $4.99 | $9.98 | Amazon | https://www.amazon.com/Pack-Coupler-Brass-Female-Fitting/dp/B082V8FJQJ?th=1 | X | X
 | Thermocouple Compression Fitting | 1 | $7.50 | $7.50 | hgsind | https://www.hgsind.com/product/thermocouple-compression-fittings-npt-thread?v=74 | X | X
 | Epoxys | 1 | $20.00 | $20.00
 |  |  | Interfaces | $423.59
Piping
 | PTFE Tubing (1/4") (10ft) | 1 | $3.48 | $3.48 | Amazon | EZ-FLO 0.17 Inch ID (1/4 Inch OD) PVC Clear Vinyl Tubing, 10 Foot Length, 98615: Amazon.com: Industrial & Scientific (https://www.amazon.com/Ez-Flo-98615-Clear-Vinyl-Tubing/dp/B07Q1D14HF) | X | X
 | Stainless Steel Pipe (0.75" OD 0.68" ID) (3ft) | 1 | $35.75 | $35.75 | McMaster | https://www.mcmaster.com/89895K757/ | X | X
 |  |  | Piping | $39.23
Instrumentation
 | Pressure Gauge 0-15 in wc | 2 | $51.70 | $103.40 | Grainger | https://www.grainger.com/product/WINTERS-Low-Pressure-Gauge-For-Natural-491C64 | X | X
 | Thermocouple wire | 1 |  |  | Prop lab
 | Thermocouple probes | 1 | $46.66 | $46.66 | Omega | https://www.omega.com/en-us/temperature-measurement/temperature-probes/probes-with-lead-wires/blmi/p/BLMI-304-J-18E-6 |  | X
 | Thermocouple readers | 2 |  |  | Prop Lab
 |  |  | Instrumentation | $150.06
 |  |  | TOTAL: | $1643.47
