dylanastrup/erh2/TeamsFiles_5_1_2023/Solidworks/Storage/StorageAssem.SLDASM

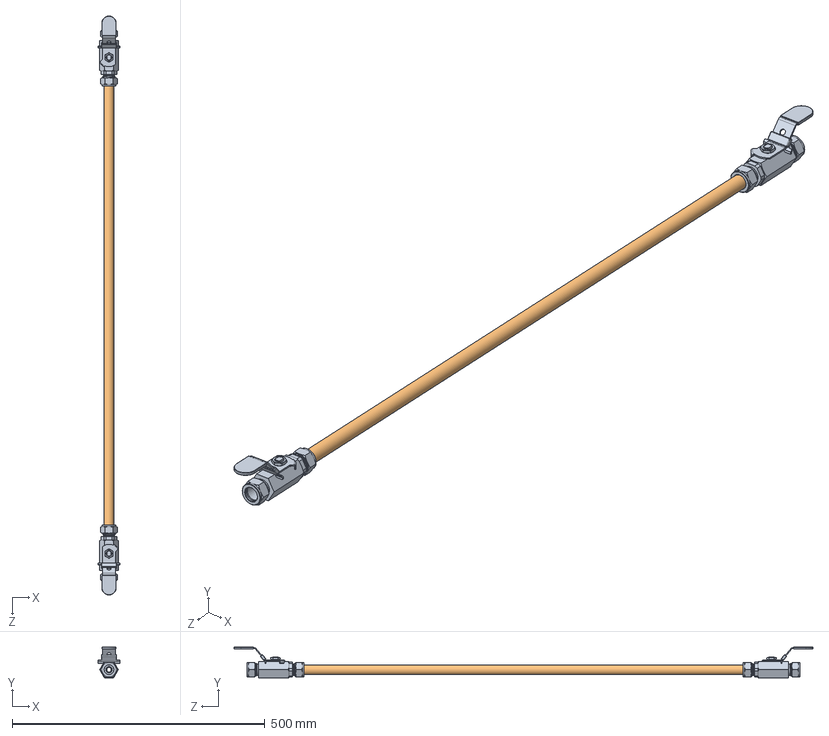
[picture p145: CAD file, 2023-05-08]
TeamsFiles_5_1_2023/Solidworks/Storage/StorageAssem.SLDASM
42.6 x 60.5 x 1146.4 mm
4537K24_On Off Valve with Lockable Lever Handle x 2
89895K159_Smooth-Bore Seamless 304 Stainless Steel Tubing
Capsule Body
Caps x 2
