dylanastrup/erh2/TeamsFiles_5_1_2023/Solidworks/Storage/StorageCapsule.SLDASM

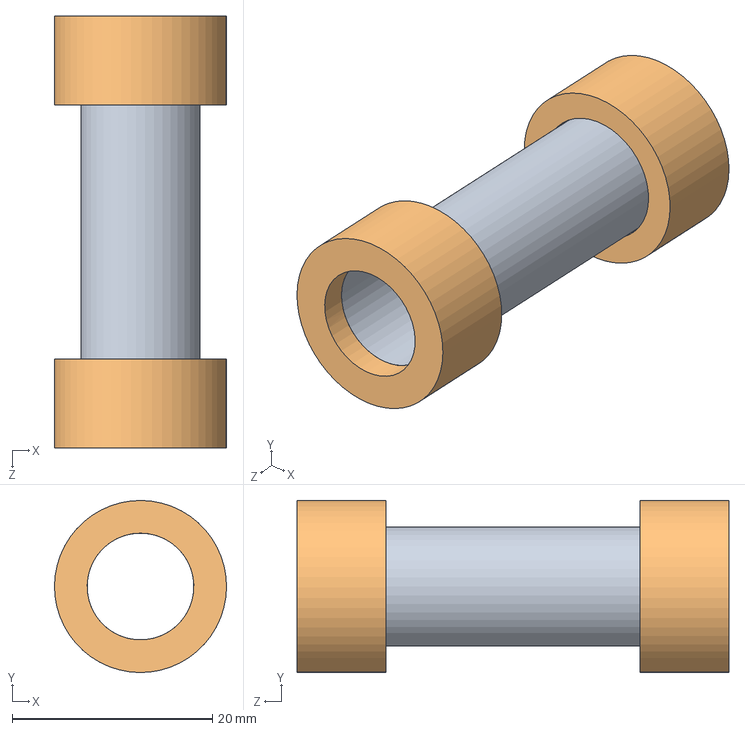
[picture p146: CAD file, 2023-05-08]
TeamsFiles_5_1_2023/Solidworks/Storage/StorageCapsule.SLDASM
17.2 x 17.2 x 43.2 mm
Capsule Body
Caps x 2
