dylanastrup/erh2/TeamsFiles_5_1_2023/Solidworks/Electrolysis/Meshwitch.SLDASM

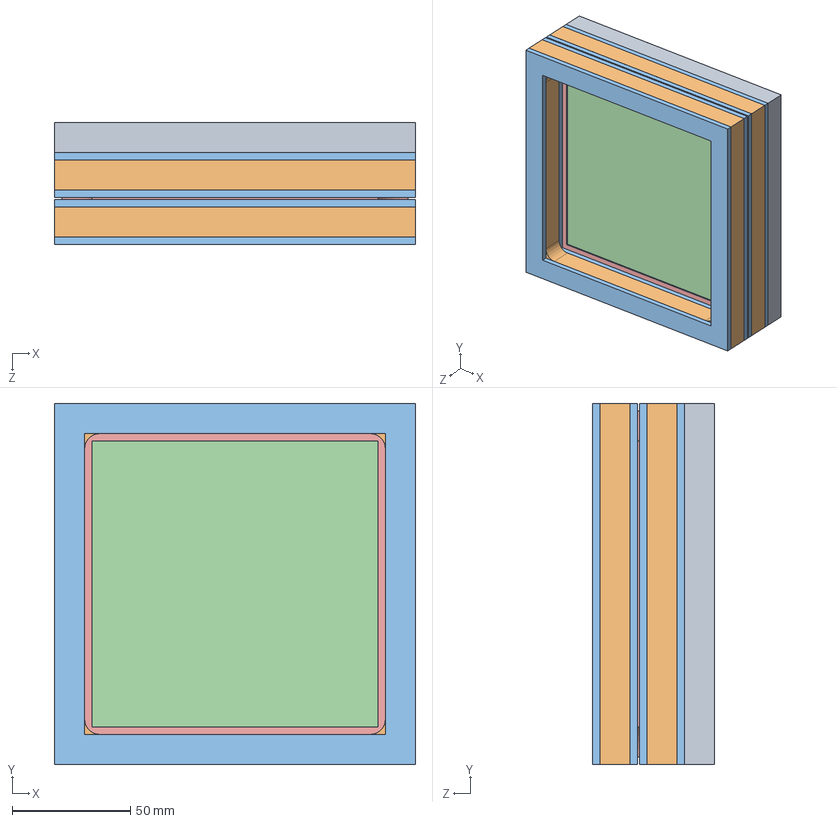
[picture p147: CAD file, 2023-05-08]
TeamsFiles_5_1_2023/Solidworks/Electrolysis/Meshwitch.SLDASM
152.4 x 152.4 x 51.7 mm
Walls
Space x 2
RubberGasket x 4
9225T321_Acid-Resistant 400 Nickel Wire Cloth
CopperBus
