dylanastrup/erh2/TeamsFiles_5_1_2023/Solidworks/Electrolysis/SaltBox.SLDASM

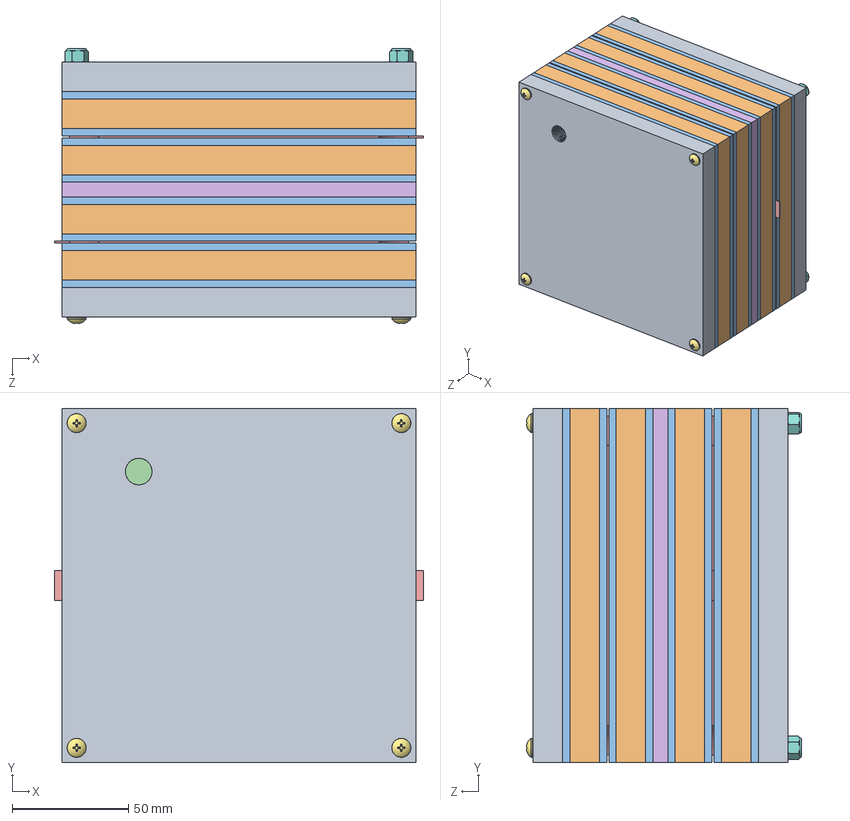
[picture p148: CAD file, 2023-05-08]
TeamsFiles_5_1_2023/Solidworks/Electrolysis/SaltBox.SLDASM
158.8 x 152.4 x 118.5 mm
Walls x 2
Space x 4
RubberGasket x 8
9225T321_Acid-Resistant 400 Nickel Wire Cloth x 2
CopperBus x 2
Stalagtight
90272A363_Zinc-Plated Steel Pan Head Phillips Screw x 4
90631A009_Low-Strength Steel Nylon-Insert Locknut x 4
