dylanastrup/erh2/TeamsFiles_5_1_2023/Solidworks/Electrolysis/MeshBus.SLDASM

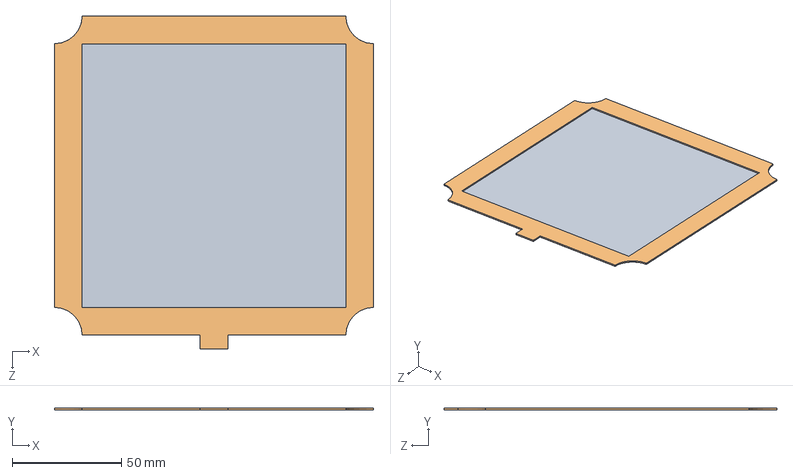
[picture p149: CAD file, 2023-05-08]
TeamsFiles_5_1_2023/Solidworks/Electrolysis/MeshBus.SLDASM
146.1 x 0.851 x 152.4 mm
9225T321_Acid-Resistant 400 Nickel Wire Cloth
CopperBus
