dylanastrup/erh2/TeamsFiles_5_1_2023/Solidworks/StorageCapsule.SLDASM

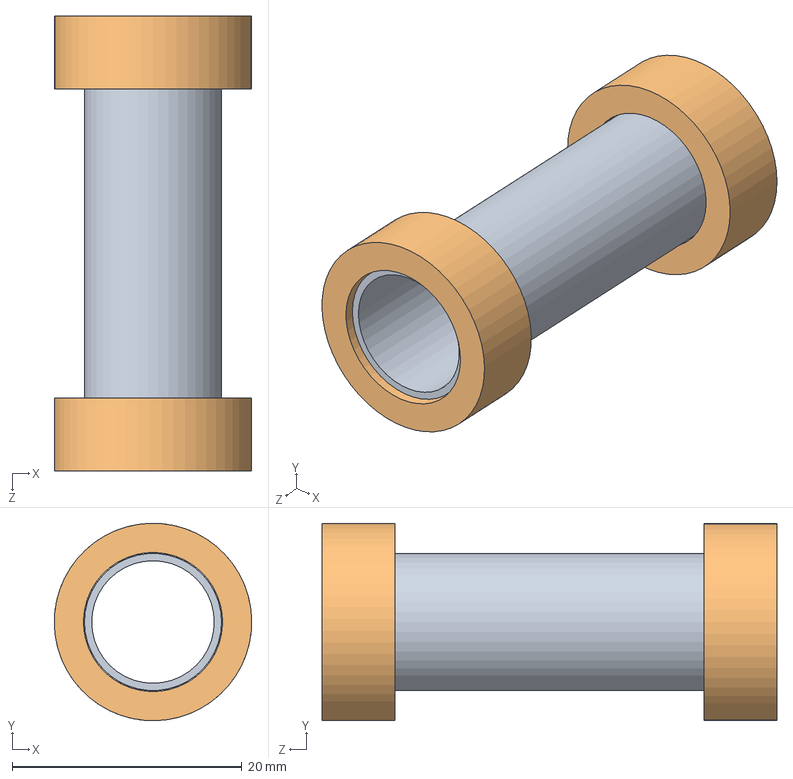
[picture p150: CAD file, 2023-05-08]
TeamsFiles_5_1_2023/Solidworks/StorageCapsule.SLDASM
17.2 x 17.2 x 39.6 mm
Capsule Body
Caps x 2
