dylanastrup/erh2/TeamsFiles_5_1_2023/Design/Electrolysis Unit.step

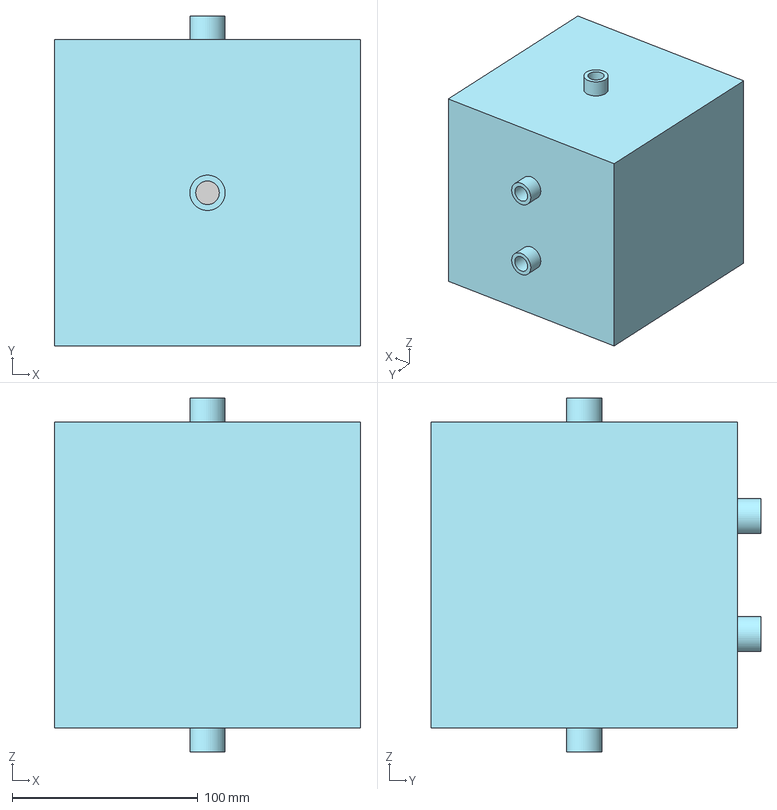
[picture p151: CAD file, 2023-05-08]
TeamsFiles_5_1_2023/Design/Electrolysis Unit.step
165.1 x 177.8 x 190.5 mm
9225T321_Acid-Resistant 400 Nickel Wire Cloth x 2
Enclosure
