dylanastrup/erh2/TeamsFiles_5_1_2023/Solidworks/Electrolysis/CopperBus.SLDPRT

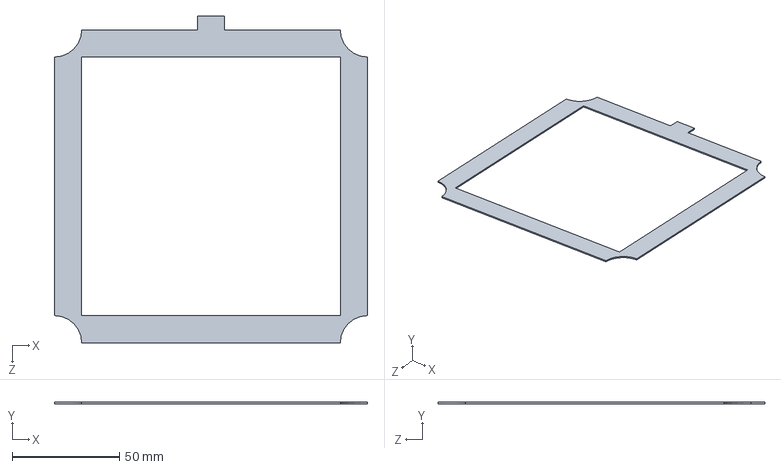
[picture p152: CAD file, 2023-05-08]
TeamsFiles_5_1_2023/Solidworks/Electrolysis/CopperBus.SLDPRT
146.1 x 0.8 x 152.4 mm
