dylanastrup/erh2/TeamsFiles_5_1_2023/Solidworks/4057k3 Insulation.SLDPRT

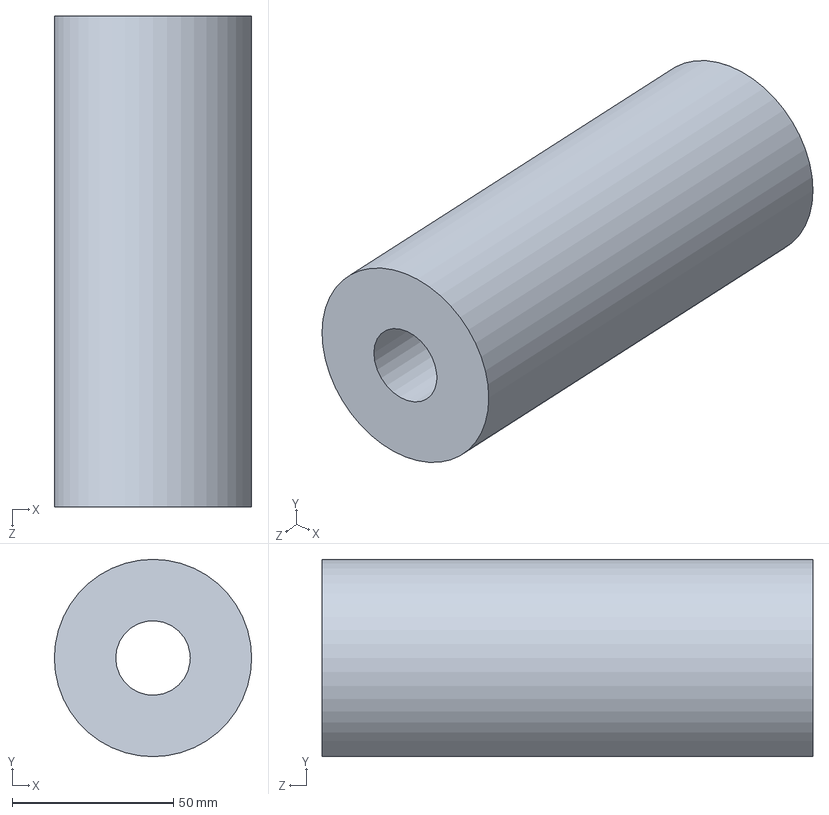
[picture p153: CAD file, 2023-05-08]
TeamsFiles_5_1_2023/Solidworks/4057k3 Insulation.SLDPRT
61.2 x 61.2 x 152.4 mm
