dylanastrup/erh2/TeamsFiles_5_1_2023/Solidworks/Storage/YorlokReducer.SLDPRT

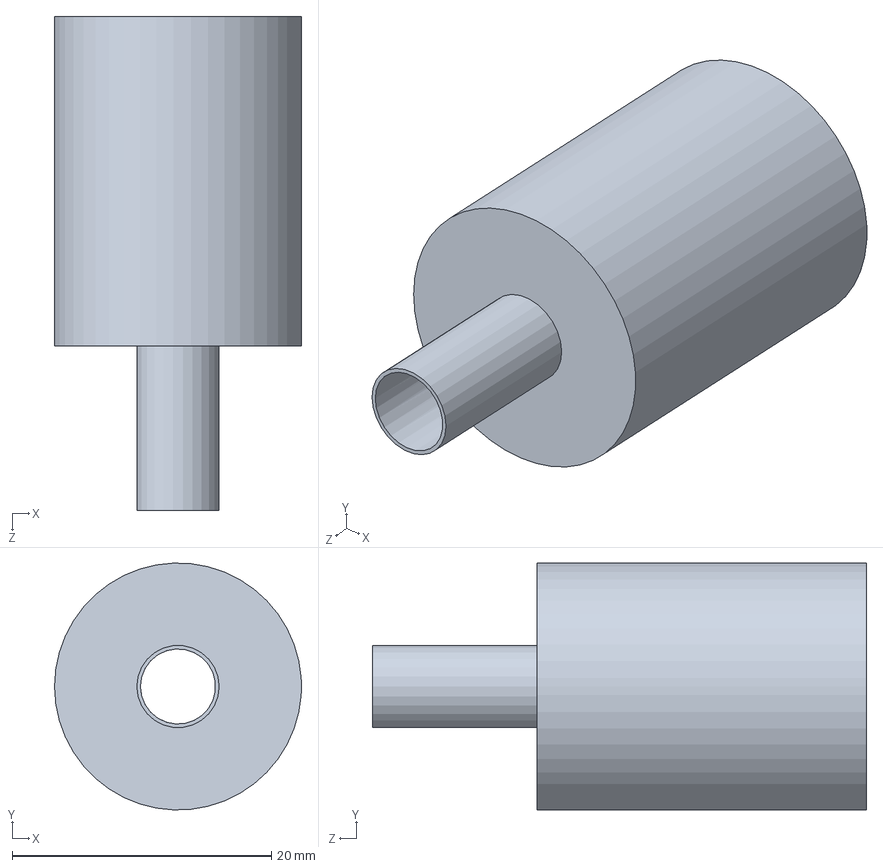
[picture p154: CAD file, 2023-05-08]
TeamsFiles_5_1_2023/Solidworks/Storage/YorlokReducer.SLDPRT
19.1 x 19.0 x 38.1 mm
