dylanastrup/erh2/TeamsFiles_5_1_2023/Solidworks/Electrolysis/Space.SLDPRT

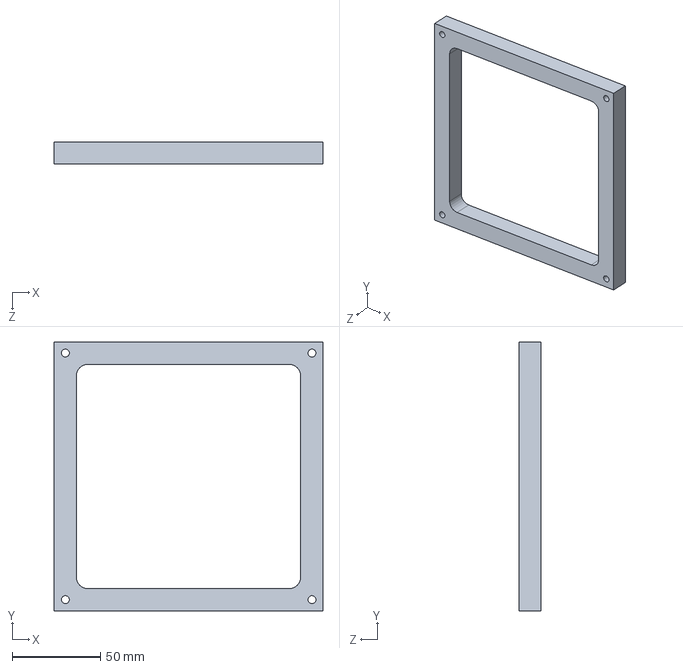
[picture p155: CAD file, 2023-05-08]
TeamsFiles_5_1_2023/Solidworks/Electrolysis/Space.SLDPRT
152.4 x 152.4 x 12.7 mm
