dylanastrup/erh2/TeamsFiles_5_1_2023/Solidworks/Storage/Caps.SLDPRT

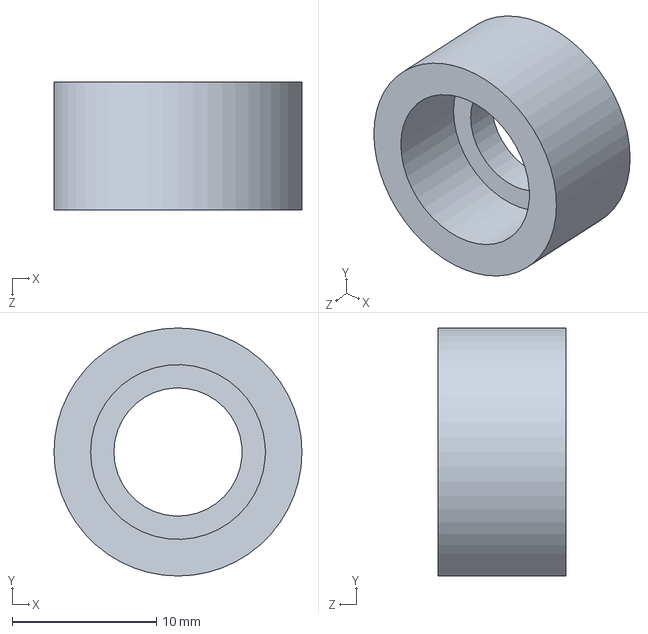
[picture p156: CAD file, 2023-05-08]
TeamsFiles_5_1_2023/Solidworks/Storage/Caps.SLDPRT
17.2 x 17.2 x 8.89 mm
