dylanastrup/erh2/TeamsFiles_5_1_2023/Solidworks/Electrolysis/Walls.SLDPRT

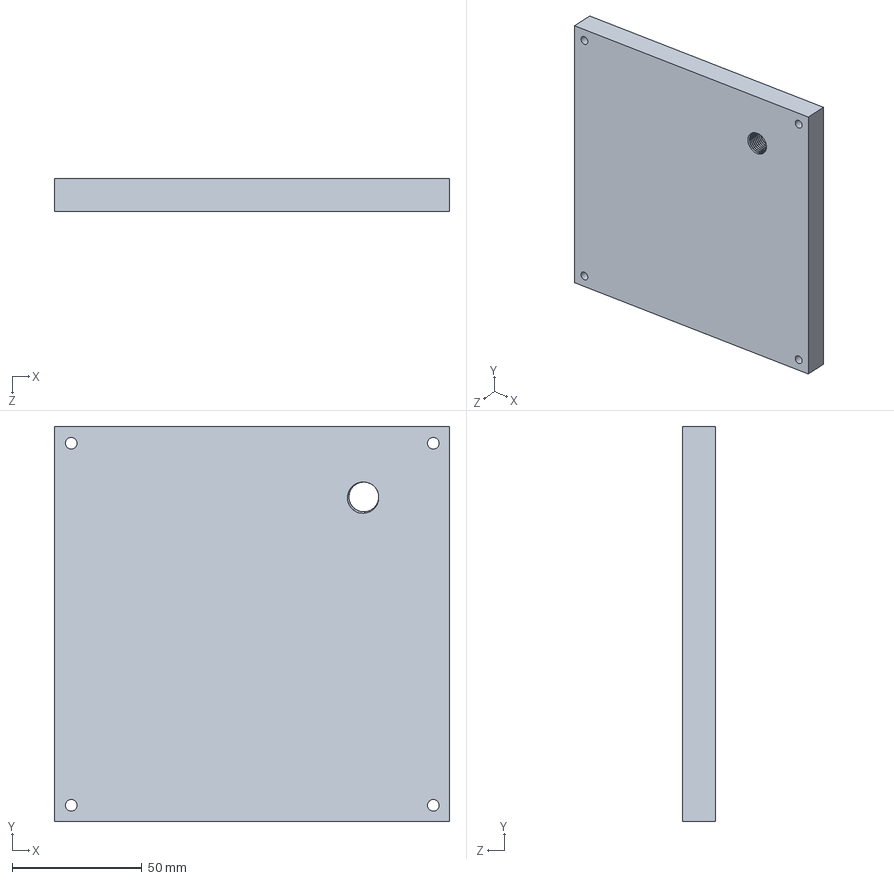
[picture p157: CAD file, 2023-05-08]
TeamsFiles_5_1_2023/Solidworks/Electrolysis/Walls.SLDPRT
152.4 x 152.4 x 12.7 mm
