dylanastrup/erh2/TeamsFiles_5_1_2023/Solidworks/fuelcell.SLDPRT

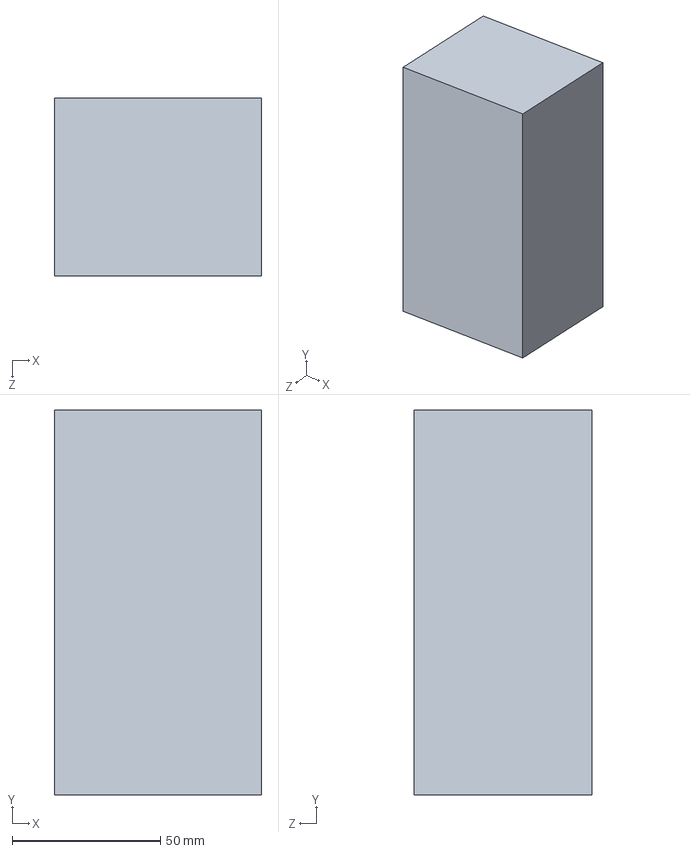
[picture p159: CAD file, 2023-05-08]
TeamsFiles_5_1_2023/Solidworks/fuelcell.SLDPRT
70.0 x 130.0 x 60.0 mm
