dylanastrup/erh2/TeamsFiles_5_1_2023/Solidworks/Caps.SLDPRT

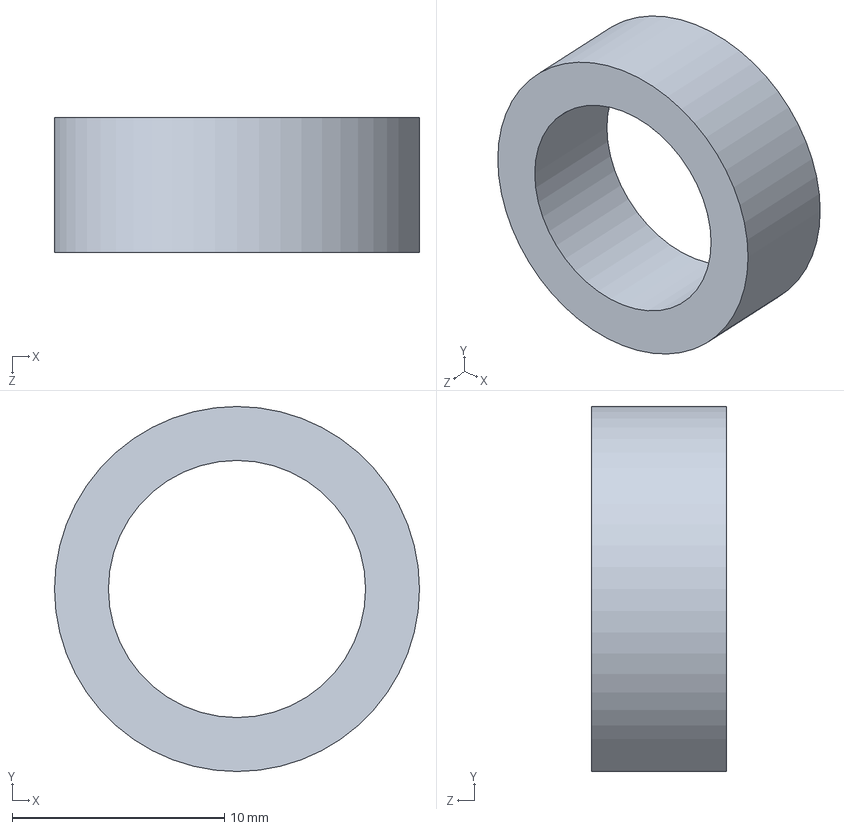
[picture p160: CAD file, 2023-05-08]
TeamsFiles_5_1_2023/Solidworks/Caps.SLDPRT
17.2 x 17.2 x 6.35 mm
