dylanastrup/erh2/TeamsFiles_5_1_2023/Solidworks/Electrolysis/RubberGasket.SLDPRT

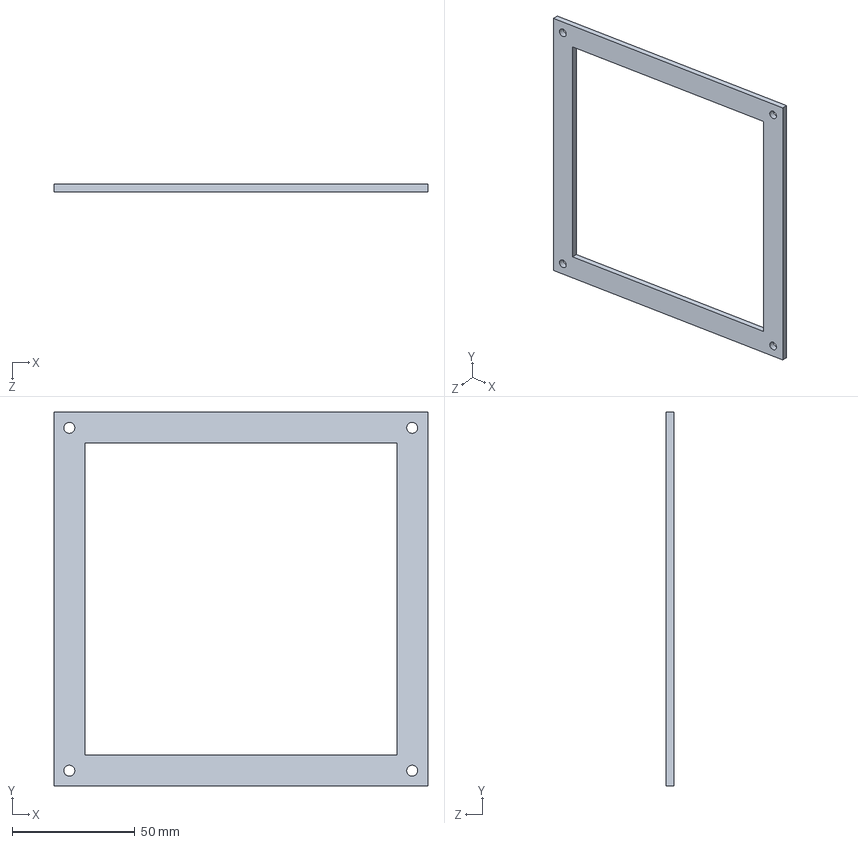
[picture p162: CAD file, 2023-05-08]
TeamsFiles_5_1_2023/Solidworks/Electrolysis/RubberGasket.SLDPRT
152.4 x 152.4 x 3.17 mm
