dylanastrup/erh2/TeamsFiles_5_1_2023/Solidworks/GaugeLead.SLDPRT

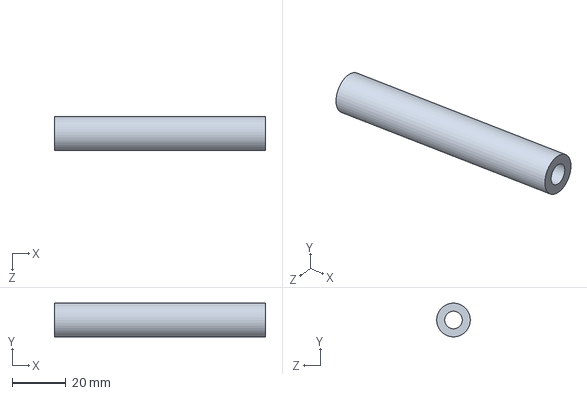
[picture p163: CAD file, 2023-05-08]
TeamsFiles_5_1_2023/Solidworks/GaugeLead.SLDPRT
78.7 x 12.6 x 12.6 mm
