dylanastrup/erh2/TeamsFiles_5_1_2023/Solidworks/Storage/Stalagtight.DXF

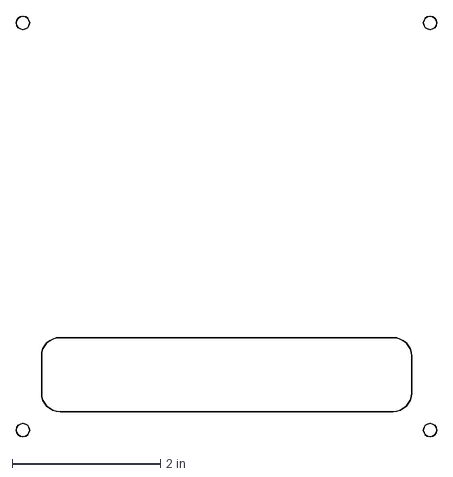
[picture p164: CAD file, 2023-05-08]
TeamsFiles_5_1_2023/Solidworks/Storage/Stalagtight.DXF
5.68 x 5.68 in
