dylanastrup/erh2/TeamsFiles_5_1_2023/Solidworks/Capsule Body.SLDPRT

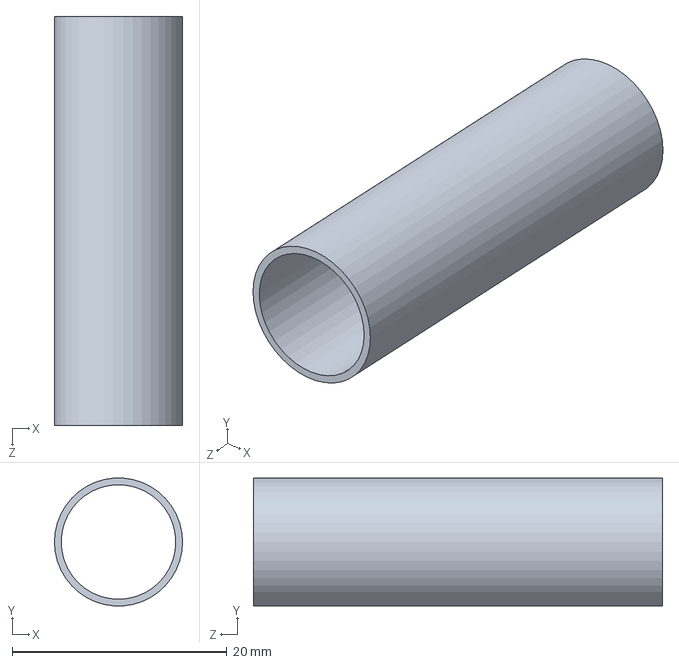
[picture p165: CAD file, 2023-05-08]
TeamsFiles_5_1_2023/Solidworks/Capsule Body.SLDPRT
11.9 x 11.9 x 38.1 mm
