dylanastrup/erh2/TeamsFiles_5_1_2023/Solidworks/Electrolysis/Stalagtight.SLDPRT

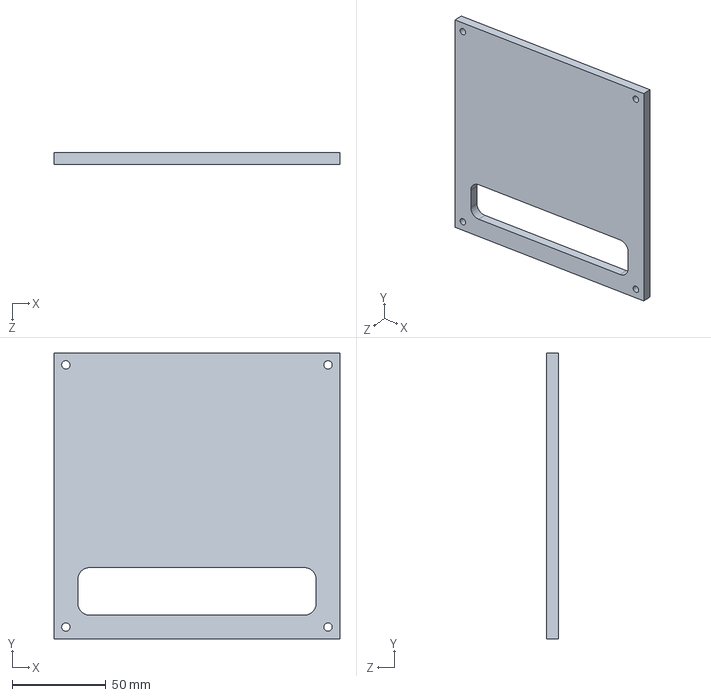
[picture p166: CAD file, 2023-05-08]
TeamsFiles_5_1_2023/Solidworks/Electrolysis/Stalagtight.SLDPRT
152.4 x 152.4 x 6.35 mm
