dylanastrup/erh2/TeamsFiles_5_1_2023/Solidworks/Nichrome.SLDPRT

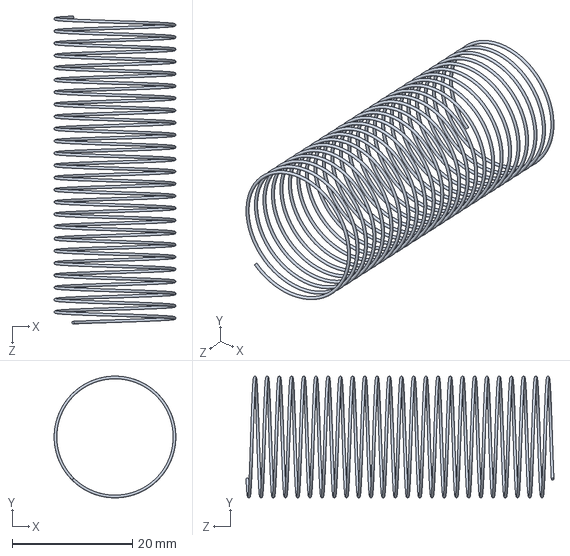
[picture p167: CAD file, 2023-05-08]
TeamsFiles_5_1_2023/Solidworks/Nichrome.SLDPRT
20.3 x 20.3 x 51.3 mm
