dylanastrup/erh2/(list of files, cad)

Other CAD files:
TeamsFiles_5_1_2023/Design/DCP documents/Energyland Layout/Energyland_outline.SLDPRT
TeamsFiles_5_1_2023/Design/DCP documents/Energyland Layout/Energyland_outline.SLDDRW
TeamsFiles_5_1_2023/Solidworks/2798K21_Pressure Gauge with Plastic Case and 304 Stainless Steel Bottom Connection.SLDPRT
TeamsFiles_5_1_2023/Solidworks/3856K911_Bendable Thermocouple Probe for Liquid and Gas.SLDPRT
TeamsFiles_5_1_2023/Solidworks/4429K111_Low-Pressure Brass Threaded Pipe Fitting.SLDPRT
TeamsFiles_5_1_2023/Solidworks/44555K162_Brass Low-Pressure Barbed Tube Fitting.SLDPRT
TeamsFiles_5_1_2023/Solidworks/5361K32_Barbed Hose Fitting.SLDPRT
TeamsFiles_5_1_2023/Solidworks/Electrolysis/90272A363_Zinc-Plated Steel Pan Head Phillips Screw.SLDPRT
TeamsFiles_5_1_2023/Solidworks/Electrolysis/90631A009_Low-Strength Steel Nylon-Insert Locknut.SLDPRT
TeamsFiles_5_1_2023/Solidworks/Electrolysis/9225T321_Acid-Resistant 400 Nickel Wire Cloth.SLDPRT
TeamsFiles_5_1_2023/Solidworks/Electrolysis/Electrolysis.SLDDRW
TeamsFiles_5_1_2023/Solidworks/Electrolysis/Electrolysis_water_jet_cutouts.SLDDRW
TeamsFiles_5_1_2023/Solidworks/Storage/4537K24_On Off Valve with Lockable Lever Handle.SLDPRT
TeamsFiles_5_1_2023/Solidworks/Storage/89895K159_Smooth-Bore Seamless 304 Stainless Steel Tubing.SLDPRT
TeamsFiles_5_1_2023/Solidworks/Storage/STORAGEASSEM.SLDDRW
