dylanastrup/erh2/TeamsFiles_5_1_2023/Test Readiness/Test Matrix - Copy.xlsx

Test Objective | Location | Facilities and Equipment | Procedure Overview | Documentation | Success Criteria
Determine material storage capacity | Stem 114 | Vent hood, electrolysis to material storage system, material storage capsule, pressure gauge, scale. | To begin, the material capsule is weighed and the mass recorded. The capsule will be inserted into the system and a system flush will be done. After the flush the valve to the fuel cell will be closed and the electrolysis will run until maximum pressure is reached. Then the valve will open again to vent the hydrogen out of the system and the capsule will be removed and weighed again. Using the capasity equation, the material storage wt % of hydrogen is found. | Excel documenting the mass before, mass after, time to load, and pressures after every minute. | The test is successful if the final mass of the capsule is at least 0.02 grams heavier than the initial mass
Determine the amount of hydrogen released from the material storage | Stem 114 | Vent hood, material storage capsule, nichrome wire system, pressure gauge, thermocouple, scale, material storage to fuel cell configuration, fuel cell, and stopwatch. | The material storage capsule is weighed and the mass is recorded. The capsule is reinserted into the system and aligned in the heating zone. Run a flush on the system and then initiate the extraction procedure. Record the temperature of the heating zone every 5 minutes until it reaches 300 C. Once at target temperature, begin throttling valve to fuel cell until fuel cell light turns on. Record how long the light stays on. After light turns off, remove capsule when thermocouple indicates a safe temperature and weigh again. | Excel documenting the mass before, mass after, time fuel cell opperating, and temperature every 5 minutes. | The test is successful if the final mass of the capsule is equal to the initial mass of the capsule or the fuel cell is able to run for at least 5 minutes.
Determine material release rate | Stem 114 | Vent hood, material storage capsule, nichrome wire system, pressure gauge, thermocouple, scale, material storage to fuel cell configuration, and stopwatch. | The material storage capsule is weighed and the mass is recorded. The capsule is reinserted into the system and aligned in the heating zone. Run a flush on the system and then initiate the extraction procedure. Keep exit valve open and crimp the end that would run into the fuel cell. Record the temperature of the heating zone every 5 minutes until it reaches 300 C. Once the pressure gauge indicates an increase in pressure, record changes in the pressure over time and the temperature at that time. Once pressure gauge stops changing, vent the hydrogen into the vent hood, remove capsule when thermocouple indicates a safe temperature, and weigh again. | Excel documenting the mass before, mass after, pressure and temperature at time intervals to find the release rate of the material. | Test is successful if the pressure gauge indicates a change in pressure equivalent to 0.02 grams of hydrogen over a 10 minute time period.
Determine the amount of hydrogen produced by electrolysis | Stem 114 | Vent hood, electrolysis to valve 1, pressure gauge, electrolysis thermocouple, and stopwatch. | Fill electrolysis with salt solution and ensure safe electrical connection. Turn on power supply to 10 amps and recorded the pressure change over time until the maximum pressure of 4-inWC. Vent hydrogen into the vent hood and repeat the process at 15, 5, and 20 amps. | Exel with different pages for amperage documenting the change in pressure over time. | The test is successful if the electrolysis produces at least 0.02 grams of hydrogen.
To ensure the ends of the pipe do not reach critical temperatures | Stem 114 | Heating system, pipe to hold capsule, thermocouple | Connect power supply to heating element and place a thermocouple in the heating zone and at the end of the pipe where the valve would be. Turn on the power supply and record the temperature of the heating zone and the end of the pipe over time. Stop test when the heating zone reaches 350 C. | Excel documenting the temperature of the different components over time. | The test is successful if the ends of the pipe do not exceed 60 Celcius.
To detect leaks in the system | AXFAB | Compressed air hose, soap, ERH2 system from the electrolysis to the fuel cell | At all interfaces and valves, apply soap mixture covering the interface, and connect to the compressed air hose. Run the compressed air through the system and document where bubbles occur. | Excel documenting test number and where leak is detected along with steps to stop the leak. | The test is successful if no bubbles form.
Test the amperage of the nichrome wire | Stem 114 | Power supply, nichrome wire, stainless pipe, thermocouple
Test the fuel cell efficiency | Stem 114 | Fuel cell, multimeter, electrolysis, ptfe tubing, pressure gauge, thermocouple. | Connect the electrolysis to the fuel cell and pressure gauge. Turn on electrolysis and crimp tubing to trap hydrogen before fuel cell, meaure the pressure and temperature to find the mass of hydrogen. Turn off electrolysis after two minutes. Record the voltage of the fuel cell over time until it reaches 0. | Excel documenting the mass of hydrogen going into the fuel cell vs the voltage out. | The test is successful if the efficiency is greater than 25%
Test temperature of insulation | Propulsion Lab | Nichrome wire, Insulation tape, power supply, stainless steel pipe, thermocouple, thermal imaging camera | Connect power supply to heating element and place a thermocouple in the heating zone and at the surface of the insulation. Turn on the power supply and record the temperature of the heating zone, the temperature of the surrounding air, and the insulation over time. Turn off power supply when the heating zone reaches 350 C. | Excel documenting the temperature of the different components over time. | The test is successful if the insulation temperature does not exceed the surrounding air temperature.
 |  |  | Use bead for thermocouple, faster to respond, but fragile
 |  |  | We have k thermocouples, stem 114 for j probes, j wire in prop lab
 |  |  | thermocouple wire in the electrolysis, order fiberglass insulation to prevent melting
 |  |  | Npt to yorlock, pass through fitting
