dylanastrup/erh2/TeamsFiles_5_1_2023/Tests/Tests.xlsx

Sheet: Heating the Pipe
Testing the temperature of the pipe
2023-04-18
1:10pm
Prop Lab
0.9 A, ~20 V
Time (min) | Temp from Thermocouple (C) | Temp Increase (C)
0 | 22.8
10 | 171.2 | 148.4
15 | 195.8 | 24.6
20 | 211.9 | 16.1
25 | 226 | 14.1
30 | 237 | 11
35 | 246.1 | 9.1 | <- @35 min, increased to 24.92V & 1.13A
40 | 303 | 56.9
45 | 321.9 | 18.9
50 | 334.1 | 12.2
55 | 348 | 13.9 | <- @55 min, begin playing with voltage to find voltage that keeps it constant
60 | 350 |  | 24.22V 1.08A, still increasing
To hold steady @350 C: 23.1V, 1A
6 inches from center: 31C
To hold steady @300 C: 19.5V 0.86A
Time (min) | Temp from Thermocouple (C) | Temp Decrease (C)
0 | 300
1 | 266 | 34
2 | 252 | 14
3 | 238 | 14
4 | 226 | 12
5 | 214 | 12
6 | 204 | 10
7 | 195.5 | 8.5
9 | 180.9 | 14.6
10 | 174.2 | 6.7
11 | 168.2 | 6
12 | 162.4 | 5.8
13 | 156.9 | 5.5
14 | 152.1 | 4.8
15 | 147.2 | 4.9
20 | 126.4 | 20.8 |  | Time Contant: Time to get to 63.2% of the total temperature change
25 | 109.3 | 17.1 |  | Ambient | 75 | F
30 | 95.6 | 13.7 |  |  | 23.88888889 | C
35 | 85.5 | 10.1 |  | Change | 276.1111111 | C
40 | 75.4 | 10.1 |  | 63.20% | 174.5022222 | C
45 | 67.6 | 7.8 |  | Time | 10 | Minutes
55 | 54.6 | 13
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
