dylanastrup/erh2/TeamsFiles_5_1_2023/Research and Citations/Research/Storage/Graphitic Carbon Nitride/Experiment SHeet.xlsx

Loading |  |  |  |  | Un-Loading
Urea/Sugar (165g total) |  | Starting Mass (g) | Ending Mass (g) | Ammount loaded (Flow?Mass?) | Urea/Sugar (% mass) | Starting Mass (g) | Ending Mass (g) | Time Heated
150/15 |  |  |  | X | 150/15 |  |  | 10 Min
 |  |  |  | Y |  |  |  | 20Min
 |  |  |  | Z |  |  |  | 30Min
135/30 |  |  |  |  | 135/30 |  |  | 11 Min
 |  |  |  |  |  |  |  | 20Min
 |  |  |  |  |  |  |  | 30Min
120/45 |  |  |  |  | 120/45 |  |  | 12 Min
 |  |  |  |  |  |  |  | 20Min
 |  |  |  |  |  |  |  | 30Min
105/60 |  |  |  |  | 105/60 |  |  | 13 Min
 |  |  |  |  |  |  |  | 20Min
 |  |  |  |  |  |  |  | 30Min
150g urea | 10 parts Urea
15g sugar | 1 part Sugar
