dylanastrup/erh2/TeamsFiles_5_1_2023/Test Readiness/ERH2_SOP.pdf

# Standard Operating Procedure

This form is not complete until Approvals are logged.

### 1. General Information

### 1.1 Lab-Specific Information

Building/Room(s) cover ed by this SO P: | STEM 114
College/O r ganization: | COE
Depar tment: | Mechanical Engineering Capstone, ERH2
Pr incipal Investigator Name: | Dylan Astrup
SO P Effective Date (review annually at a minimum) | 3/17/2023

### 1.2 - This Standard Operating Procedure (SOP) is for a:

☐ Specific laboratory procedure or experiment (e.g. synthesis of carbon nanotubes)
☒ Generic laboratory procedure that covers several chemicals (e.g. chromatography)
☐ Generic use of specific chemical/class of chemicals with similar hazards (e.g. organic azides)

### 1.3 - Hazard Summary

☒ Chemical hazard(s) | ☐ Hazardous waste generated
☐ Physical hazard(s)
☐ Biological hazard(s) | ☐ Biological waste generated
☐ Radiological hazard(s) | ☐ Radiological waste generated

### 1.4 - Approvals

Prior to conducting any work, the Principal Investigator must ensure that this SOP has been approved. Inquire with EH&S as to which approvals are required.

Name | Signature | Date
Dylan Astrup | | Click or tap to enter a date.
Michael Brady | | Click or tap to enter a date.
Enter name of other approver, if applicable | | Click or tap to enter a date.

### 2. Process or Experiment Description:

Note: You will need to complete Section 3 before you can draft your procedures section. This section appears first for usability of the final document, placing the most relevant information first.

Mater ials & Equipment List:

- PPE (Safety goggles, nitrile gloves, lab coat)
- Beaker
- Glass stirring rod

Chemical List:

- Graphitic Carbon Nitride
- Silicone
- Potassium Hydroxide

Gr aphitic Car bon Nitr ide

Pr er equisites:

1. Ensur e PPE is available and in appr opr iate condition for use. Don PPE.

Pr ocedur e:

1. Place capsule and material under vent hood.
2. Remove one side of capsule.
3. Pour material into capsule.
4. Seal open side of capsule.
5. Enclose filled capsule in secondary sealed container.

Silicone Gasket

Pr er equisites:

1. Ensur e PPE is available and in appr opr iate condition fo r use. Don PPE.

Pr ocedur e:

1. Place electr olyzer , pipe assembly, and silicone under vent hood.
2. Tur n on vent hood.
3. Apply silicone gasket to all thr eaded connections.
4. Let dr y for 10 minutes befor e r emoving fr om vent hood.

Potassium Hydr oxide

Pr er equisites:

1. Ensur e PPE is available and in appr opr iate condition for use. Don PPE.

Pr ocedur e:

1. Place beaker containing 1 liter of distilled water, electrolyzer, and potassium hydroxide under vent hood.

2. Pour 320 gr ams of potassium hydr oxide into water .
3. Use glass r od to mix potassium hydr oxide until fully dissolved.
4. Pour mixed water into electr olyzer .

### 3. Planning

### 3.1 - Storage Requirements:

Select the type of storage cabinets required:

☐ Flammable | ☐ Corrosive | ☐ Toxic | ☐ Oxidizer | ☒ General

Store in cool, dry place. Handle with safety goggles and chemical-resistant gloves.

### 3.2 - Engineering Controls:

☐ Process Control - Click here to enter text.
☐ Enclosure or Isolation - Click here to enter text.
☒ Redirection (e.g. ventilation) – Usage of all three chemicals will be done under a vent hood.
Note: Use of Engineering Controls should be evident in the detailed procedures in Section 2. If special steps are required for using the engineering control with this SOP, it needs to be addressed in your procedures. Otherwise, refer to the appropriate SOP for the engineering control in Section 2.

### 3.3 - Personal Protective Equipment:

Eyewear | Safety Goggles
Gloves | ☒ Disposable Nitrile | ☐ Thermal/Cryogenic | ☐ Abrasion Resistant ☐ Butyl Rubber/Neoprene
☐ Other: Click here to enter text.
Pr otective Clothing ☒ Lab Coat | ☐ Synthetic Lab Apron | ☐ Tyvek Suit | ☐ Shoe Covers
☐ Formed Boots | ☐ Other: Click here to enter text.
Respir ator | ☐ Air-purifying | ☐ Atmosphere-supplying ☐ Filters/Cartridges: Click here to enter text.
Note: Refer to Section 8 of the SDS.

### 3.4 - Spill and Accident Procedures

Safety Equipment (all located in STEM 114): Showers
Eyewash station

Ventilation system

Graphitic Carbon Nitride
Sweep up, place in bag, hold for waste disposal.
Avoid raising dust, ventilate area, wash spill site after material pickup.

Silicone Gasket
Ensure adequate ventilation. Flood with water to complete polymerization. Scrape off floor, throw away.

Potassium Hydroxide
Sweep into corrosive resistant polypropylene container with a resistant inliner.

### 3.5 - Fire Safety

Safety Equipment (in STEM 114):
Fire extinguisher
Fire alarm manual pull station

Graphitic Carbon Nitride
N/A, non-combustible

Silicone
Flash point 93°C.
Will be kept below 50°C.

Potassium Hydroxide
Nonflammable.
Surrounding fire would cause thermal decomposition, releasing irritating gases. Will not be near any heat source nor flame.

### 3.6 - Waste Disposal

Graphitic Carbon Nitride
No anticipated waste generation: Will be permanently kept in system.
Disposal if spilled: Graphitic Carbon Nitride dissolved in combustible solvent will be collected in an appropriate plastic or glass container, labeled flammable waste, and placed in the CAA for the building.

Silicone
No anticipated waste generation: Will become part of the system.
Disposal if spilled: Throw away.

Potassium Hydroxide
Waste produced at end of test campaign (this semester): about 1 liter of water with dissolved potassium hydroxide. Disposal: Potassium Hydroxide will be collected in a plastic or glass container, labeled corrosive, and placed in the CAA for the building.

### 3.7 - Training Requirements

Who must be trained on this SOP: Team members (Dylan Astrup, Hannah Spiller, Tesla Alford, Titan Berson, Grant Carrabine, Jacob Wolf

Frequency of training for this SOP: Initial only
Documentation of Training After training, each section of this SOP will be initialed by each team member to record understanding of the training & protocols. That document will be scanned and uploaded to our Microsoft Team with the rest of our team files. Complete EHS 101 Lab and Shop
Safety https://erau.instructure.com/enroll/PGGAPA
Actions that trigger mandatory re -training:
☐ Change in work conditions | ☐ Off-cycle update to SOP
☒ Non-compliance with SOP | ☐ Other: Click here to enter text.

Nature of training required for this SOP:
☐ EHS-100 (online) | ☐ In-person/classroom | ☒ Hands-on

Additional training required for safe execution of this SOP:
☐ Chemical Hygiene Plan | ☐ Lab Safety Plan | ☐ Biological Safety Plan
☐ Radiation Safety Plan | ☐ Engineering Controls: Click here to enter text.
☐ Acid Dilutions | ☐ Chemical Container Labeling | ☐ Chemical Inventory
☐ Compressed Gas Cylinders | ☐ Cryogenic Liquids | ☒ Eyewash & Safety Showers
☐ Flammable Liquids | ☐ General Reagents | ☐ Hazardous Waste
☐ Heating Devices | ☐ Highly Reactive Chemicals | ☐ Housekeeping
☐ Labware Washing | ☐ Nitric Acid | ☐ Non-hazardous Waste Disposal
☐ Phenolphthalein | ☐ PPE | ☐ Sharps Handling
☐ Sodium Hydroxide Solutions | ☐ Other: Click here to enter text. | ☐ Other: Click here to enter text.
☐ Other: Click here to enter text. | ☐ Other: Click here to enter text. | ☐ Other: Click here to enter text.

### Appendix I. Detailed Hazards Description

Prepare this section as an attachment to the SOP. Use the following table to describe hazards. Refer to Safety Data Sheets (SDSs) and other resources like https://toxnet.nlm.nih.gov/newtoxnet/hsdb.htm. Copy/paste the table as many times as necessary based on the number of chemicals used in the procedure.
Click h ere t o en t er c h em ic al n am e an d CAS # Choose an item.

P h ysic al Hazard s
☐ Explosives | ☐ P yro p h o ric L iq u id s
☐ Flammable Gases | ☐ P yro p h o ric So lid s
☐ Flammable Aero so ls | ☐ P yro p h o ric Gases
☐ Ox id izin g Gases | ☐ Self-Reac t ive
☐ Gases u n d er P ressu re | ☐ Self-h eat in g
☐ Flammable Liquids | ☐ Co rro sive t o Met als
☐ Oxidizing Liquids | ☐ Organ ic P ero x id es
☐ Oxidizing Solids | ☐ Co m b u st ib le D u st s
☐ Chemicals that emit flammable gases u p o n w at er c o n t ac t
☐ | ☐ | ☐
☐ | ☐ | ☐
☐ | ☐

Health Hazards
☐ Acute Choose an item. Toxicity Click here to enter Category # ☐ Skin Corrosion/Irritation Click here to enter Category #
☐ Serious Eye Damage/Irritation Click here to enter Category # ☐ Respiratory or Skin Sensitization Click here to enter Category # ☐ Germ Cell Mutagenicity Click here to enter Category #
☐ Carcinogenicity Click here to enter Category #
☐ Reproductive Toxicity Click here to enter Category #
☐ Specific Choose an item. Target Organ Toxicity Click here to enter Category # ☐ Aspiration Hazard Click here to enter Category #
☐ Simple Asphyxiant Click here to enter Category #
Routes of Exposure
☐ Eye Contact | ☐ Inhalation | ☐ Ingestion
☐ Skin Contact | ☐ Skin Absorption
Symptoms of Exposure
Eye Contact: Click here to describe symptom(s) of exposure Skin Contact: Click here to describe symptom(s) of exposure Inhalation: Click here to describe symptom(s) of exposure Toxicity Limits: Click here to enter; Review Section 11 of SDS Exposure Monitoring: ☐ No
☐ Yes State method(s).
Other Hazards
Click here to describe non-chemical hazards (e.g. biological, electrical, mechanical, nonionizing radiation, etc.)

### Appendix II. Safety Data Sheets

Prepare this section by attaching the SDS for the chemicals used in this SOP. Use the specific SDS provided by the manufacturer of the chemical.
