dylanastrup/erh2/TeamsFiles_5_1_2023/Design/ERH2_Poster.pdf

# Embry-Riddle Hydrogen

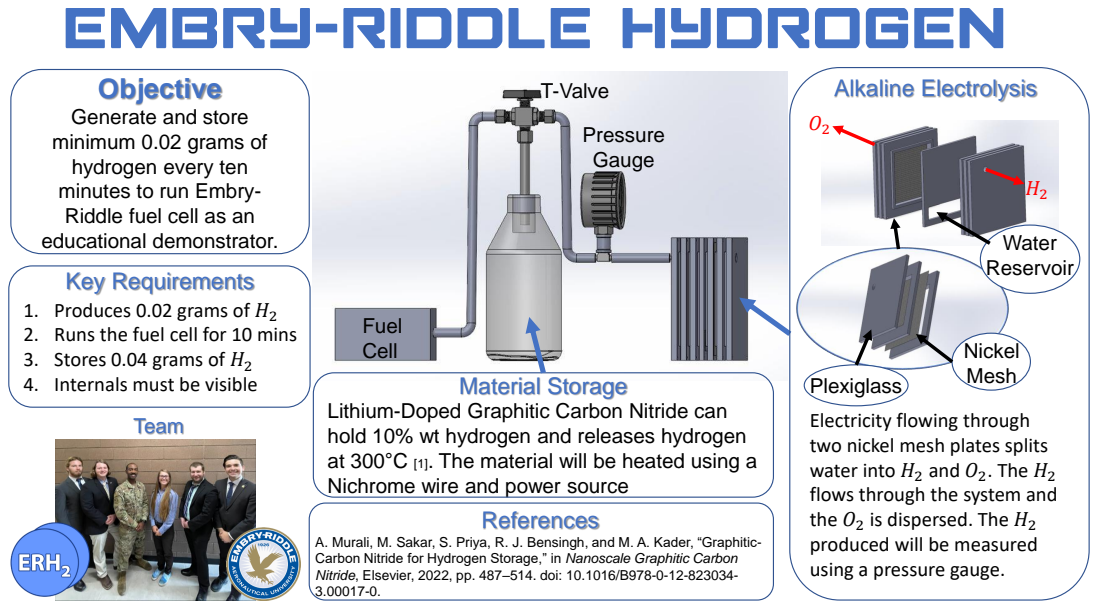
[picture p190: page 1]
Objective; Alkaline Electrolysis; Team; References; Material Storage; Nickel Mesh Plexiglass; Water Reservoir; Fuel Cell; T-Valve; Pressure; Gauge

Generate and store
minimum 0.02 grams of
hydrogen every ten
minutes to run Embry-
Riddle fuel cell as an
educational demonstrator.
Key Requirements
1. Produces 0.02 grams of H2
2. Runs the fuel cell for 10 mins
3. Stores 0.04 grams of H2
4. Internals must be visible

Lithium-Doped Graphitic Carbon Nitride can
hold 10% wt hydrogen and releases hydrogen
at 300°C [1]. The material will be heated using a
Nichrome wire and power source

Electricity flowing through
two nickel mesh plates splits
water into H2 and O2. The H2
flows through the system and
the O2 is dispersed. The H2
produced will be measured
using a pressure gauge.

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
