dylanastrup/erh2/TeamsFiles_5_1_2023/Design/ERH2_Poster_Final.pdf

# Embry-Riddle Hydrogen

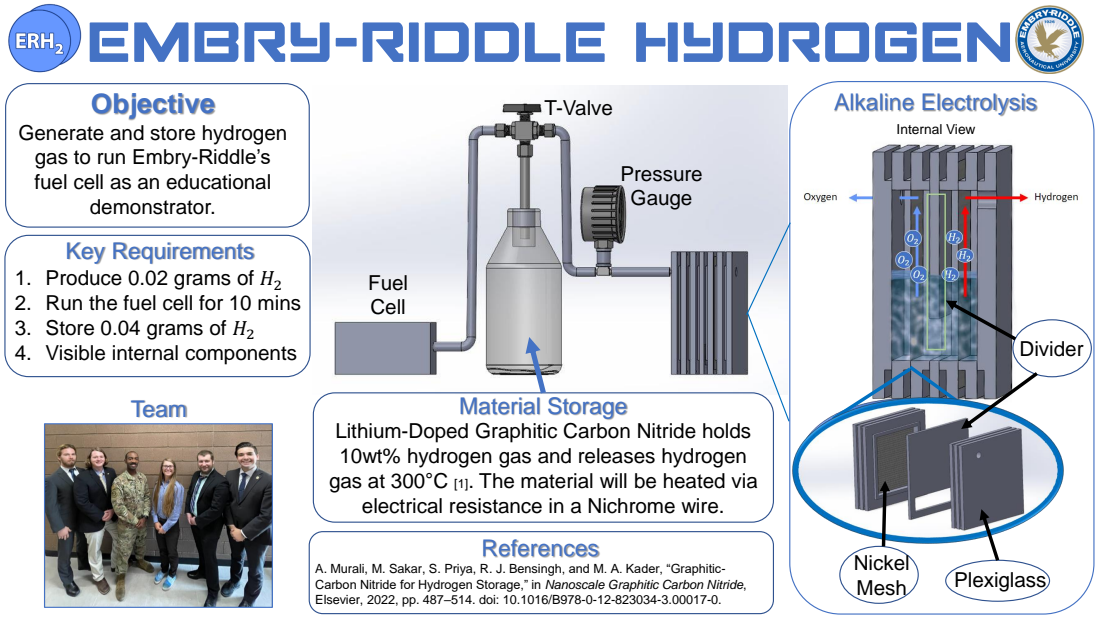
[picture p191: page 1]
Objective; Alkaline Electrolysis; Team; References; Material Storage; Nickel; Mesh; Plexiglass; Fuel Cell; T-Valve; Pressure Gauge; Internal View; Divider

Generate and store hydrogen
gas to run Embry-Riddle’s
fuel cell as an educational
demonstrator.

Key Requirements
1. Produce 0.02 grams of H2
2. Run the fuel cell for 10 mins
3. Store 0.04 grams of H2
4. Visible internal components

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
