dylanastrup/erh2/TeamsFiles_5_1_2023/Solidworks/allofit.pdf

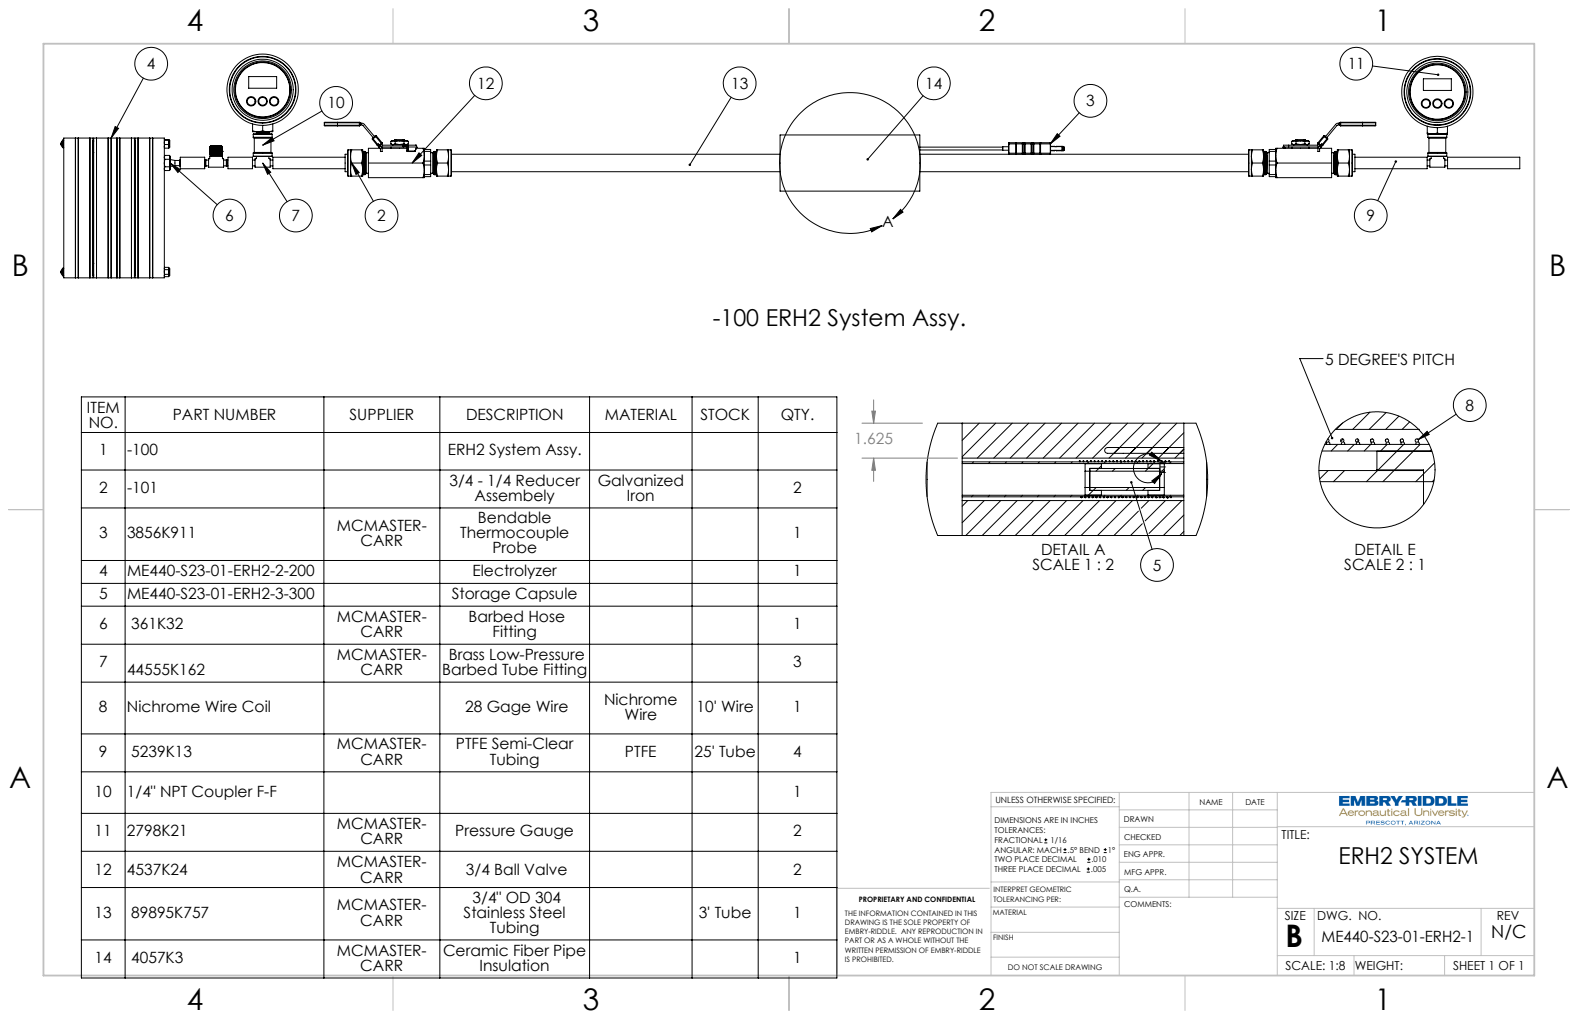
[picture p197: page 1]
-100 ERH2 System Assy.; DETAIL A; SCALE 1 : 2; DETAIL E SCALE 2 : 1; 5 DEGREE'S PITCH; DWG. NO.; REV

ITEM NO. | PART NUMBER | SUPPLIER | DESCRIPTION | MATERIAL | STOCK | QTY.

1 | -100 | | ERH2 System Assy.
2 | -101 | | 3/4 - 1/4 Reducer Assembely | Galvanized Iron | | 2
3 | 3856K911 | MCMASTER-CARR | Bendable Thermocouple Probe | | | 1

4 | ME440-S23-01-ERH2-2-200 | | Electrolyzer | | | 1
5 | ME440-S23-01-ERH2-3-300 | | Storage Capsule
6 | 361K32 | MCMASTER-CARR | Barbed Hose Fitting | | | 1
7 | 44555K162 | MCMASTER-CARR | Brass Low-Pressure Barbed Tube Fitting | | | 3

8 | Nichrome Wire Coil | | 28 Gage Wire | Nichrome Wire | 10' Wire | 1

9 | 5239K13 | MCMASTER-CARR | PTFE Semi-Clear Tubing | PTFE | 25' Tube | 4

10 | 1/4" NPT Coupler F-F | | | | | 1
11 | 2798K21 | MCMASTER-CARR | Pressure Gauge | | | 2
12 | 4537K24 | MCMASTER-CARR | 3/4 Ball Valve | | | 2
13 | 89895K757 | MCMASTER-CARR | 3/4" OD 304 Stainless Steel Tubing | | 3' Tube | 1 | PROPRIETARY AND CONFIDENTIAL THE INFORMATION CONTAINED IN THIS DRAWING IS THE SOLE PROPERTY OF EMBRY-RIDDLE. ANY REPRODUCTION IN PART OR AS A WHOLE WITHOUT THE WRITTEN PERMISSION OF EMBRY-RIDDLE IS PROHIBITED.

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

CHECKED | | | TITLE: ERH2 SYSTEM

ENG APPR.
MFG APPR.

INTERPRET GEOMETRIC TOLERANCING PER: | Q.A.

14 | 4057K3 | MCMASTER-CARR | Ceramic Fiber Pipe Insulation | | | 1

DO NOT SCALE DRAWING | SCALE: 1:8 | WEIGHT: | SHEET 1 OF 1
