dylanastrup/erh2/TeamsFiles_5_1_2023/Solidworks/ERH2_3.6.23.pdf

B | B

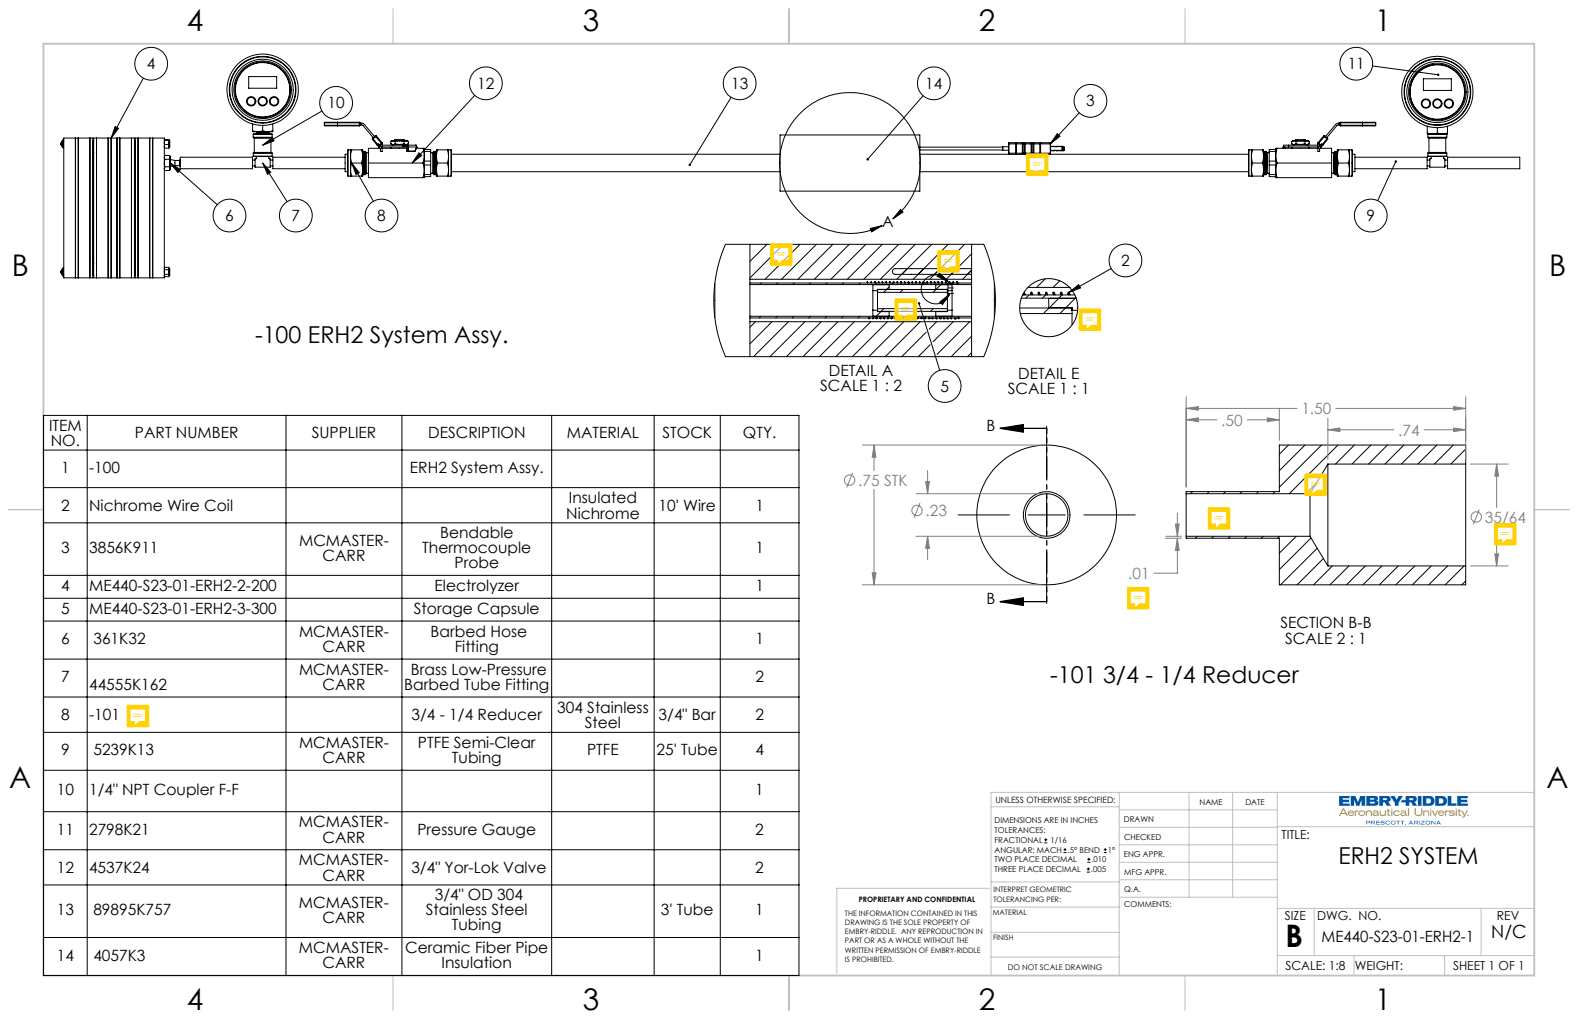
[picture p198: page 1]
-100 ERH2 System Assy.; DETAIL A; SCALE 1 : 2; .75 STK; SECTION B-B SCALE 2 : 1; DETAIL E SCALE 1 : 1; -101 3/4 - 1/4 Reducer; MCMASTER-; CARR; Pressure Gauge; 3/4" Yor-Lok Valve; 3/4" OD 304 Stainless Steel Tubing; 3' Tube; ME440-S23-01-ERH2-1; DWG. NO.; REV; SIZE; NAME; DATE; COMMENTS:; DRAWN; FINISH; MATERIAL; INTERPRET GEOMETRIC TOLERANCING PER:; TWO PLACE DECIMAL

ITEM NO. | PART NUMBER | SUPPLIER | DESCRIPTION | MATERIAL | STOCK | QTY.

1 | -100 | | ERH2 System Assy.
2 | Nichrome Wire Coil | | | Insulated Nichrome | 10' Wire | 1
3 | 3856K911 | MCMASTER-CARR | Bendable Thermocouple Probe | | | 1

4 | ME440-S23-01-ERH2-2-200 | | Electrolyzer | | | 1
5 | ME440-S23-01-ERH2-3-300 | | Storage Capsule
6 | 361K32 | MCMASTER-CARR | Barbed Hose Fitting | | | 1
7 | 44555K162 | MCMASTER-CARR | Brass Low-Pressure Barbed Tube Fitting | | | 2
8 | -101 | | 3/4 - 1/4 Reducer | 304 Stainless Steel | 3/4" Bar | 2
9 | 5239K13 | MCMASTER-CARR | PTFE Semi-Clear Tubing | PTFE | 25' Tube | 4

10 | 1/4" NPT Coupler F-F | | | | | 1

UNLESS OTHERWISE SPECIFIED:

DIMENSIONS ARE IN INCHES
TOLERANCES:
FRACTIONAL 1/16
ANGULAR: MACH .5° BEND 1°
THREE PLACE DECIMAL .005

CHECKED | TITLE: ERH2 SYSTEM

ENG APPR.
MFG APPR.

PROPRIETARY AND CONFIDENTIAL
THE INFORMATION CONTAINED IN THIS
DRAWING IS THE SOLE PROPERTY OF
EMBRY-RIDDLE. ANY REPRODUCTION IN
PART OR AS A WHOLE WITHOUT THE
WRITTEN PERMISSION OF EMBRY-RIDDLE
IS PROHIBITED.

14 | 4057K3 | MCMASTER-CARR | Ceramic Fiber Pipe Insulation | 1

DO NOT SCALE DRAWING | SCALE: 1:8 | WEIGHT: | SHEET 1 OF 1

B | B

-200 Electrolyzer; ME440-S23-01-ERH2-2; SCALE: 1:2; WEIGHT:; DWG. NO.; REV; SIZE; COMMENTS:; MATERIAL

ITEM NO. | PART NUMBER | SUPPLIER | DESCRIPTION | Material | Stock | QTY.
1 | -200 | | Electrolyzer | | | 1
2 | -201 | | Walls | Polycarbonate | 1/2" Sheet | 2
3 | -202 | | Space | Polycarbonate | 1/2" Sheet | 4
4 | -203 | | Stalactites | Polycarbonate | 1/2" Sheet | 1
5 | -204 | | Copper Bus | Copper | π*10^-2 | 2
6 | -205 | | Mesh | Nickel 400 | 200x200 Mesh | 2
7 | -206 | | Rubber Gasket | Rubber | 1/2" Butyl Rubber | 8
8 | 90272A363 | MCMASTER-CARR | 8-32 4.75" Pan Head Phillips Screw | | | 4
9 | 90631A009 | MCMASTER-CARR | 8-32 Steel Nylon Locknut | | | 4

UNLESS OTHERWISE SPECIFIED: | | NAME | DATE
DIMENSIONS ARE IN INCHES TOLERANCES: FRACTIONAL 1/16 ANGULAR: MACH .5° BEND 1° TWO PLACE DECIMAL .010 THREE PLACE DECIMAL .005 | DRAWN

CHECKED | | | TITLE: ERH2 Electrolyzer

ENG APPR.
MFG APPR.

INTERPRET GEOMETRIC TOLERANCING PER: | Q.A.

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

B | B

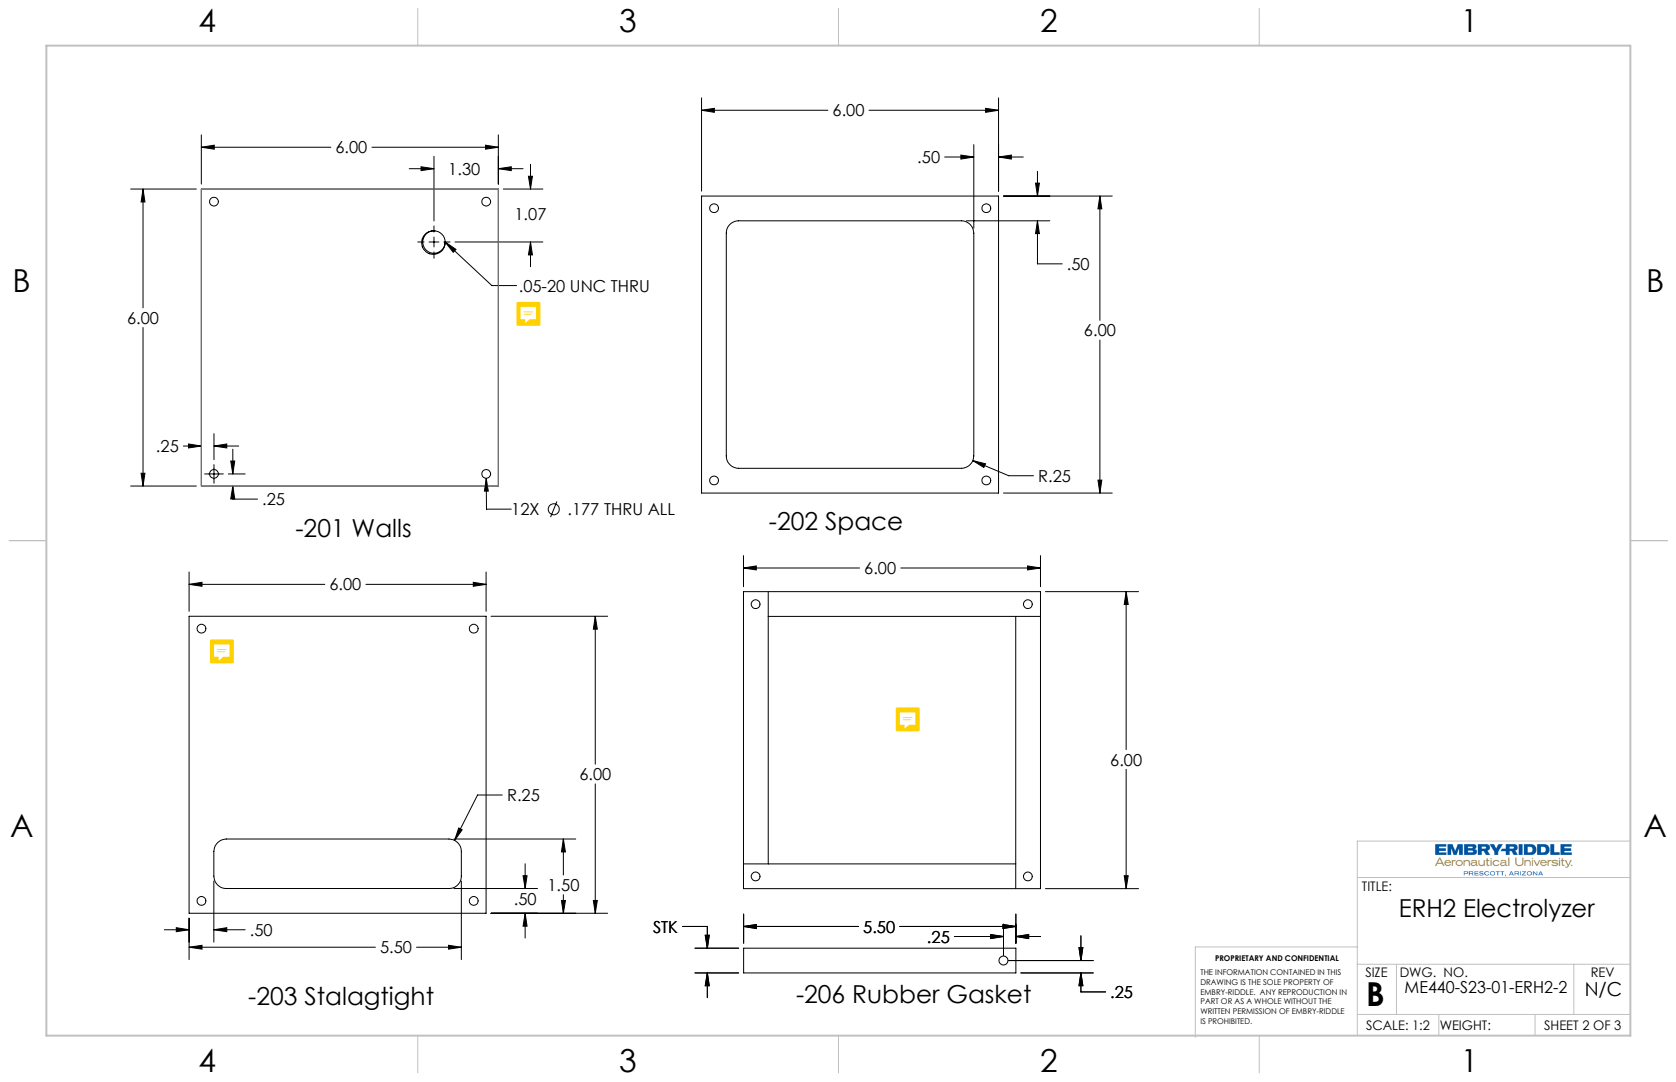
[picture p199: page 3]
STK; .177 THRU ALL .25; .05-20 UNC THRU; -201 Walls; -202 Space; -203 Stalagtight; -206 Rubber Gasket; ERH2 Electrolyzer; TITLE:

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

SIZE B | DWG. NO. ME440-S23-01-ERH2-2 | REV N/C

SCALE: 1:2 | WEIGHT: | SHEET 2 OF 3

B | B

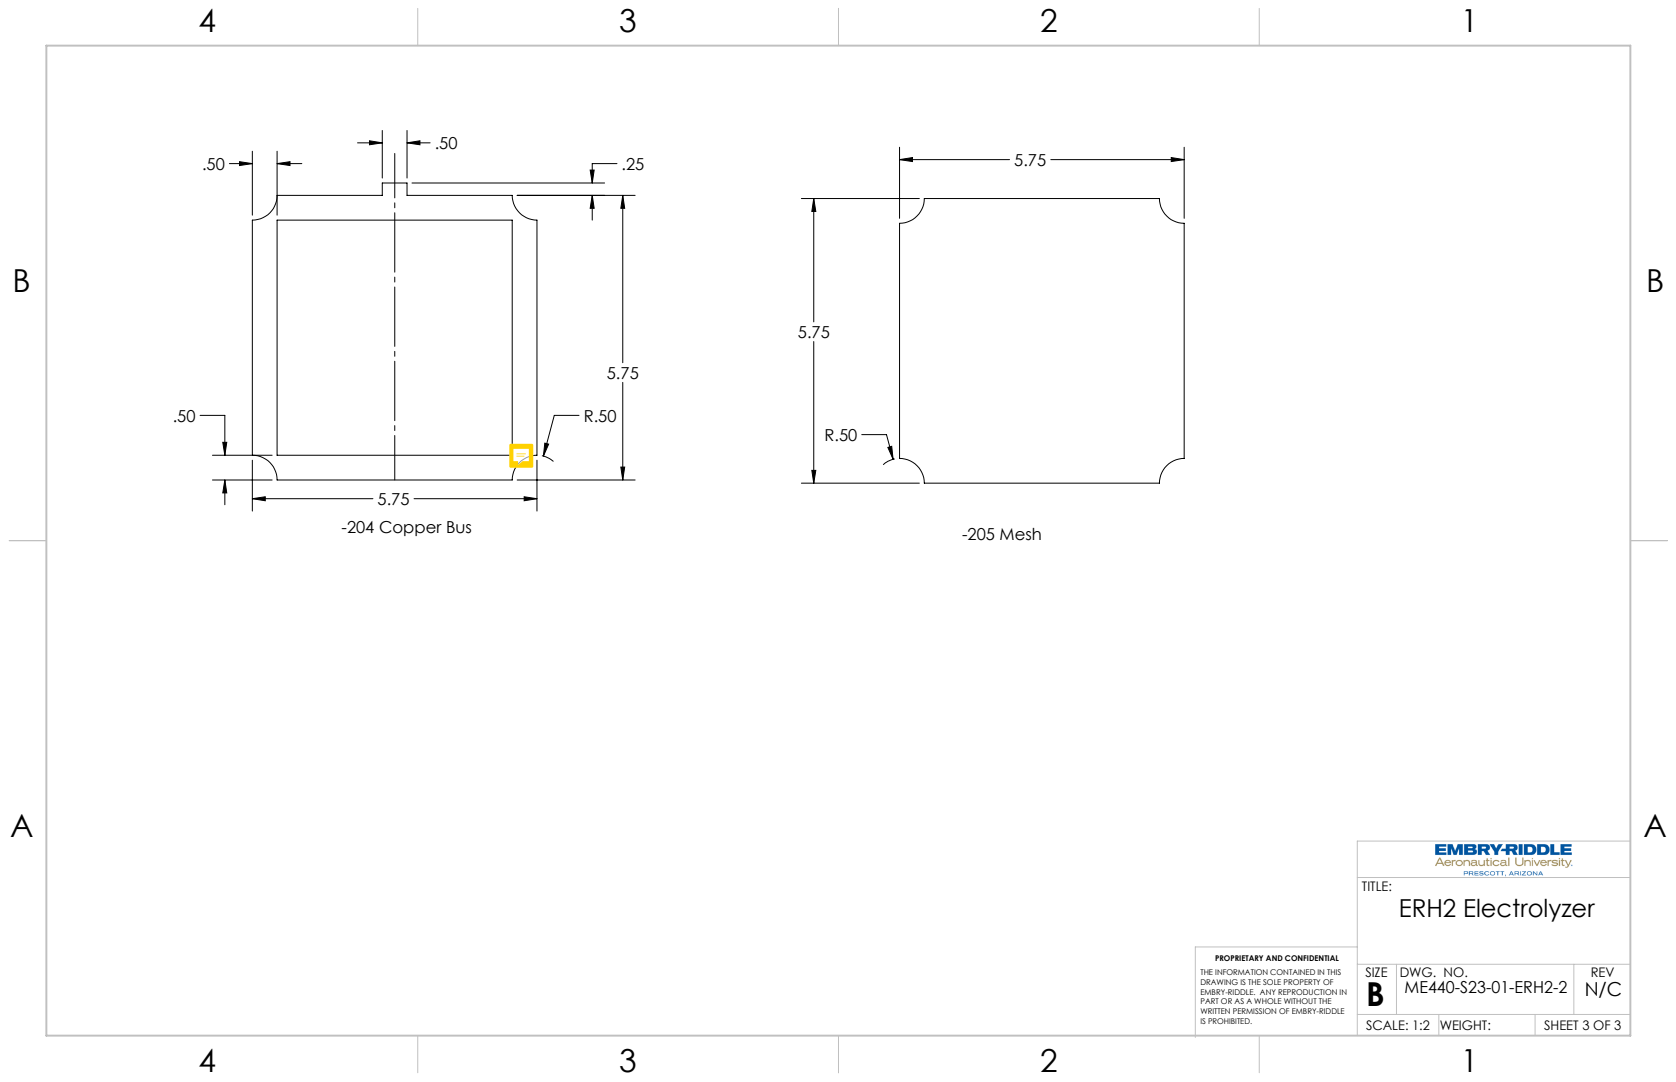
[picture p200: page 4]
-204 Copper Bus; -205 Mesh; ERH2 Electrolyzer; TITLE:

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

SIZE B | DWG. NO. ME440-S23-01-ERH2-2 | REV N/C

SCALE: 1:2 | WEIGHT: | SHEET 3 OF 3

B | B

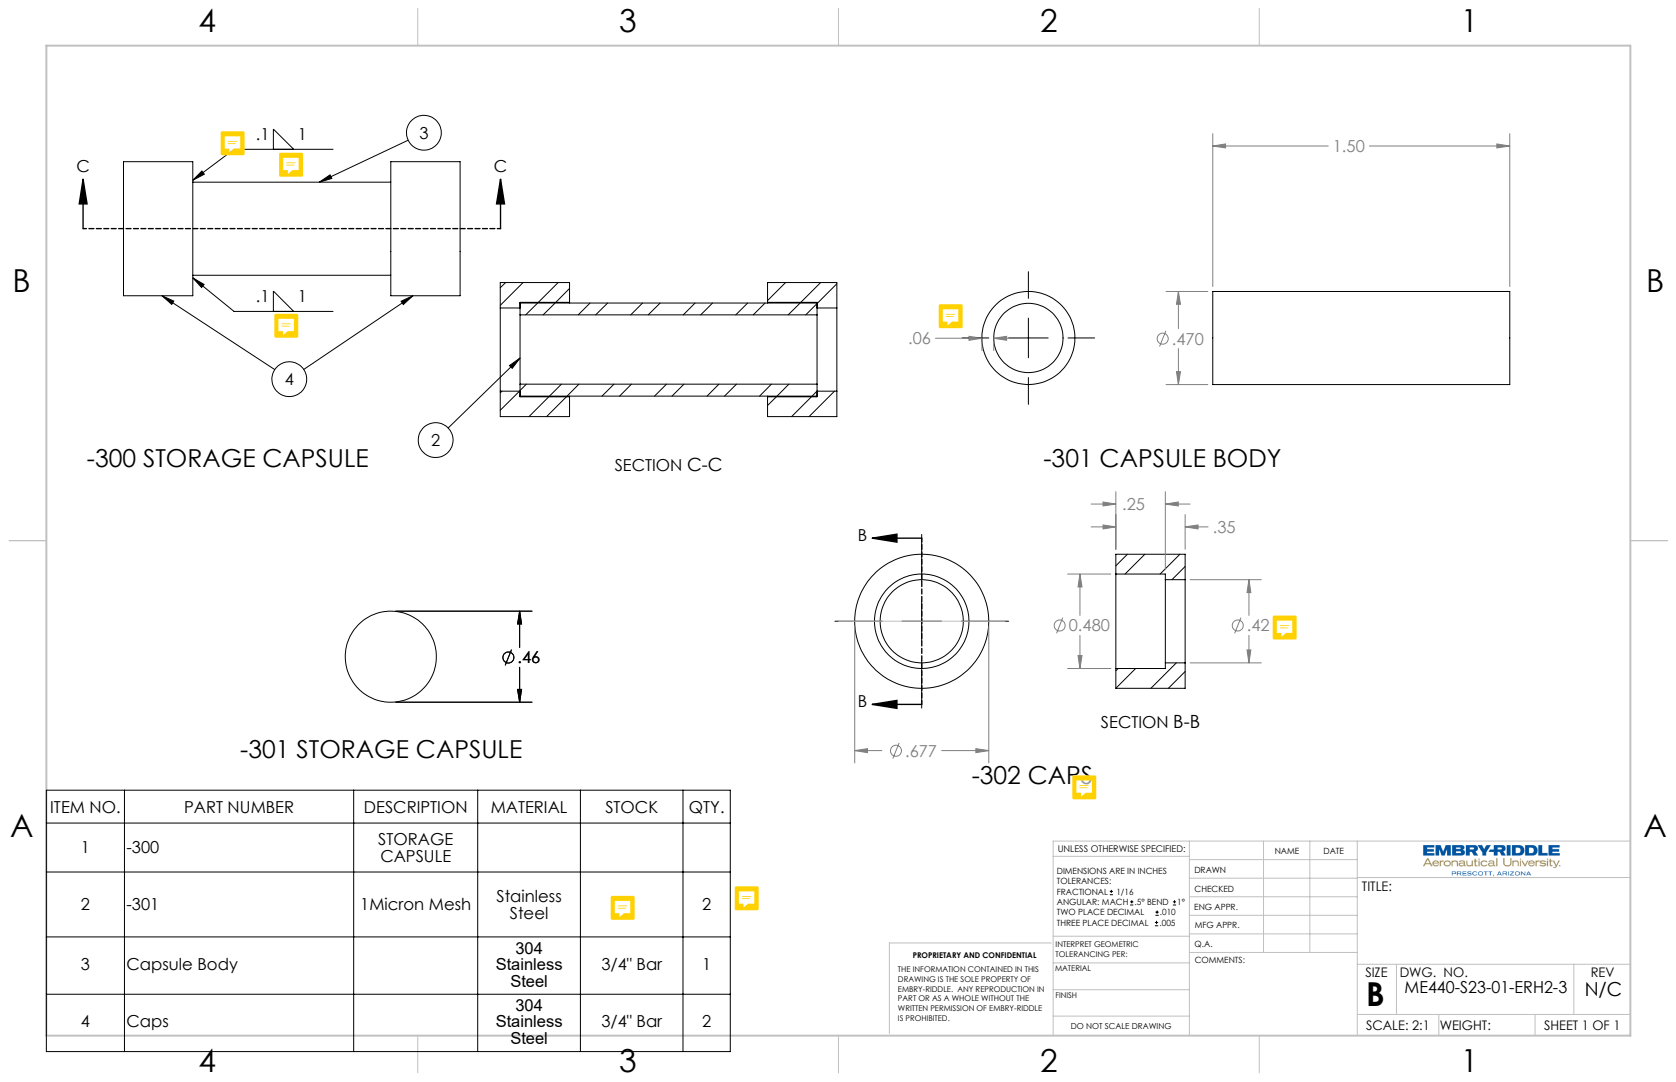
[picture p201: page 5]
SECTION B-B; SECTION C-C; -300 STORAGE CAPSULE; -301 CAPSULE BODY; -302 CAPS; -301 STORAGE CAPSULE; Capsule Body; 304 Stainless Steel; 3/4" Bar; COMMENTS:; INTERPRET GEOMETRIC TOLERANCING PER:

ITEM NO. | PART NUMBER | DESCRIPTION | MATERIAL | STOCK | QTY.
1 | -300 | STORAGE CAPSULE

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

CHECKED | | | TITLE:

2 | -301 | 1Micron Mesh | Stainless Steel | | 2

ENG APPR.
MFG APPR.

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

MATERIAL | SIZE B | DWG. NO. ME440-S23-01-ERH2-3 | REV N/C

4 | Caps | Stainless Steel | 3/4" Bar | 2

SCALE: 2:1 | WEIGHT:
