dylanastrup/erh2/TeamsFiles_5_1_2023/Design/DCP documents/Energyland Layout/Energyland_outline.pdf

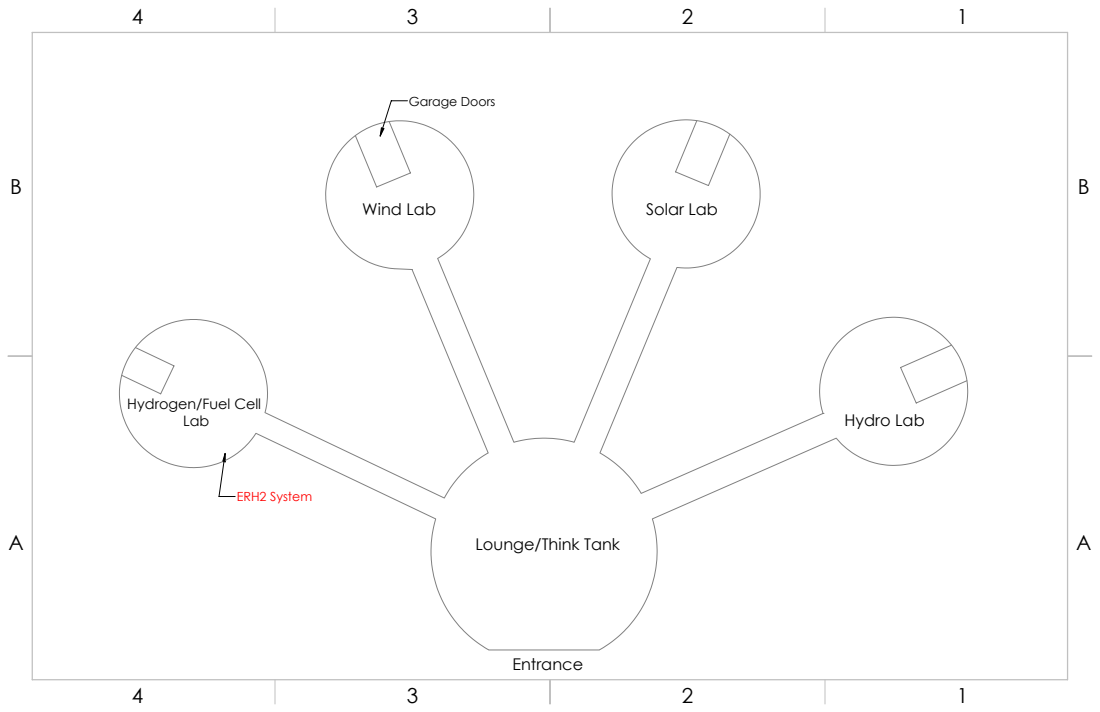
[picture p202: page 1]
Wind Lab; Solar Lab; Hydro Lab; ERH2 System; Garage Doors

Hydrogen/Fuel Cell
Lab

Lounge/Think Tank
