dylanastrup/erh2/TeamsFiles_5_1_2023/Solidworks/Electrolysis/Electrolysis.pdf

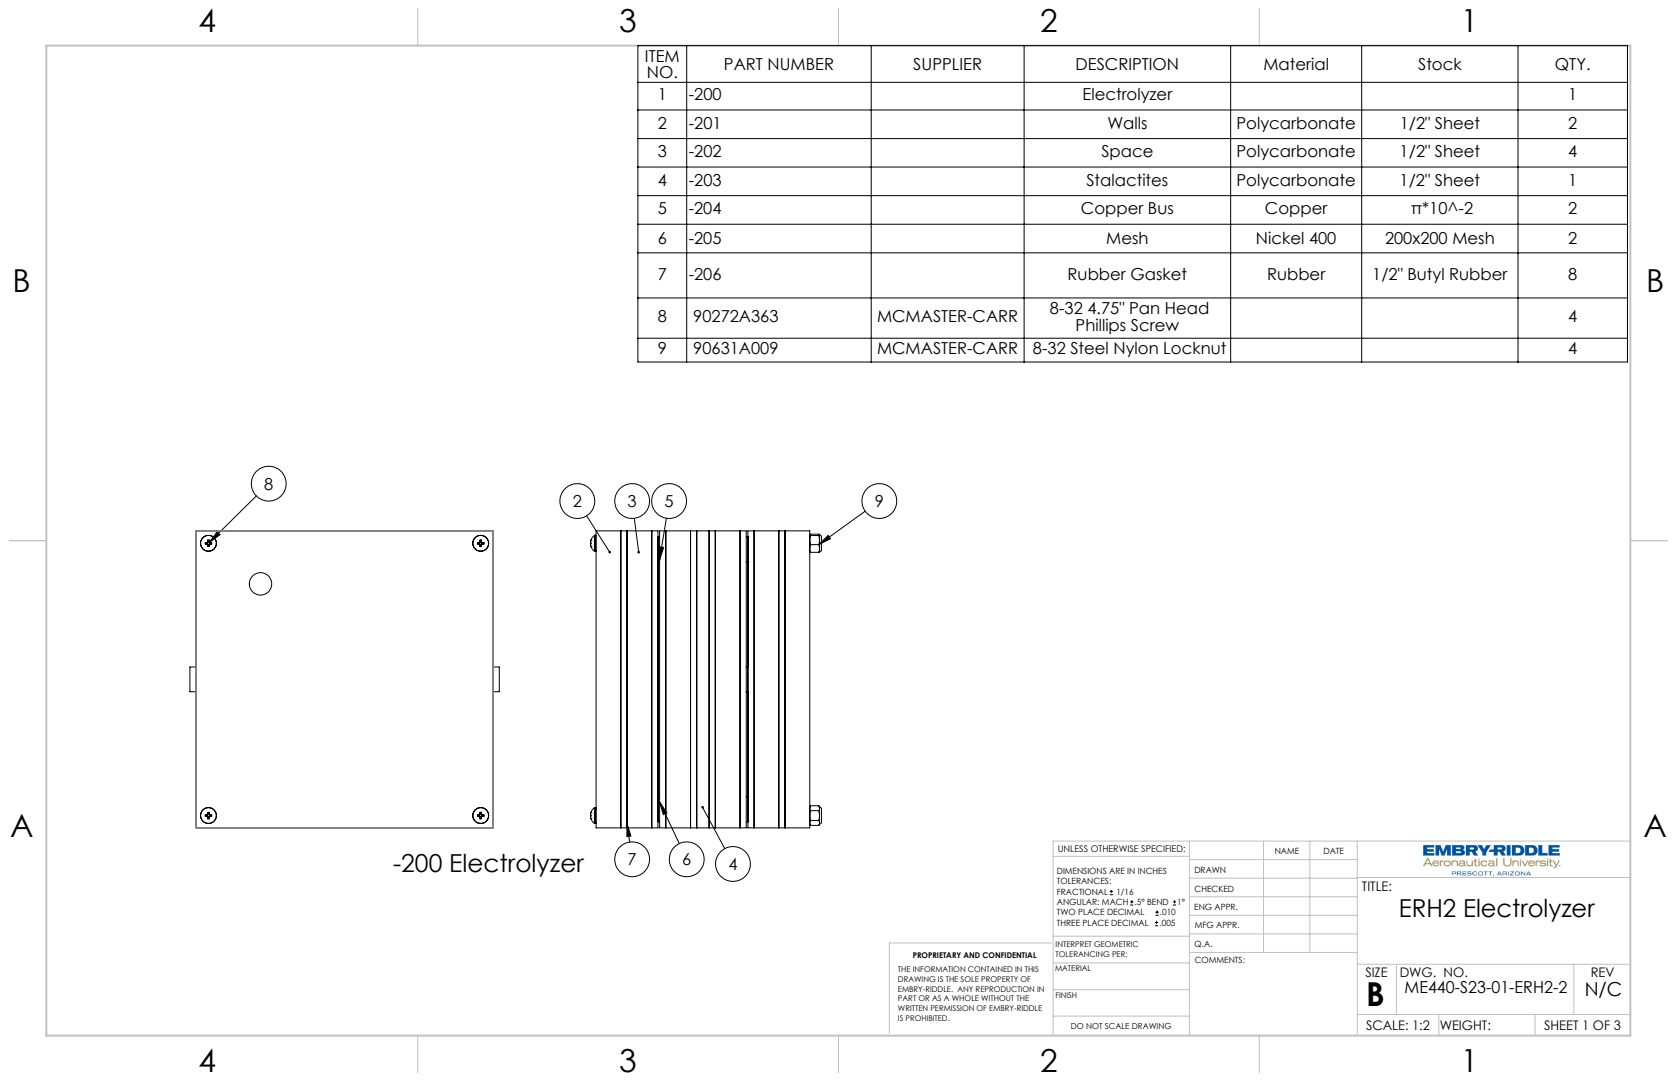
[picture p203: page 1]
-200 Electrolyzer; SHEET 1 OF 3; SCALE: 1:2; WEIGHT:; DWG. NO.; REV

ITEM NO. | PART NUMBER | SUPPLIER | DESCRIPTION | Material | Stock | QTY.
1 | -200 | | Electrolyzer | | | 1
2 | -201 | | Walls | Polycarbonate | 1/2" Sheet | 2
3 | -202 | | Space | Polycarbonate | 1/2" Sheet | 4
4 | -203 | | Stalactites | Polycarbonate | 1/2" Sheet | 1
5 | -204 | | Copper Bus | Copper | π*10^-2 | 2
6 | -205 | | Mesh | Nickel 400 | 200x200 Mesh | 2
7 | -206 | | Rubber Gasket | Rubber | 1/2" Butyl Rubber | 8
8 | 90272A363 | MCMASTER-CARR | 8-32 4.75" Pan Head Phillips Screw | | | 4
9 | 90631A009 | MCMASTER-CARR | 8-32 Steel Nylon Locknut | | | 4

UNLESS OTHERWISE SPECIFIED: | | NAME | DATE
DIMENSIONS ARE IN INCHES TOLERANCES: FRACTIONAL 1/16 ANGULAR: MACH .5° BEND 1° TWO PLACE DECIMAL .010 THREE PLACE DECIMAL .005 | DRAWN

CHECKED | | | TITLE: ERH2 Electrolyzer

ENG APPR.
MFG APPR.

INTERPRET GEOMETRIC TOLERANCING PER: | Q.A.

PROPRIETARY AND CONFIDENTIAL
THE INFORMATION CONTAINED IN THIS
DRAWING IS THE SOLE PROPERTY OF
EMBRY-RIDDLE. ANY REPRODUCTION IN
PART OR AS A WHOLE WITHOUT THE
WRITTEN PERMISSION OF EMBRY-RIDDLE
IS PROHIBITED.

DO NOT SCALE DRAWING

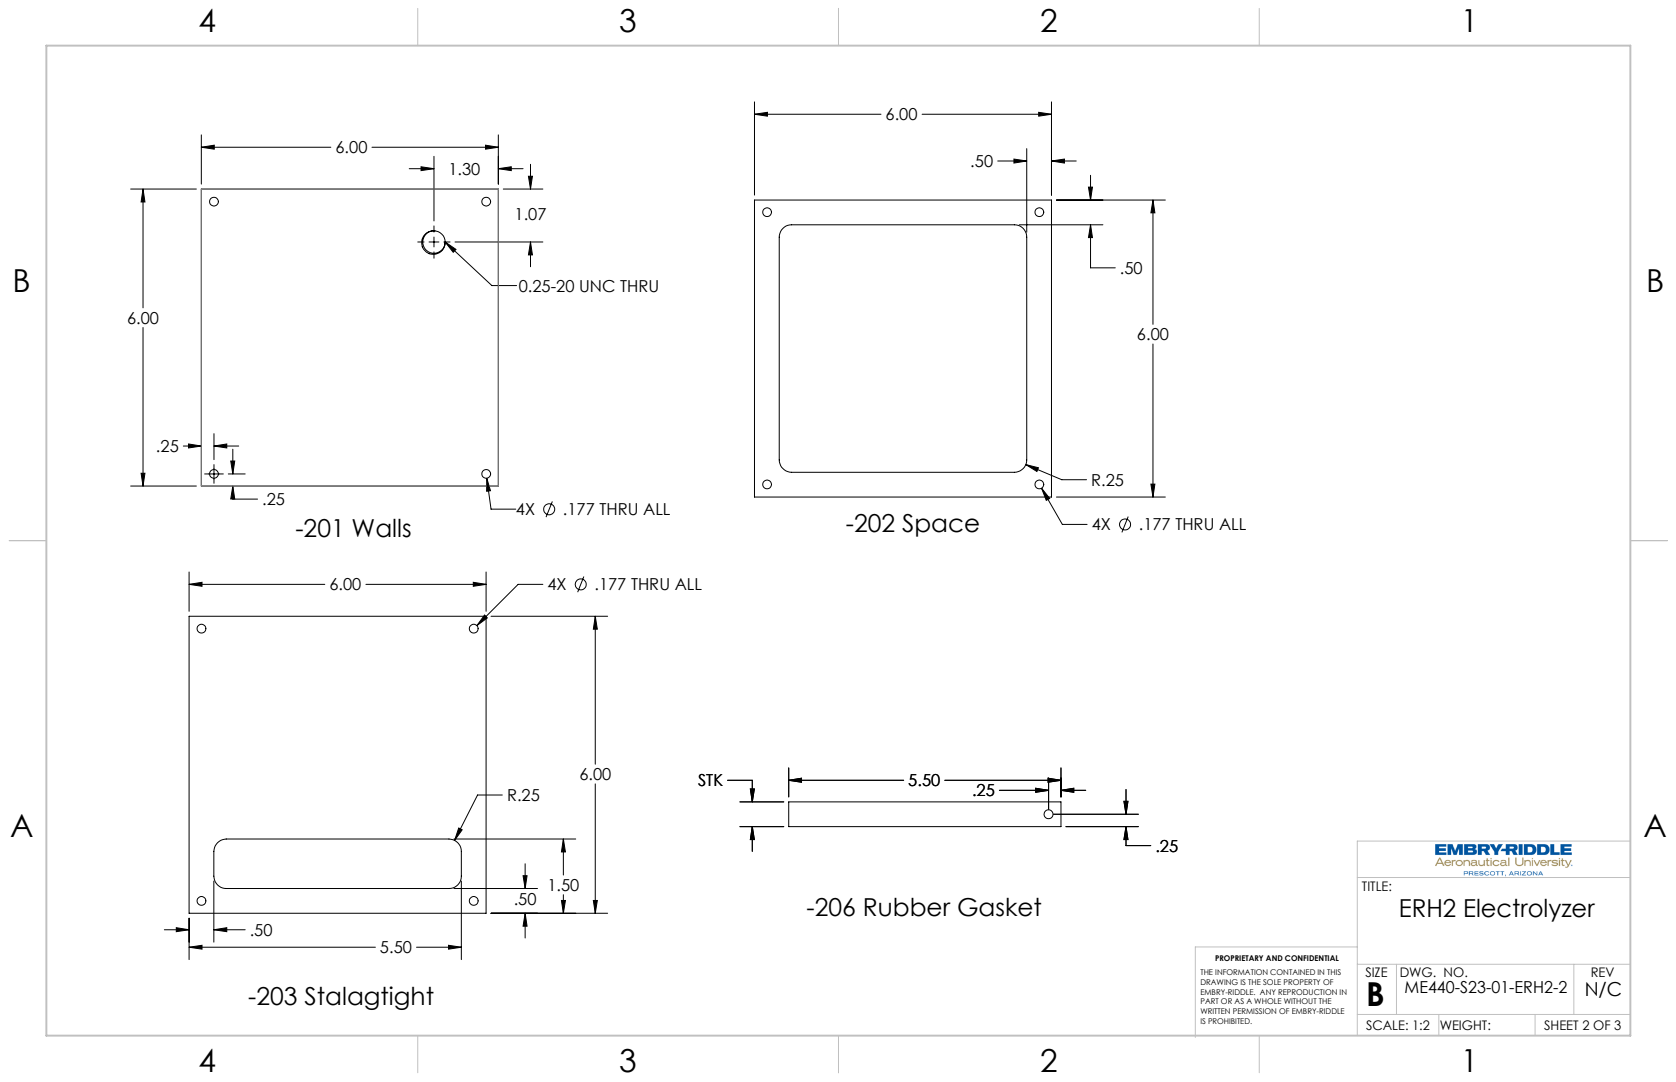
[picture p204: page 2]
.177 THRU ALL .25; 0.25-20 UNC THRU; .177 THRU ALL; -201 Walls; -202 Space; -203 Stalagtight; -206 Rubber Gasket; ERH2 Electrolyzer

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

SIZE B | DWG. NO. ME440-S23-01-ERH2-2 | REV N/C

SCALE: 1:2 | WEIGHT: | SHEET 2 OF 3

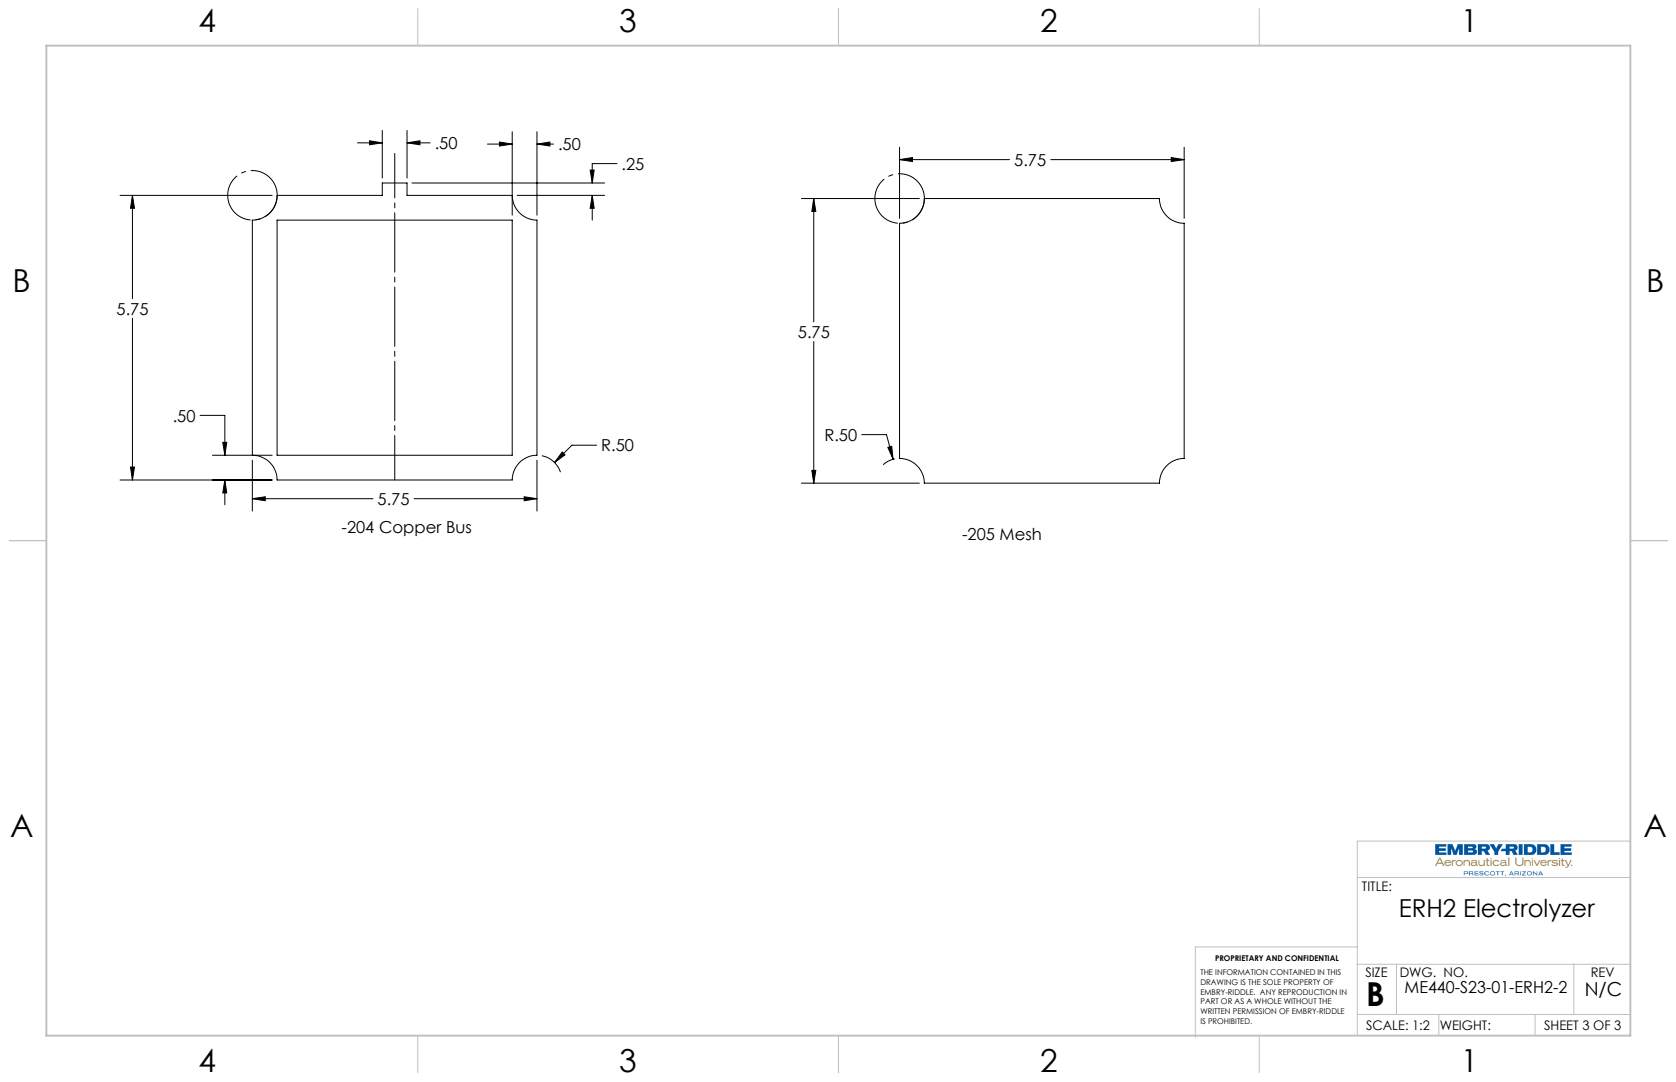
[picture p205: page 3]
-204 Copper Bus; -205 Mesh; ERH2 Electrolyzer

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

SIZE B | DWG. NO. ME440-S23-01-ERH2-2 | REV N/C

SCALE: 1:2 | WEIGHT: | SHEET 3 OF 3
