dylanastrup/erh2/TeamsFiles_5_1_2023/Solidworks/Storage/STORAGEASSEM.pdf

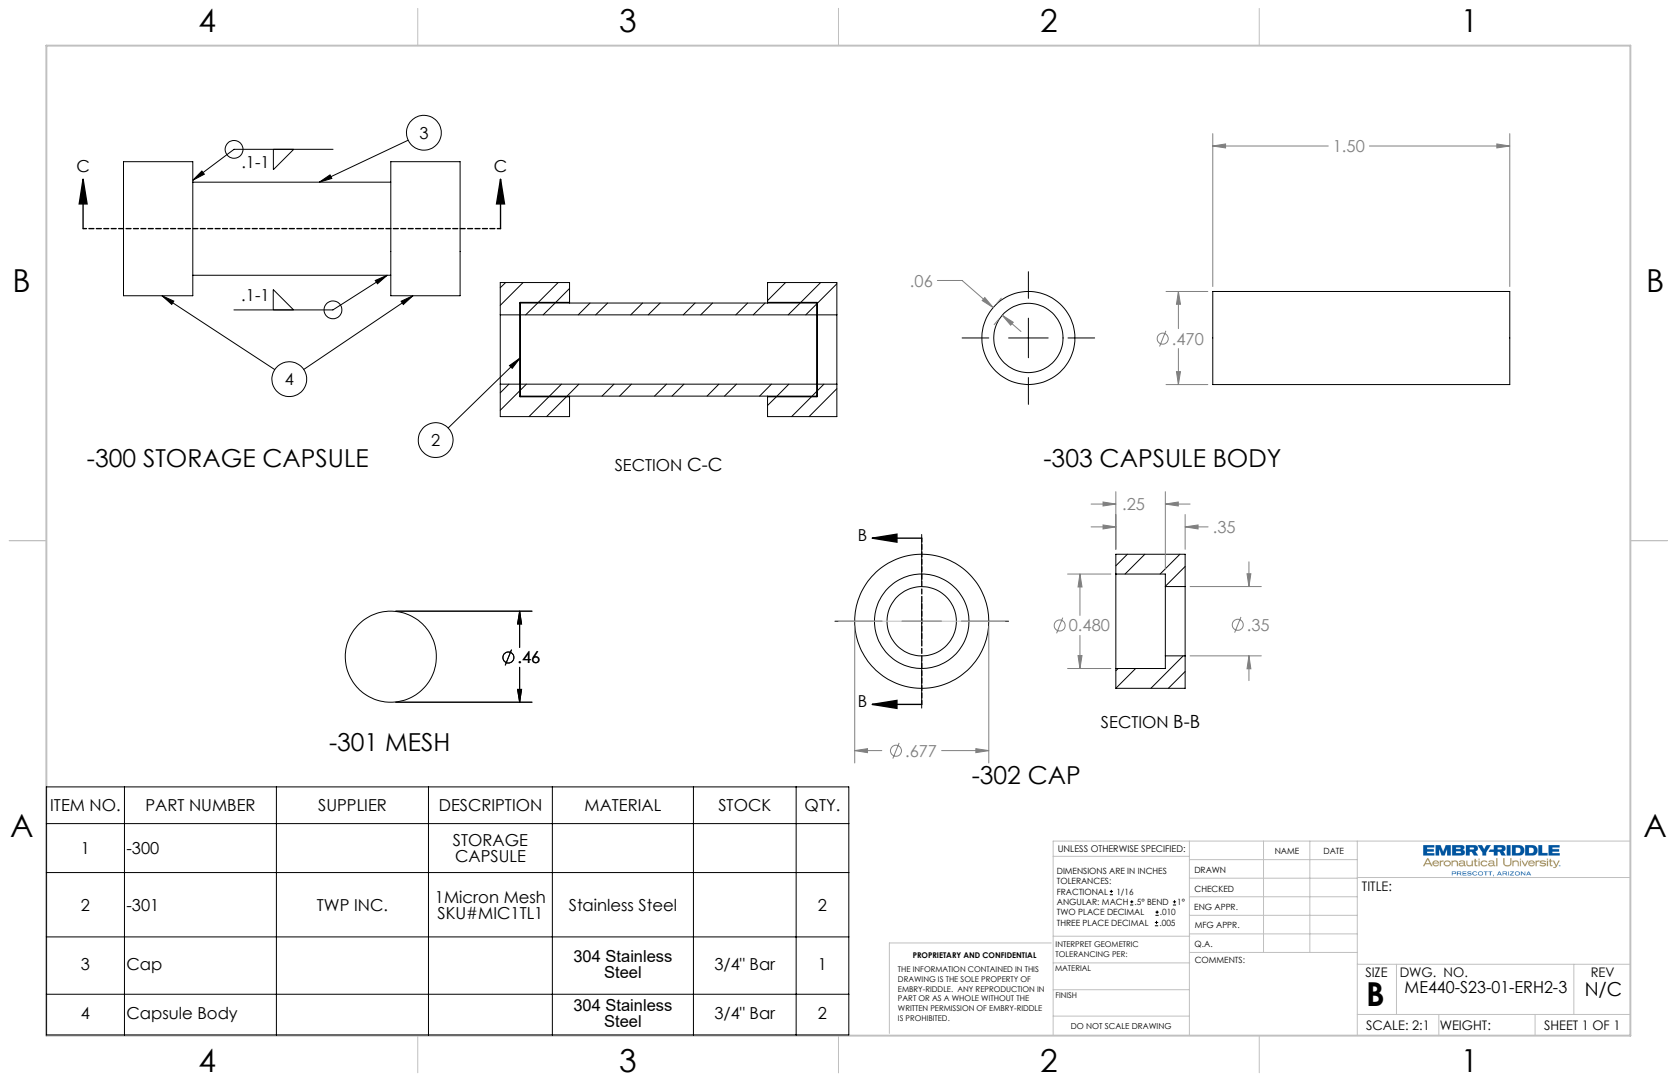
[picture p206: page 1]
SECTION B-B; SECTION C-C; -300 STORAGE CAPSULE; -303 CAPSULE BODY; -302 CAP; -301 MESH; Cap; 304 Stainless; Steel; 3/4" Bar; INTERPRET GEOMETRIC TOLERANCING PER:

ITEM NO. | PART NUMBER | SUPPLIER | DESCRIPTION | MATERIAL | STOCK | QTY.
1 | -300 | | STORAGE CAPSULE

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

CHECKED | | | TITLE:

2 | -301 | TWP INC. | 1Micron Mesh SKU#MIC1TL1 | Stainless Steel | | 2

ENG APPR.
MFG APPR.

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

MATERIAL | SIZE B | DWG. NO. ME440-S23-01-ERH2-3 | REV N/C

4 | Capsule Body | 304 Stainless Steel | 3/4" Bar | 2

DO NOT SCALE DRAWING | SCALE: 2:1 | WEIGHT: | SHEET 1 OF 1
